rcls/gpsfreak/gpsfreak-sch.pdf

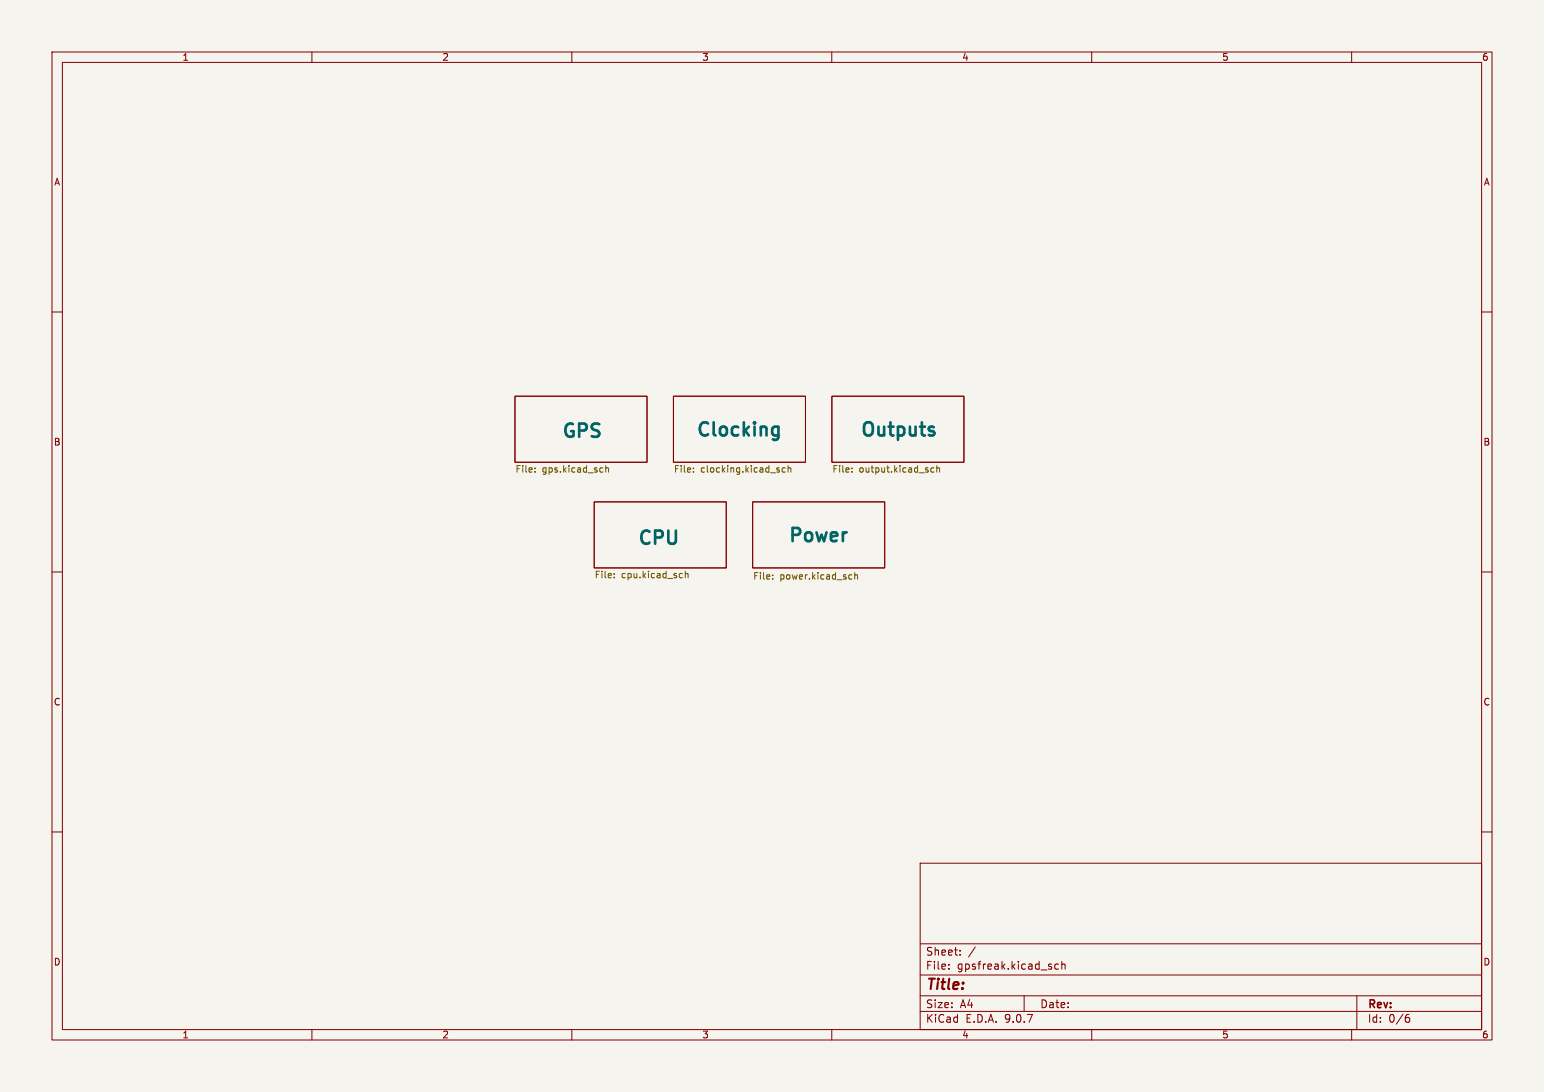
[picture p3: page 1]

Id: 0/6 Title: File: gpsfreak.kicad_sch Sheet: / Clocking

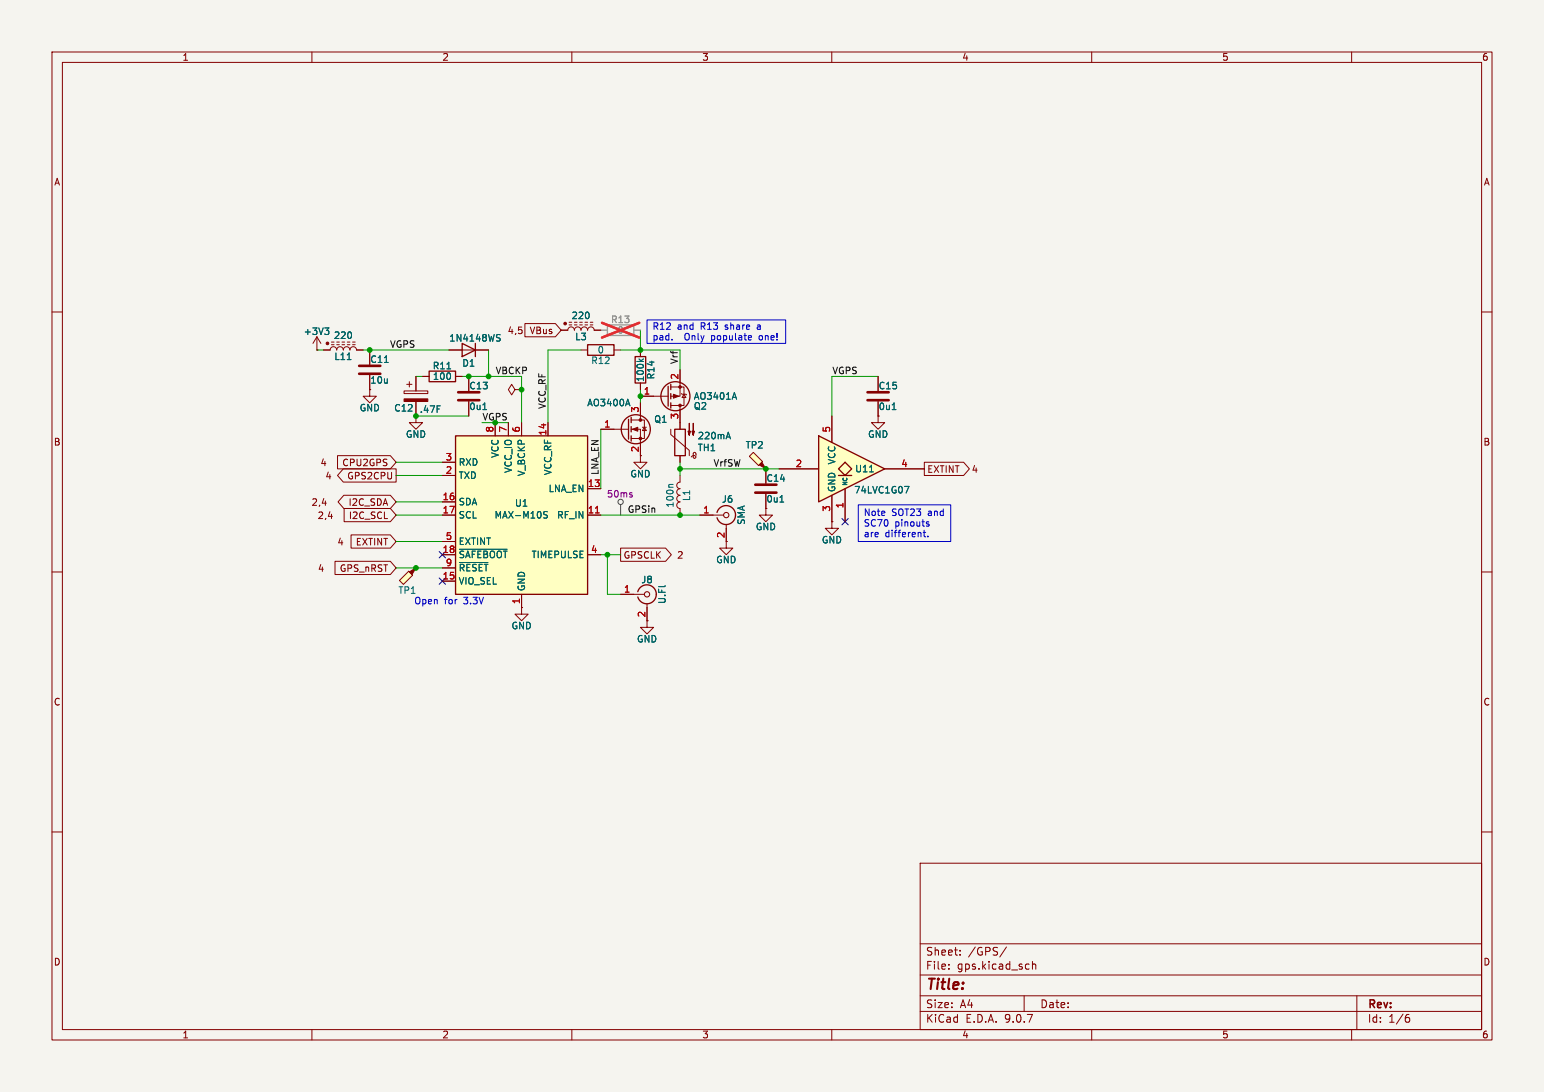
[picture p4: page 2]

Id: 1/6 Title: File: gps.kicad_sch Sheet: /GPS/

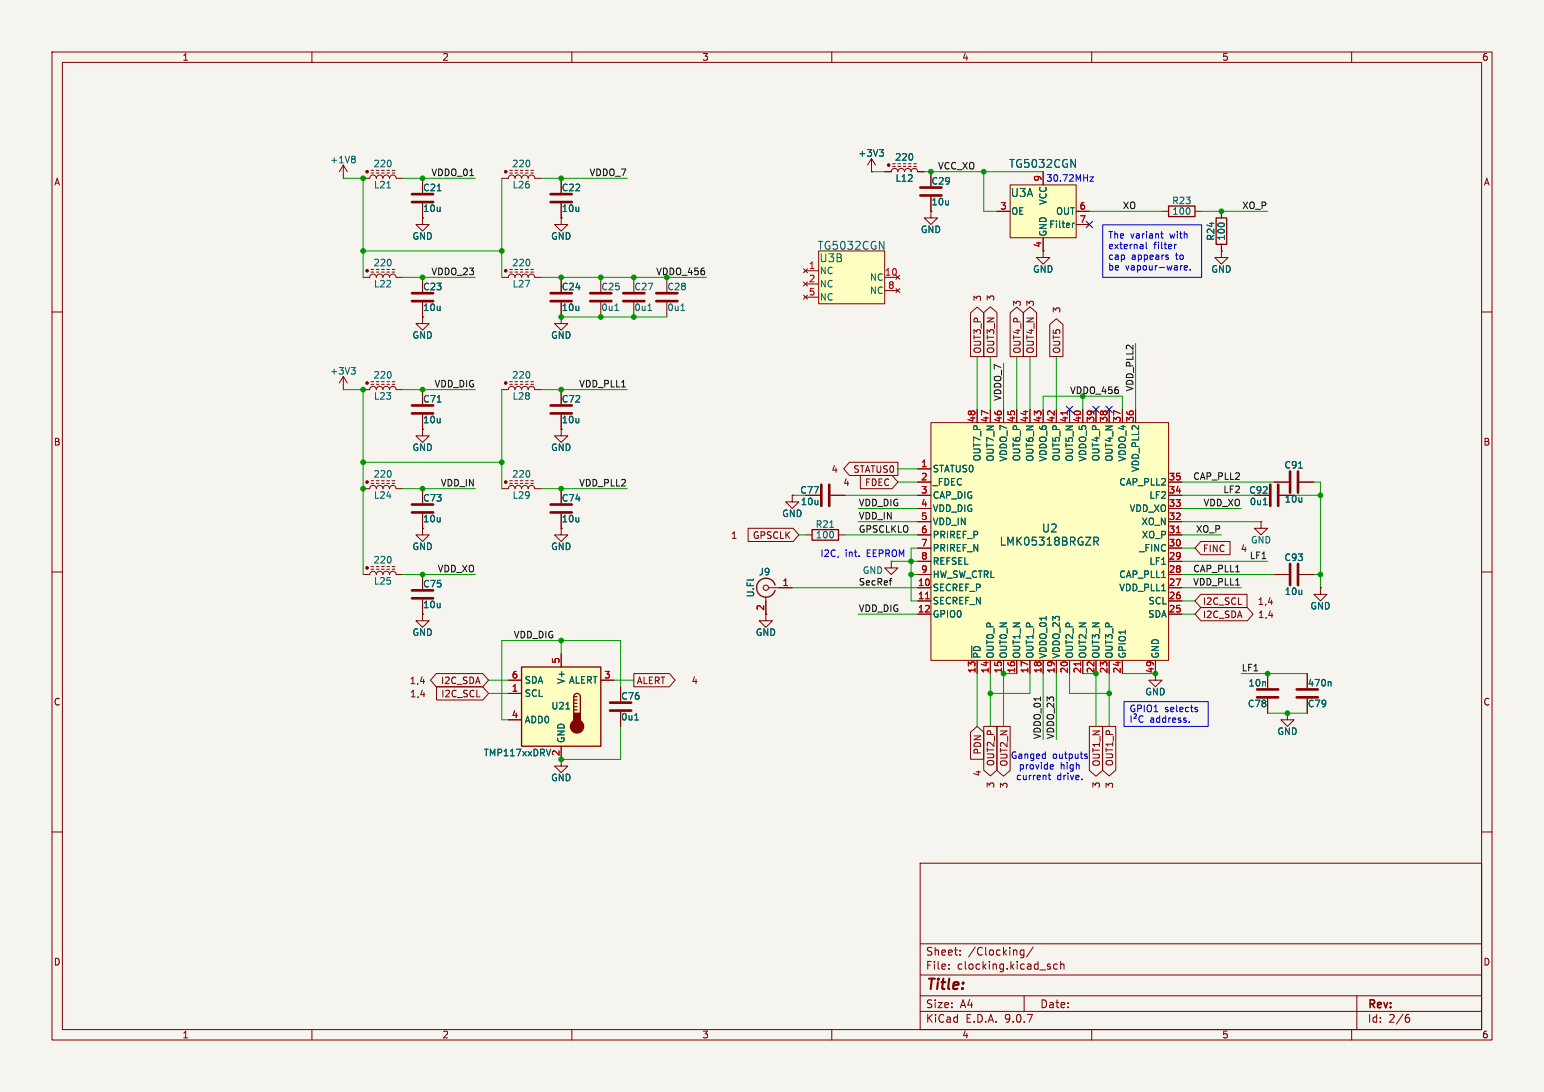
[picture p5: page 3]

XO VDDO_01
be vapour-ware. Ganged outputs provide high

Id: 2/6 Title: File: clocking.kicad_sch Sheet: /Clocking/ GND

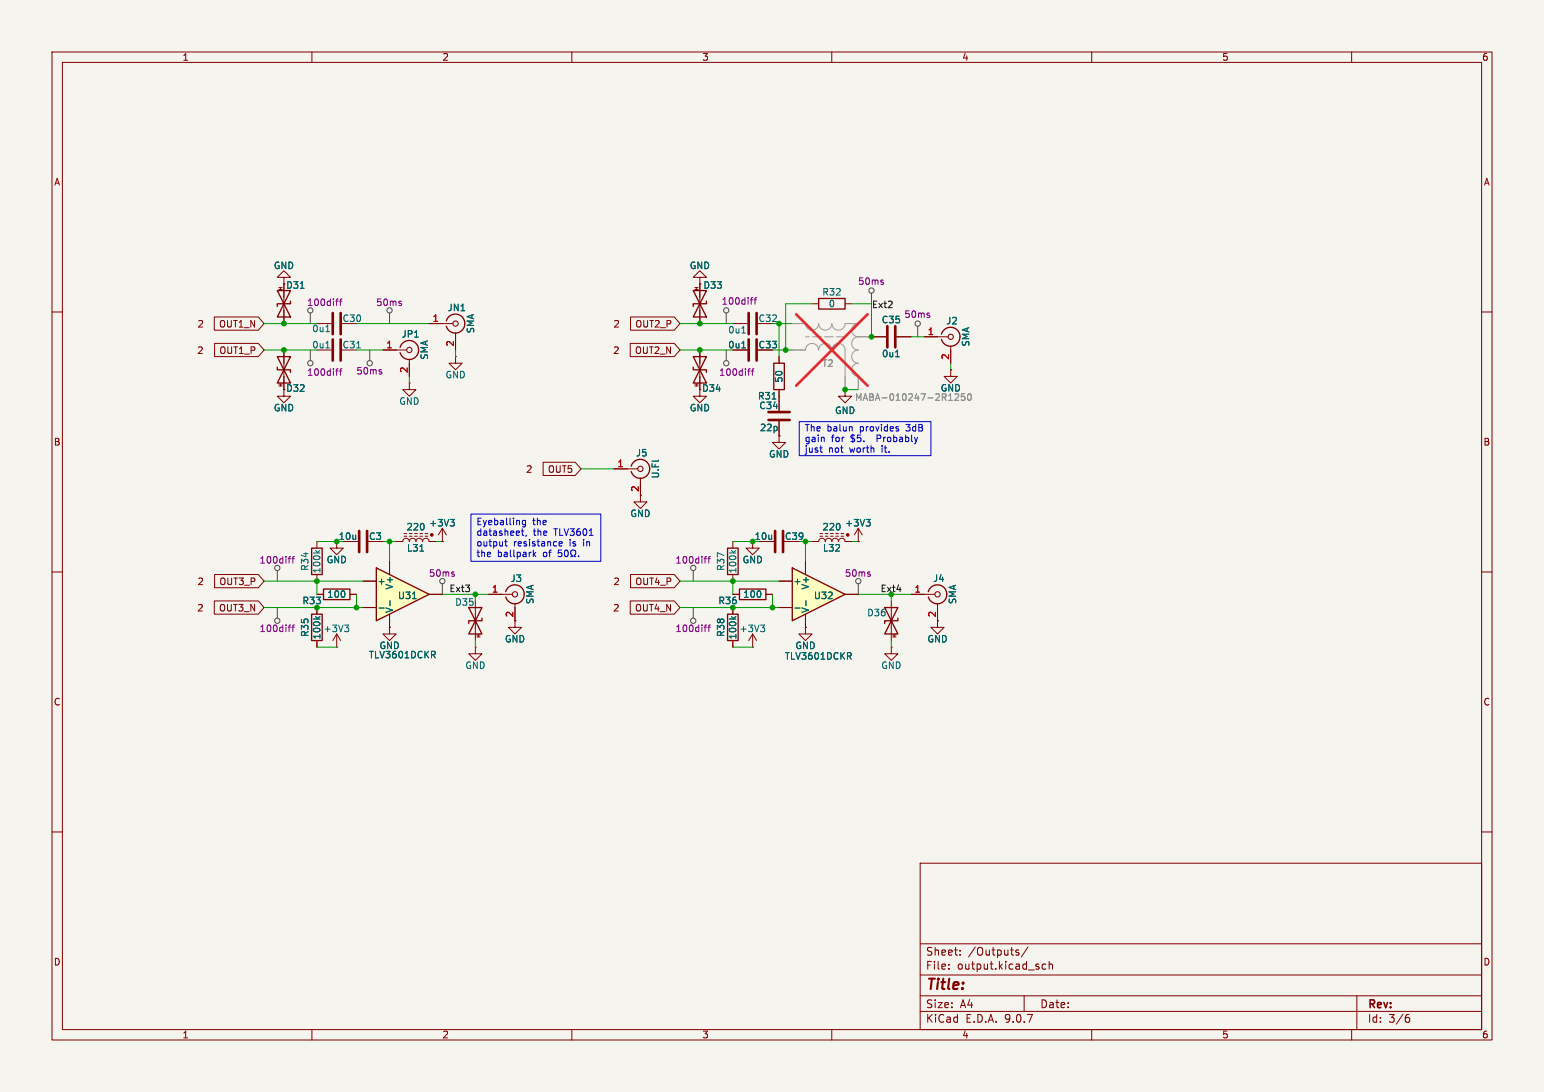
[picture p6: page 4]

Id: 3/6 Title: File: output.kicad_sch Sheet: /Outputs/

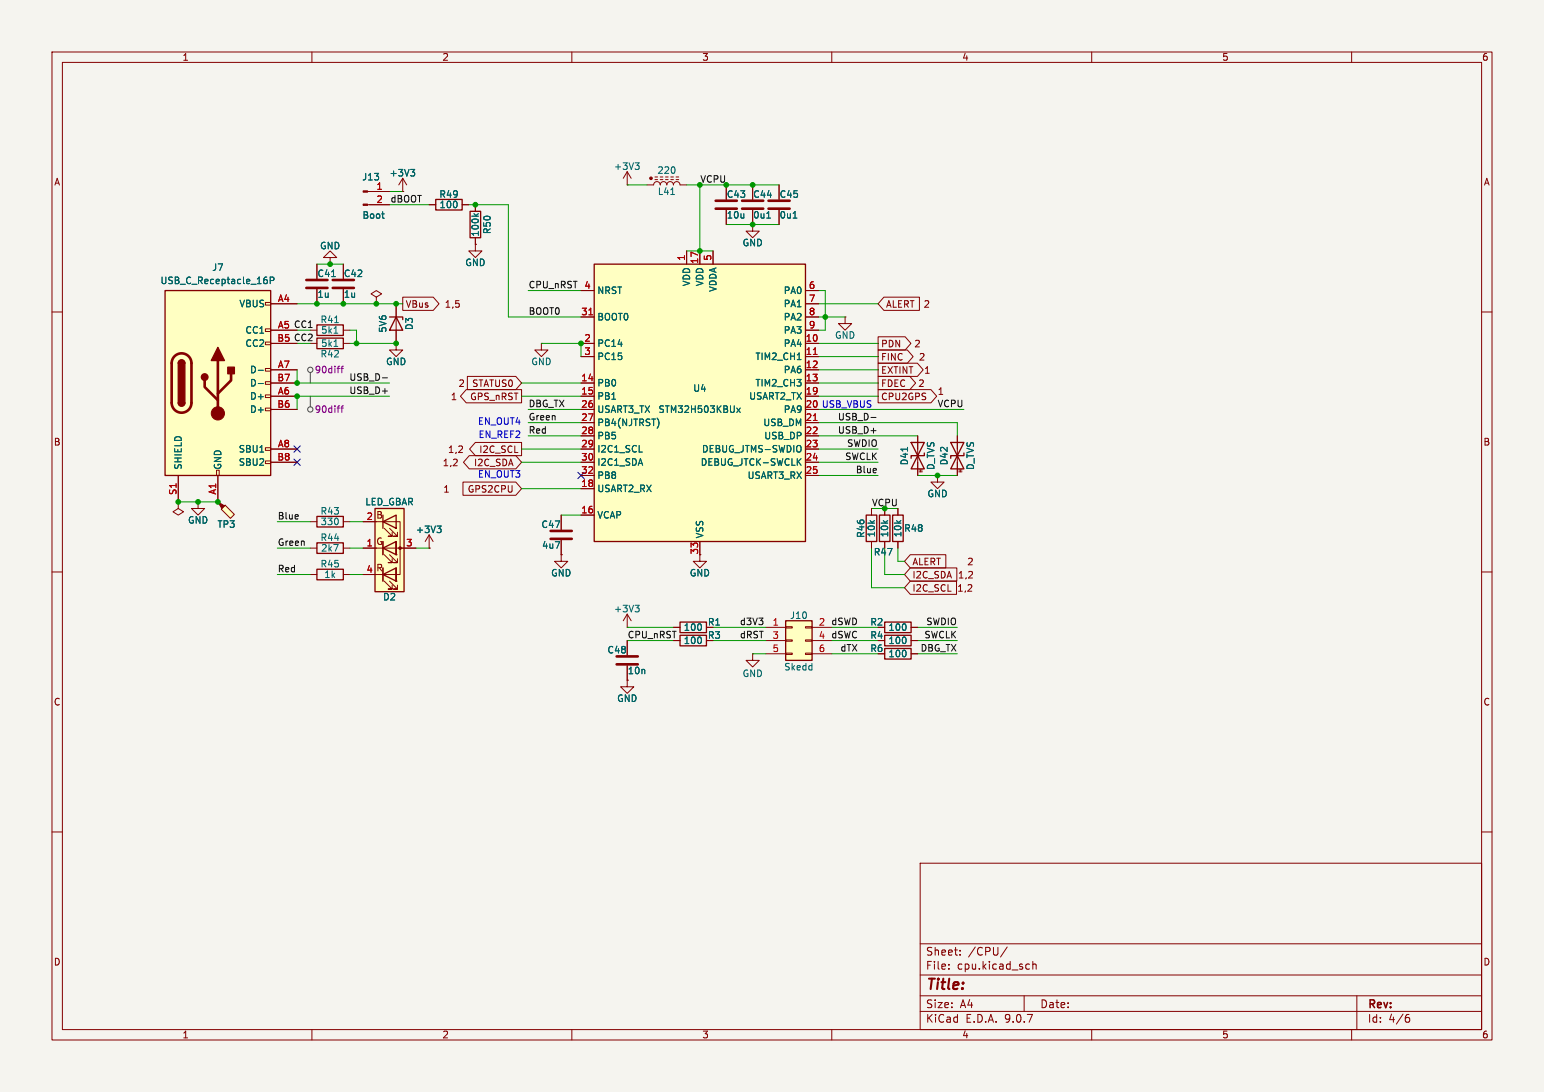
[picture p7: page 5]

Id: 4/6 Title: File: cpu.kicad_sch Sheet: /CPU/ GND

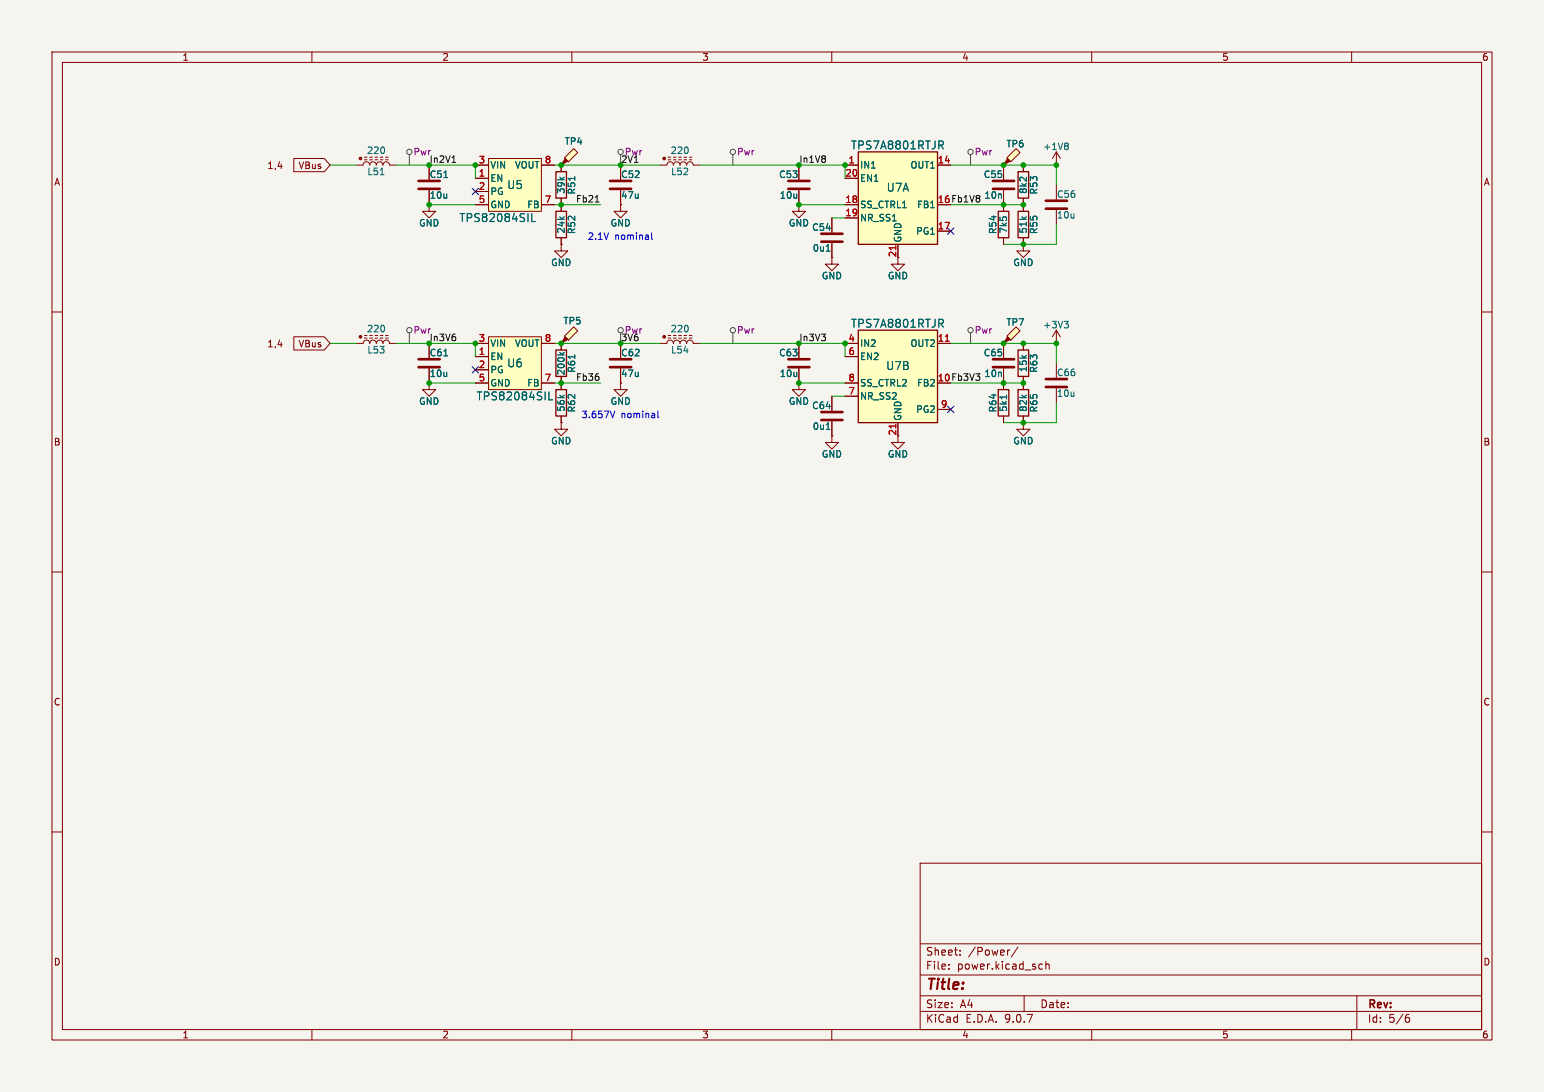
[picture p8: page 6]

Id: 5/6 Title: File: power.kicad_sch Sheet: /Power/
