rcls/gpsfreak/gpsfreak.kicad_pcb

## KiCad design gpsfreak.kicad_pcb (2026-06-07)

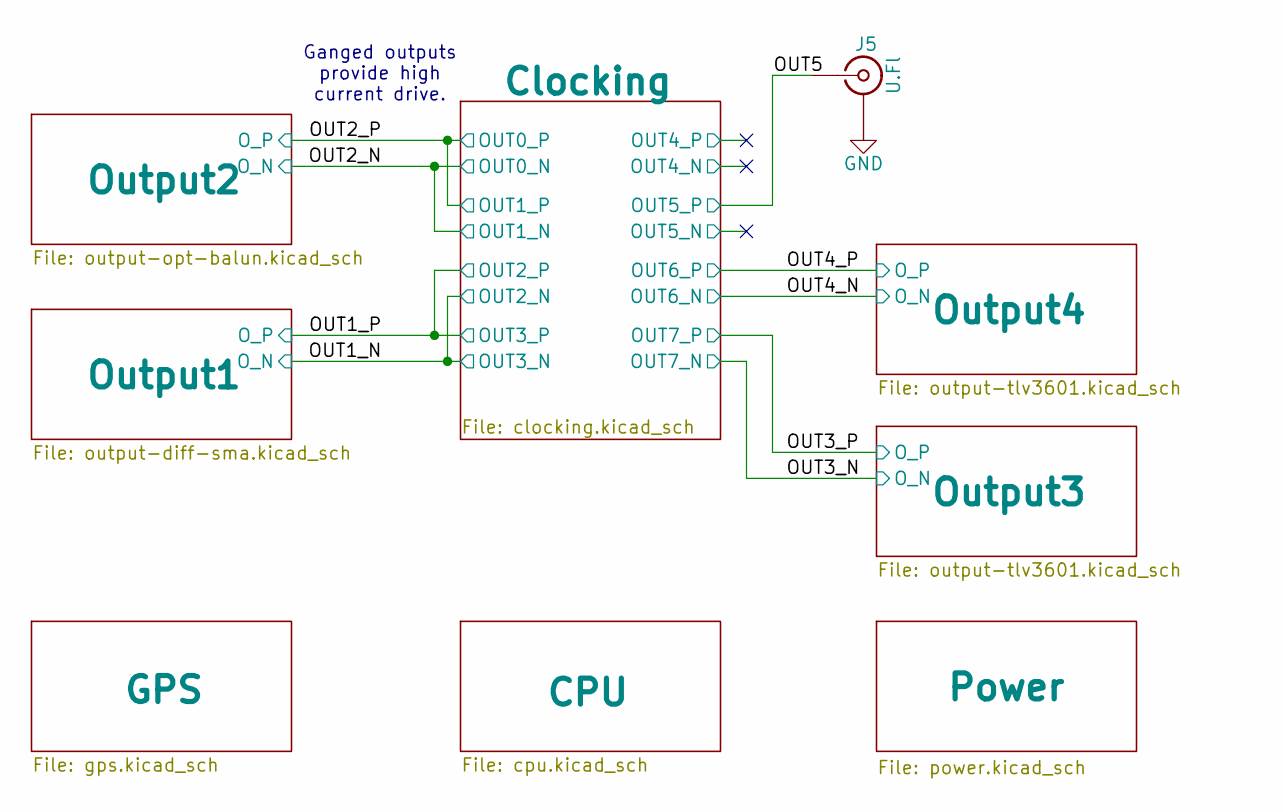
[picture p18: schematic gpsfreak.kicad_sch]

Parts:
J5: U.Fl; U.FL_Hirose_U.FL-R-SMT-1_Vertical

Connections:
/OUT5: J5.1 (In); also elsewhere on the board
GND: J5.2 (Ext); also elsewhere on the board

Notes on the sheet:
Ganged outputs provide high current drive.

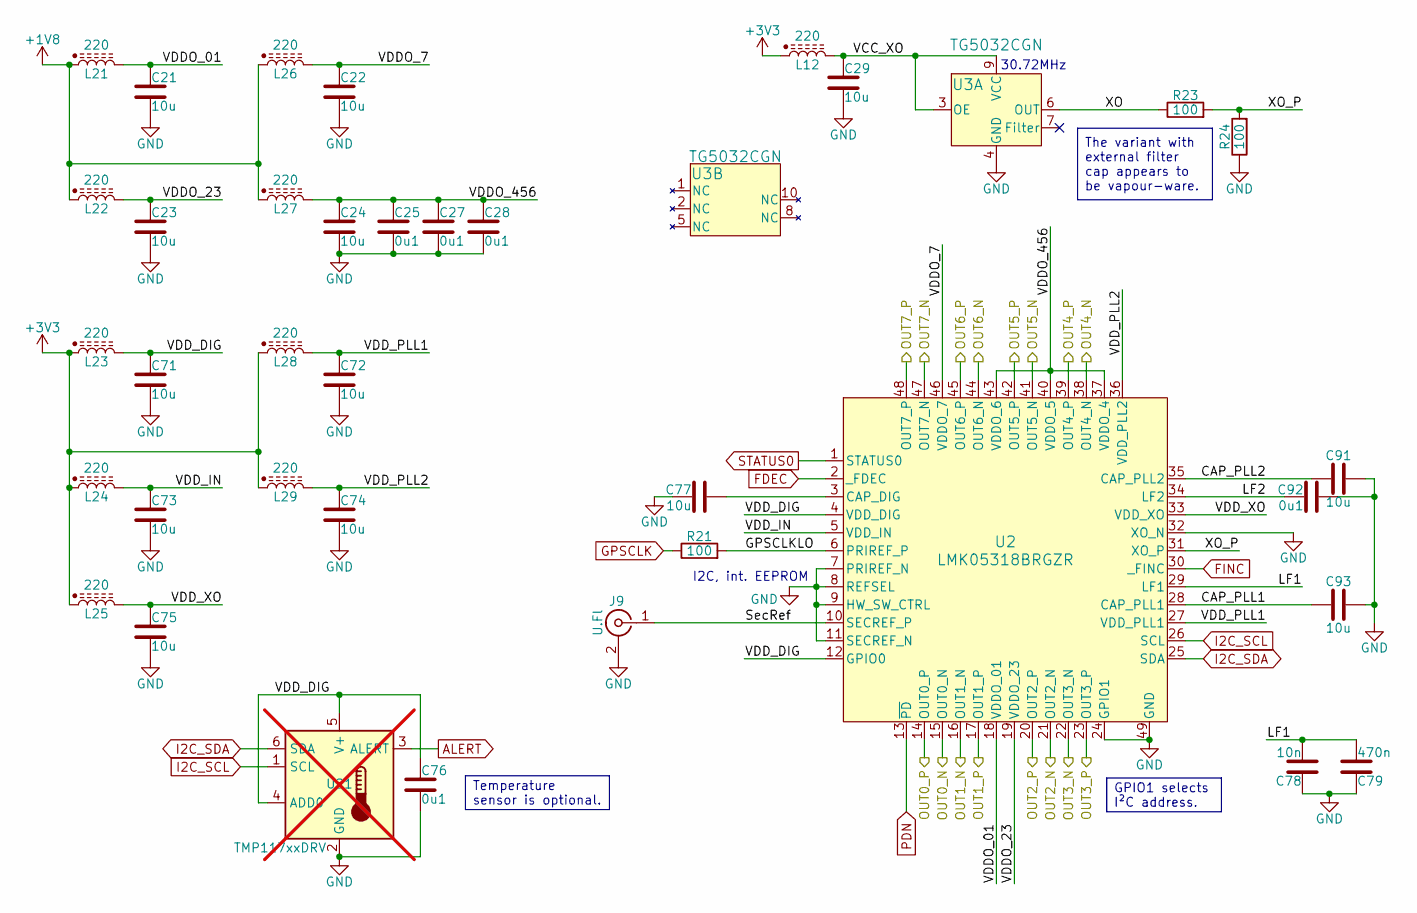
[picture p19: schematic clocking.kicad_sch]

Parts:
C21, C22, C23, C24, C29, C71, C72, C73, C74, C75, C77, C91, C93: 10u; C_0402_1005Metric; LCSC C15525
C25, C27, C28, C76: 0u1; C_0402_1005Metric; LCSC C307331
C78: 10n; C_0402_1005Metric_Pad0.74x0.62mm_HandSolder; LCSC C3855387
C79: 470n; C_1206_3216Metric; LCSC C21082486
C92: 0u1; C0704; LCSC C20044553
J9: U.Fl; U.FL_Hirose_U.FL-R-SMT-1_Vertical
L12, L21, L22, L23, L24, L25, L26, L27, L28, L29: 220; L_0603_1608Metric; LCSC C14709
R21, R23, R24: 100; R_0402_1005Metric; LCSC C25076
U2: LMK05318BRGZR; QFN-48-1EP_7x7mm_P0.5mm_EP5.1x5.1mm; LCSC C3611586
U3: TG5032CGN; QFN10_TG5032CGN 40.0000M-CAGHNA0_EPS; LCSC C2891970
U21: TMP117xxDRV; WSON-6-1EP_2x2mm_P0.65mm_EP1x1.6mm; not fitted

Connections:
+1V8: L21.1, L22.1, L26.1, L27.1; also elsewhere on the board
+3V3: L12.1, L23.1, L24.1, L25.1, L28.1, L29.1; also elsewhere on the board
/Clocking/CAP_PLL1: C93.2, U2.28 (CAP_PLL1)
/Clocking/CAP_PLL2: C91.2, U2.35 (CAP_PLL2)
/Clocking/GPSCLKLO: R21.2, U2.6 (PRIREF_P)
/Clocking/LF1: C78.1, C79.1, U2.29 (LF1)
/Clocking/LF2: C92.1, U2.34 (LF2)
/Clocking/OUT4_N: U2.38 (OUT4_N)
/Clocking/OUT4_P: U2.39 (OUT4_P)
/Clocking/OUT5_N: U2.41 (OUT5_N)
/Clocking/SecRef: J9.1 (In), U2.10 (SECREF_P)
/Clocking/VCC_XO: C29.1, L12.2, U3.3 (OE), U3.9 (VCC)
/Clocking/VDDO_01: C21.1, L21.2, U2.18 (VDDO_01)
/Clocking/VDDO_7: C22.1, L26.2, U2.46 (VDDO_7)
/Clocking/VDDO_23: C23.1, L22.2, U2.19 (VDDO_23)
/Clocking/VDDO_456: C24.1, C25.1, C27.1, C28.1, L27.2, U2.37 (VDDO_4), U2.40 (VDDO_5), U2.43 (VDDO_6)
/Clocking/VDD_DIG: C71.1, C76.1, L23.2, U2.4 (VDD_DIG), U2.12 (GPIO0), U21.4 (ADD0), U21.5 (V+)
/Clocking/VDD_IN: C73.1, L24.2, U2.5 (VDD_IN)
/Clocking/VDD_PLL1: C72.1, L28.2, U2.27 (VDD_PLL1)
/Clocking/VDD_PLL2: C74.1, L29.2, U2.36 (VDD_PLL2)
/Clocking/VDD_XO: C75.1, L25.2, U2.33 (VDD_XO)
/Clocking/XO: R23.1, U3.6 (OUT)
/Clocking/XO_P: R23.2, R24.2, U2.31 (XO_P)
/OUT1_N: U2.21 (OUT2_N), U2.22 (OUT3_N); also elsewhere on the board
/OUT1_P: U2.20 (OUT2_P), U2.23 (OUT3_P); also elsewhere on the board
/OUT2_N: U2.15 (OUT0_N), U2.16 (OUT1_N); also elsewhere on the board
/OUT2_P: U2.14 (OUT0_P), U2.17 (OUT1_P); also elsewhere on the board
/OUT3_N: U2.47 (OUT7_N); also elsewhere on the board
/OUT3_P: U2.48 (OUT7_P); also elsewhere on the board
/OUT4_N: U2.44 (OUT6_N); also elsewhere on the board
/OUT4_P: U2.45 (OUT6_P); also elsewhere on the board
/OUT5: U2.42 (OUT5_P); also elsewhere on the board
ALERT: U21.3 (ALERT); also elsewhere on the board
FDEC: U2.2 (_FDEC); also elsewhere on the board
FINC: U2.30 (_FINC); also elsewhere on the board
GND: C21.2, C22.2, C23.2, C24.2, C25.2, C27.2, C28.2, C29.2, C71.2, C72.2, C73.2, C74.2, C75.2, C76.2, C77.1, C78.2, C79.2, C91.1, C92.2, C93.1, J9.2 (Ext), R24.1, U2.7 (PRIREF_N), U2.8 (REFSEL), U2.9 (HW_SW_CTRL), U2.11 (SECREF_N), U2.24 (GPIO1), U2.32 (XO_N), U2.49 (GND), U3.4 (GND), U21.2 (GND), U21.7 (GND); also elsewhere on the board
GPSCLK: R21.1; also elsewhere on the board
I2C_SCL: U2.26 (SCL), U21.1 (SCL); also elsewhere on the board
I2C_SDA: U2.25 (SDA), U21.6 (SDA); also elsewhere on the board
unnamed: C77.2, U2.3 (CAP_DIG)
PDN: U2.13 (~PD); also elsewhere on the board
STATUS0: U2.1 (STATUS0); also elsewhere on the board

Notes on the sheet:
I2C, int. EEPROM
30.72MHz
Temperature sensor is optional.
GPIO1 selects I²C address.
The variant with external filter cap appears to be vapour-ware.

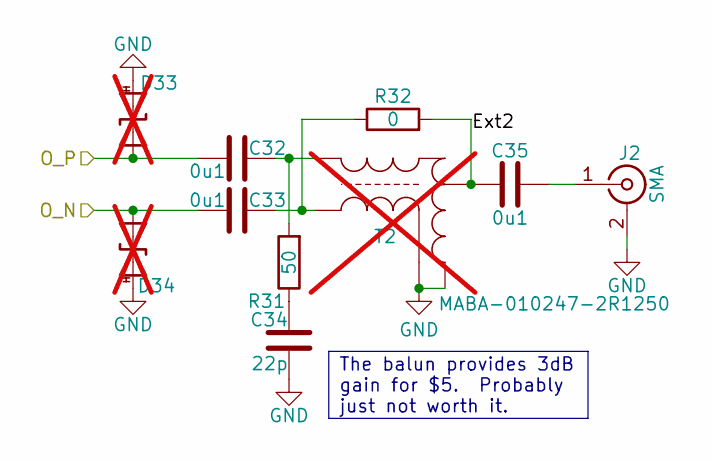
[picture p20: schematic output-opt-balun.kicad_sch]

Parts:
C32, C33, C35: 0u1; C_0402_1005Metric; LCSC C307331
C34: 22p; C_0402_1005Metric; LCSC C1555
D33, D34: D_TVS; HHS_0402; not fitted
J2: SMA; SMA_EdgeMount
R31: 50; R_0603_1608Metric; LCSC C23185
R32: 0; R_0603_1608Metric; LCSC C21189
T2: MABA-010247-2R1250; XFMR_MABA-007159-000000; LCSC C3305191; not fitted

Connections:
/OUT2_N: C33.1, D34.1 (A1); also elsewhere on the board
/OUT2_P: C32.1, D33.1 (A1); also elsewhere on the board
/Output2/Ext2: C35.1, R32.2, T2.4
GND: C34.1, D33.2 (A2), D34.2 (A2), J2.2 (Ext), T2.2, T2.5; also elsewhere on the board
unnamed: C32.2, R31.2, T2.1
unnamed: C33.2, R32.1, T2.3
unnamed: C34.2, R31.1
unnamed: C35.2, J2.1 (In)

Notes on the sheet:
The balun provides 3dB gain for $5. Probably just not worth it.

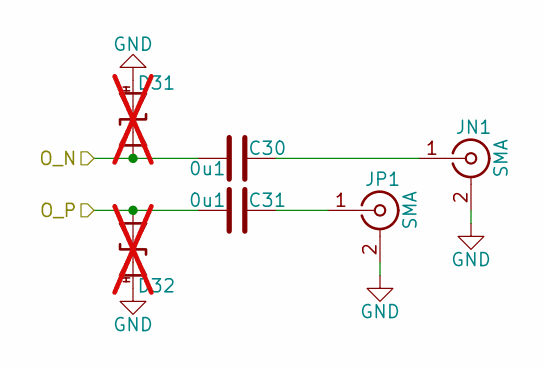
[picture p21: schematic output-diff-sma.kicad_sch]

Parts:
C30, C31: 0u1; C_0402_1005Metric; LCSC C307331
D31, D32: D_TVS; HHS_0402; not fitted
JN1: SMA; SMA_EdgeMount
JP1: SMA; SMA_EdgeMount

Connections:
/OUT1_N: C30.1, D31.1 (A1); also elsewhere on the board
/OUT1_P: C31.1, D32.1 (A1); also elsewhere on the board
GND: D31.2 (A2), D32.2 (A2), JN1.2 (Ext), JP1.2 (Ext); also elsewhere on the board
unnamed: C30.2, JN1.1 (In)
unnamed: C31.2, JP1.1 (In)

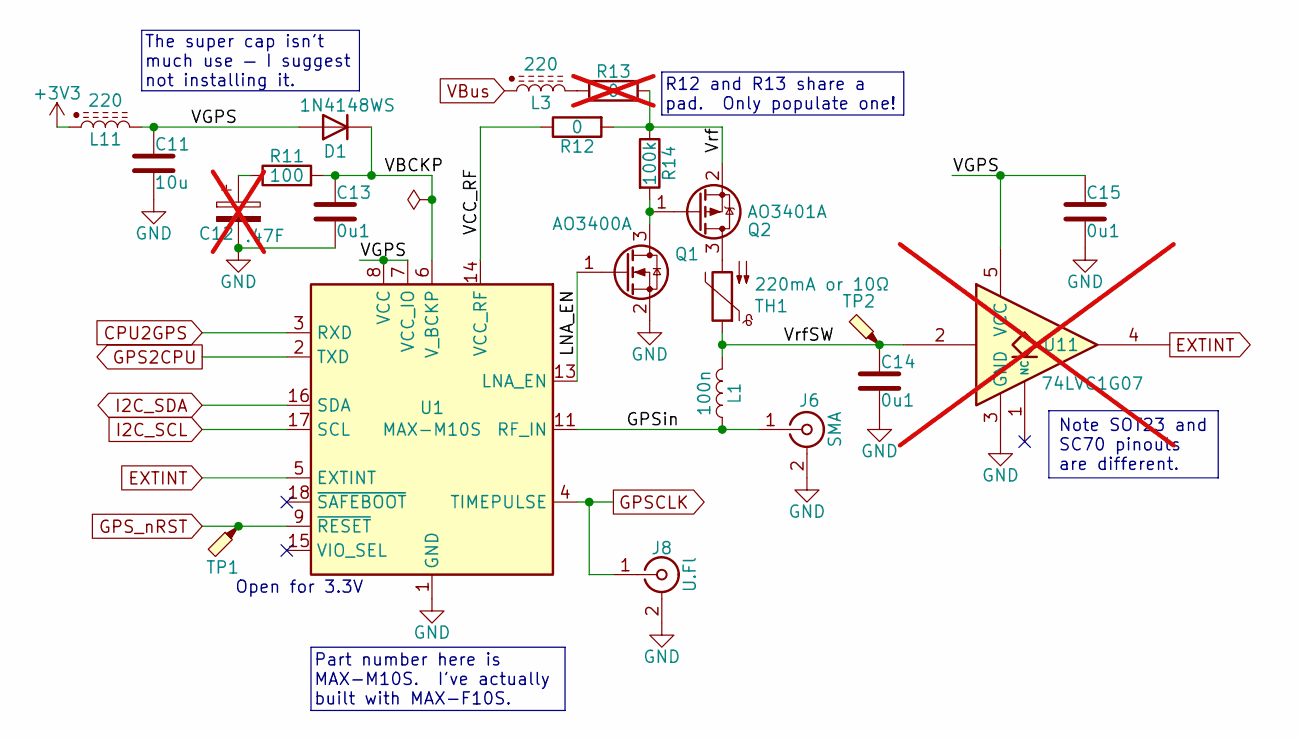
[picture p22: schematic gps.kicad_sch]

Parts:
C11: 10u; C_0402_1005Metric; LCSC C15525
C12: .47F; CP_Radial_D13.5mm_P5.00mm; not fitted
C13, C14, C15: 0u1; C_0402_1005Metric; LCSC C307331
D1: 1N4148WS; D_SOD-323; LCSC C2128
J6: SMA; SMA_EdgeMount
J8: U.Fl; U.FL_Hirose_U.FL-R-SMT-1_Vertical
L1: 100n; HHS_0402; LCSC C3224079
L3, L11: 220; L_0603_1608Metric; LCSC C14709
Q1: AO3400A; SOT-23; LCSC C20917
Q2: AO3401A; SOT-23; LCSC C15127
R11: 100; R_0402_1005Metric; LCSC C25076
R12: 0; R_0603_1608Metric; LCSC C21189
R13: 0; R_0603_1608Metric; not fitted
R14: 100k; R_0402_1005Metric; LCSC C25741
TH1: 220mA or 10Ω; R_0603_1608Metric; LCSC C22859
TP1, TP2: TestPoint_Probe; TestPoint
U1: MAX-M10S; ublox_MAX; LCSC C4153167
U11: 74LVC1G07; SOT-23-5; not fitted

Connections:
+3V3: L11.1; also elsewhere on the board
/GPS/GPSin: J6.1 (In), L1.1, U1.11 (RF_IN)
/GPS/LNA_EN: Q1.1 (G), U1.13 (LNA_EN)
/GPS/VBCKP: C13.1, D1.1 (K), R11.2, U1.6 (V_BCKP)
/GPS/VCC_RF: R12.1, U1.14 (VCC_RF)
/GPS/VGPS: C11.1, C15.1, D1.2 (A), L11.2, U1.7 (VCC_IO), U1.8 (VCC), U11.5 (VCC)
/GPS/Vrf: Q2.2 (S), R12.2, R13.2, R14.1
/GPS/VrfSW: C14.1, L1.2, TH1.1, TP2.1, U11.2
CPU2GPS: U1.3 (RXD); also elsewhere on the board
EXTINT: U1.5 (EXTINT), U11.4; also elsewhere on the board
GND: C11.2, C12.2, C13.2, C14.2, C15.2, J6.2 (Ext), J8.2 (Ext), Q1.2 (S), U1.1 (GND), U1.10 (GND), U1.12 (GND), U11.3 (GND); also elsewhere on the board
GPS2CPU: U1.2 (TXD); also elsewhere on the board
GPSCLK: J8.1 (In), U1.4 (TIMEPULSE); also elsewhere on the board
GPS_nRST: TP1.1, U1.9 (~RESET); also elsewhere on the board
I2C_SCL: U1.17 (SCL); also elsewhere on the board
I2C_SDA: U1.16 (SDA); also elsewhere on the board
unnamed: C12.1, R11.1
unnamed: L3.2, R13.1
unnamed: Q1.3 (D), Q2.1 (G), R14.2
unnamed: Q2.3 (D), TH1.2
VBus: L3.1; also elsewhere on the board

Notes on the sheet:
Open for 3.3V
Part number here is MAX-M10S. I've actually built with MAX-F10S.
The super cap isn't much use — I suggest not installing it.
R12 and R13 share a pad. Only populate one!
Note SOT23 and SC70 pinouts are different.

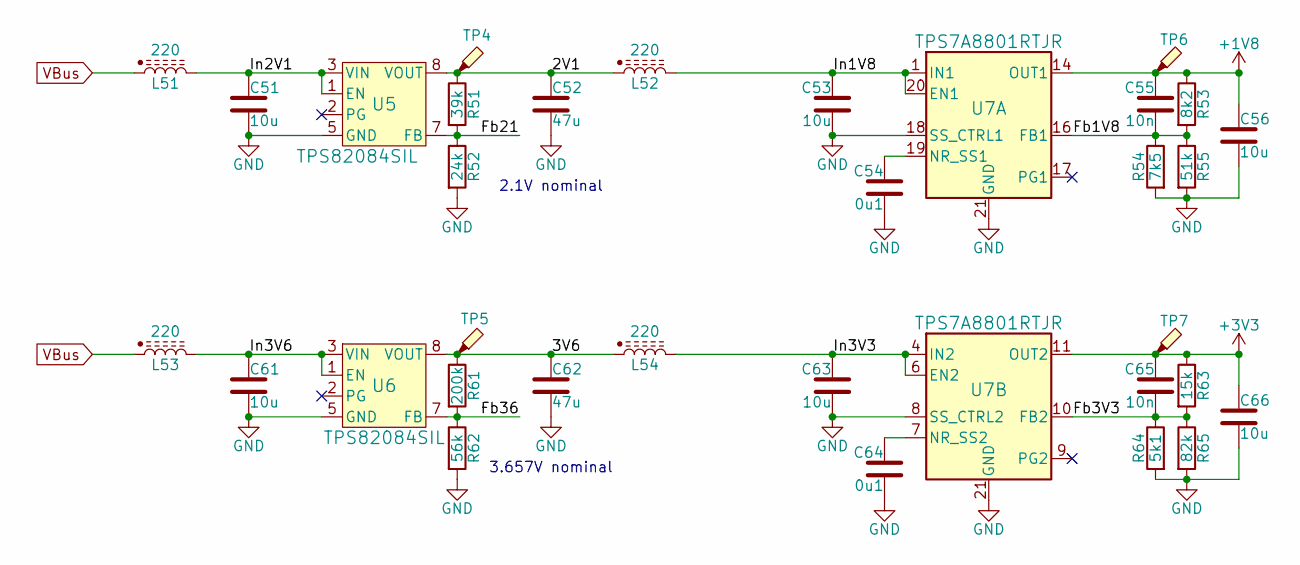
[picture p23: schematic power.kicad_sch]

Parts:
C51, C53, C56, C61, C63, C66: 10u; C_0402_1005Metric; LCSC C15525
C52, C62: 47u; C_0805_2012Metric; LCSC C16780
C54, C64: 0u1; C_0402_1005Metric; LCSC C307331
C55, C65: 10n; C_0402_1005Metric; LCSC C15195
L51, L52, L53, L54: 220; L_0603_1608Metric; LCSC C14709
R51: 39k; R_0402_1005Metric; LCSC C25783
R52: 24k; R_0402_1005Metric; LCSC C25769
R53: 8k2; R_0402_1005Metric; LCSC C25924
R54: 7k5; R_0402_1005Metric; LCSC C25918
R55: 51k; R_0603_1608Metric; LCSC C23196
R61: 200k; R_0402_1005Metric; LCSC C25764
R62: 56k; R_0402_1005Metric; LCSC C25796
R63: 15k; R_0402_1005Metric; LCSC C25756
R64: 5k1; R_0402_1005Metric; LCSC C25905
R65: 82k; R_0603_1608Metric; LCSC C23254
TP4, TP5, TP6, TP7: TestPoint_Probe; TestPoint
U5, U6: TPS82084SIL; SIL0008C_SMD_NV; LCSC C468248
U7: TPS7A8801RTJR; QFN-20-1EP_4x4mm_P0.5mm_EP2.7x2.7mm; LCSC C485919

Connections:
+1V8: C55.1, C56.1, R53.1, TP6.1, U7.14 (OUT1), U7.15 (OUT1); also elsewhere on the board
+3V3: C65.1, C66.1, R63.1, TP7.1, U7.11 (OUT2), U7.12 (OUT2); also elsewhere on the board
/Power/2V1: C52.1, L52.1, R51.1, TP4.1, U5.8 (VOUT)
/Power/3V6: C62.1, L54.1, R61.1, TP5.1, U6.8 (VOUT)
/Power/Fb1V8: C55.2, R53.2, R54.1, R55.1, U7.16 (FB1)
/Power/Fb3V3: C65.2, R63.2, R64.1, R65.1, U7.10 (FB2)
/Power/Fb21: R51.2, R52.1, U5.7 (FB)
/Power/Fb36: R61.2, R62.1, U6.7 (FB)
/Power/In1V8: C53.1, L52.2, U7.1 (IN1), U7.2 (IN1), U7.20 (EN1)
/Power/In2V1: C51.1, L51.2, U5.1 (EN), U5.3 (VIN), U5.4 (VIN)
/Power/In3V3: C63.1, L54.2, U7.4 (IN2), U7.5 (IN2), U7.6 (EN2)
/Power/In3V6: C61.1, L53.2, U6.1 (EN), U6.3 (VIN), U6.4 (VIN)
GND: C51.2, C52.2, C53.2, C54.2, C56.2, C61.2, C62.2, C63.2, C64.2, C66.2, R52.2, R54.2, R55.2, R62.2, R64.2, R65.2, U5.5 (GND), U5.6 (GND), U5.9 (PAD), U6.5 (GND), U6.6 (GND), U6.9 (PAD), U7.3 (GND), U7.8 (SS_CTRL2), U7.13 (GND), U7.18 (SS_CTRL1), U7.21 (GND); also elsewhere on the board
unnamed: C54.1, U7.19 (NR_SS1)
unnamed: C64.1, U7.7 (NR_SS2)
VBus: L51.1, L53.1; also elsewhere on the board

Notes on the sheet:
3.657V nominal
2.1V nominal

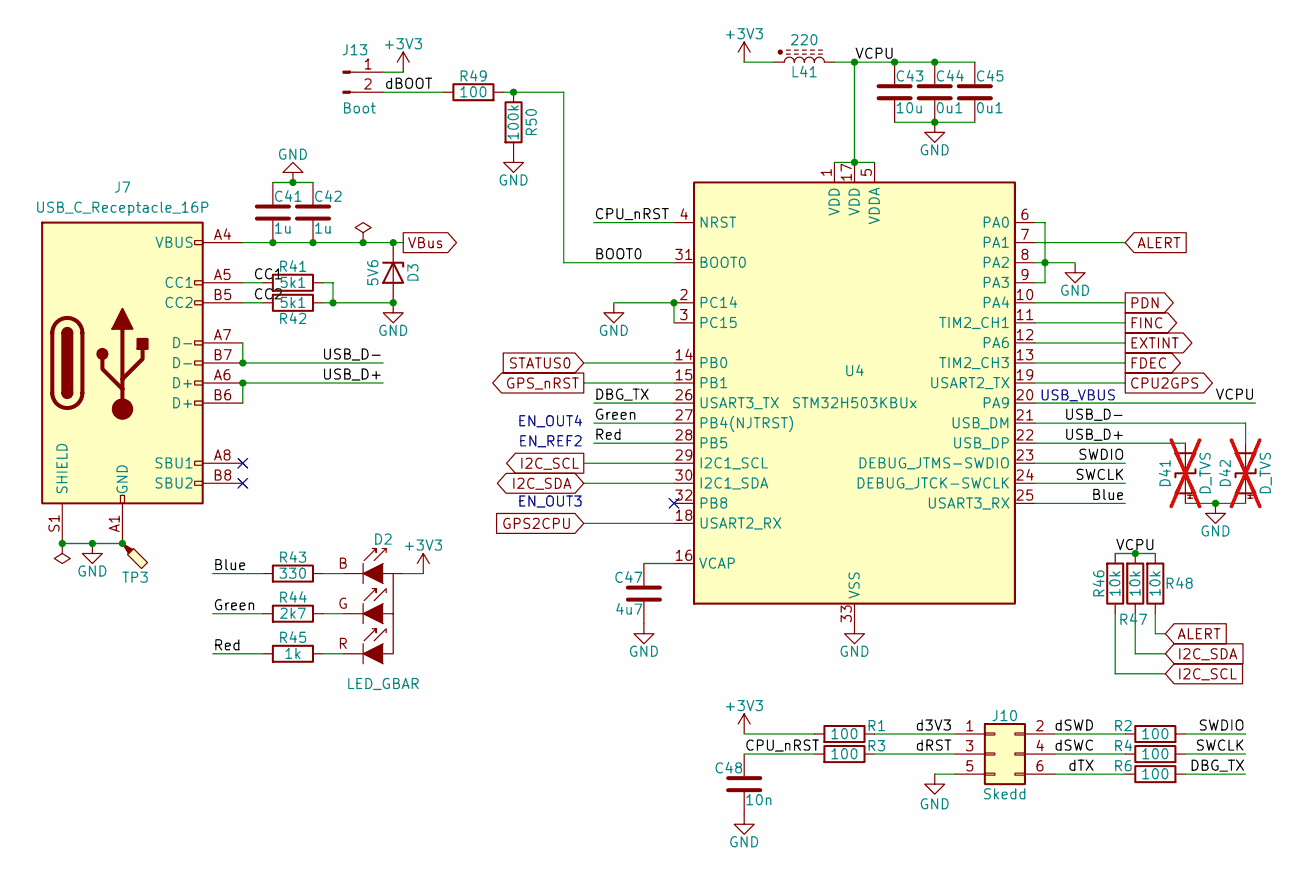
[picture p24: schematic cpu.kicad_sch]

Parts:
C41, C42: 1u; C_0402_1005Metric; LCSC C52923
C43: 10u; C_0402_1005Metric; LCSC C15525
C44, C45: 0u1; C_0402_1005Metric; LCSC C307331
C47: 4u7; C_0402_1005Metric; LCSC C23733
C48: 10n; C_0402_1005Metric; LCSC C15195
D2: LED_GBAR; LED_RGB_SIDE; LCSC C389528
D3: 5V6; D_SOD-323; LCSC C19077435
D41, D42: D_TVS; HHS_0402; not fitted
J7: USB_C_Receptacle_16P; USB_C_Receptacle_GCT_USB4105-xx-A_16P_TopMnt_Horizontal; LCSC C2765186
J10: Skedd; Skedd6
J13: Boot; PinHeader_1x02_P2.54mm_Vertical
L41: 220; L_0603_1608Metric; LCSC C14709
R1, R2, R3, R4, R6, R49: 100; R_0402_1005Metric; LCSC C25076
R41, R42: 5k1; R_0402_1005Metric; LCSC C25905
R43: 330; R_0603_1608Metric; LCSC C23138
R44: 2k7; R_0603_1608Metric; LCSC C13167
R45: 1k; R_0603_1608Metric; LCSC C21190
R46, R47, R48: 10k; R_0402_1005Metric; LCSC C25744
R50: 100k; R_0402_1005Metric; LCSC C25741
TP3: TestPoint_Probe; TestPoint
U4: STM32H503KBUx; QFN-32-1EP_5x5mm_P0.5mm_EP3.45x3.45mm; LCSC C22385521

Connections:
+3V3: D2.1 (C), J13.1, L41.1, R1.2; also elsewhere on the board
/CPU/BOOT0: R49.2, R50.1, U4.31 (BOOT0)
/CPU/Blue: R43.2, U4.25 (USART3_RX)
/CPU/CC1: J7.A5 (CC1), R41.2
/CPU/CC2: J7.B5 (CC2), R42.2
/CPU/CPU_nRST: C48.1, R3.2, U4.4 (NRST)
/CPU/DBG_TX: R6.2, U4.26 (USART3_TX)
/CPU/Green: R44.2, U4.27 (PB4(NJTRST))
/CPU/Red: R45.2, U4.28 (PB5)
/CPU/SWCLK: R4.2, U4.24 (DEBUG_JTCK-SWCLK)
/CPU/SWDIO: R2.2, U4.23 (DEBUG_JTMS-SWDIO)
/CPU/USB_D+: D41.1 (A1), J7.A6 (D+), J7.B6 (D+), U4.22 (USB_DP)
/CPU/USB_D-: D42.1 (A1), J7.A7 (D-), J7.B7 (D-), U4.21 (USB_DM)
/CPU/VCPU: C43.1, C44.1, C45.1, L41.2, R46.2, R47.2, R48.2, U4.1 (VDD), U4.5 (VDDA), U4.17 (VDD), U4.20 (PA9)
/CPU/d3V3: J10.1, R1.1
/CPU/dBOOT: J13.2, R49.1
/CPU/dRST: J10.3, R3.1
/CPU/dSWC: J10.4, R4.1
/CPU/dSWD: J10.2, R2.1
/CPU/dTX: J10.6, R6.1
ALERT: R48.1, U4.7 (PA1); also elsewhere on the board
CPU2GPS: U4.19 (USART2_TX); also elsewhere on the board
EXTINT: U4.12 (PA6); also elsewhere on the board
FDEC: U4.13 (TIM2_CH3); also elsewhere on the board
FINC: U4.11 (TIM2_CH1); also elsewhere on the board
GND: C41.1, C42.1, C43.2, C44.2, C45.2, C47.2, C48.2, D3.2 (A), D41.2 (A2), D42.2 (A2), J7.A1 (GND), J7.A12 (GND), J7.B1 (GND), J7.B12 (GND), J7.S1 (SHIELD), J10.5, R41.1, R42.1, R50.2, TP3.1, U4.2 (PC14), U4.3 (PC15), U4.6 (PA0), U4.8 (PA2), U4.9 (PA3), U4.33 (VSS); also elsewhere on the board
GPS2CPU: U4.18 (USART2_RX); also elsewhere on the board
GPS_nRST: U4.15 (PB1); also elsewhere on the board
I2C_SCL: R46.1, U4.29 (I2C1_SCL); also elsewhere on the board
I2C_SDA: R47.1, U4.30 (I2C1_SDA); also elsewhere on the board
unnamed: D2.2 (B), R43.1
unnamed: D2.3 (G), R44.1
unnamed: D2.4 (R), R45.1
unnamed: C47.1, U4.16 (VCAP)
PDN: U4.10 (PA4); also elsewhere on the board
STATUS0: U4.14 (PB0); also elsewhere on the board
VBus: C41.2, C42.2, D3.1 (K), J7.A4 (VBUS), J7.A9 (VBUS), J7.B4 (VBUS), J7.B9 (VBUS); also elsewhere on the board

Notes on the sheet:
EN_REF2
EN_OUT3
USB_VBUS
EN_OUT4

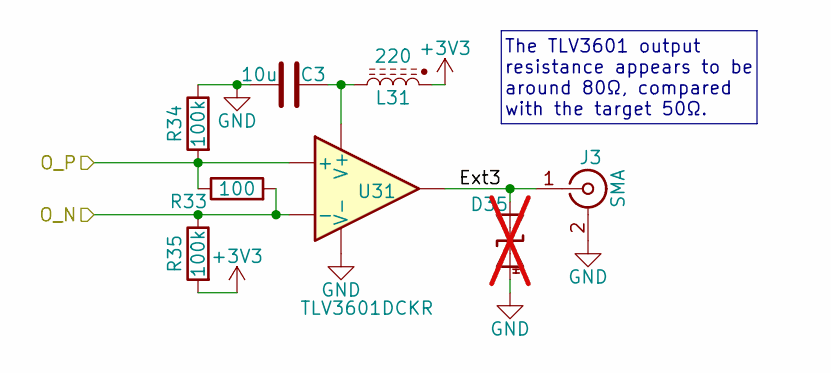
[picture p25: schematic output-tlv3601.kicad_sch]

Parts:
C3: 10u; C_0402_1005Metric; LCSC C15525
D35: D_TVS; HHS_0402; not fitted
J3: SMA; SMA_EdgeMount
L31: 220; L_0603_1608Metric; LCSC C14709
R33: 100; R_0402_1005Metric; LCSC C25076
R34, R35: 100k; R_0402_1005Metric; LCSC C25741
U31: TLV3601DCKR; SOT-353_SC-70-5; LCSC C2974371

Connections:
+3V3: L31.1, R35.2; also elsewhere on the board
/OUT3_N: R33.2, R35.1, U31.4 (-); also elsewhere on the board
/OUT3_P: R33.1, R34.2, U31.3 (+); also elsewhere on the board
/Output3/Ext3: D35.1 (A1), J3.1 (In), U31.1
GND: C3.2, D35.2 (A2), J3.2 (Ext), R34.1, U31.2 (V-); also elsewhere on the board
unnamed: C3.1, L31.2, U31.5 (V+)

Parts of its further copies:
C39: 10u; C_0402_1005Metric; LCSC C15525
D36: D_TVS; HHS_0402; not fitted
J4: SMA; SMA_EdgeMount
L32: 220; L_0603_1608Metric; LCSC C14709
R36: 100; R_0402_1005Metric; LCSC C25076
R37, R38: 100k; R_0402_1005Metric; LCSC C25741
U32: TLV3601DCKR; SOT-353_SC-70-5; LCSC C2974371

Connections of its further copies:
+3V3: L32.1, R38.2; also elsewhere on the board
/OUT4_N: R36.2, R38.1, U32.4 (-); also elsewhere on the board
/OUT4_P: R36.1, R37.2, U32.3 (+); also elsewhere on the board
/Output4/Ext3: D36.1 (A1), J4.1 (In), U32.1
GND: C39.2, D36.2 (A2), J4.2 (Ext), R37.1, U32.2 (V-); also elsewhere on the board
unnamed: C39.1, L32.2, U32.5 (V+)

Notes on the sheet:
The TLV3601 output resistance appears to be around 80Ω, compared with the target 50Ω.

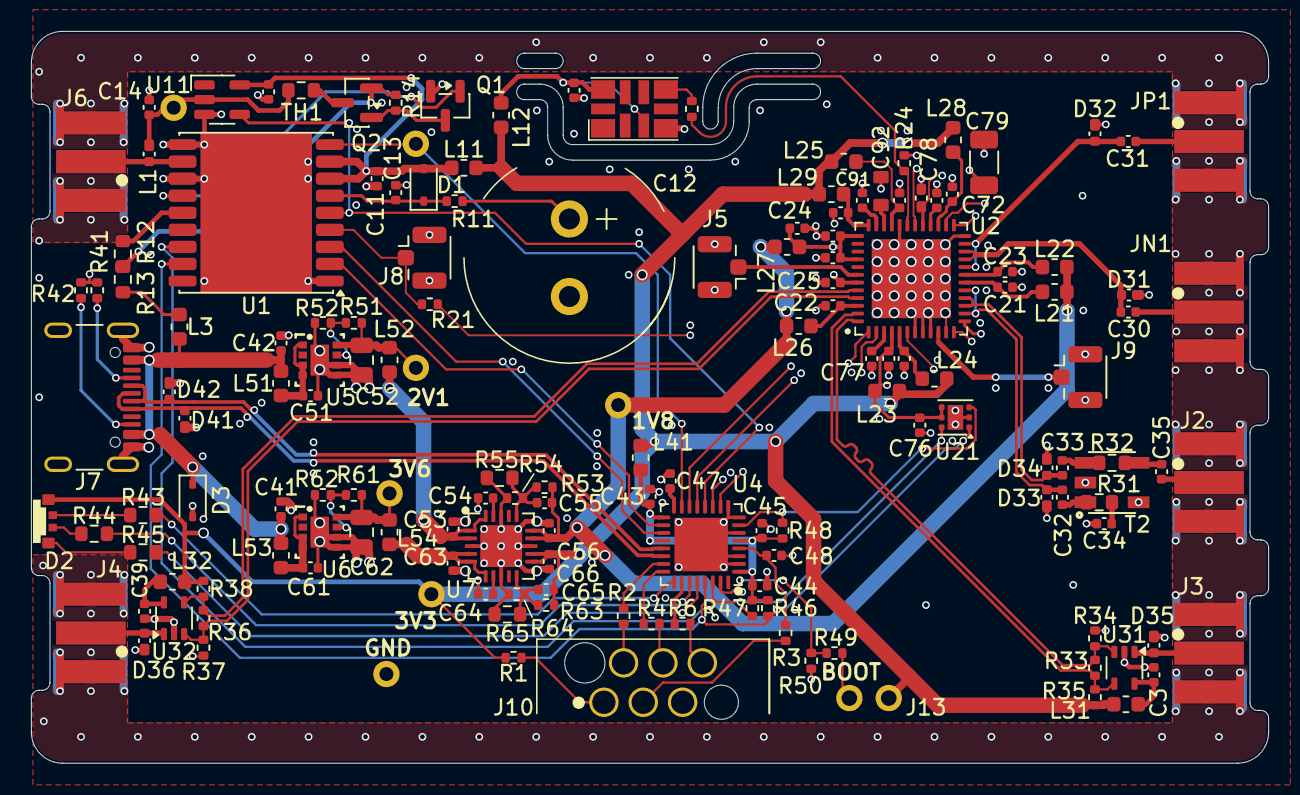
[picture p26: board gpsfreak.kicad_pcb from above]

Board: 4 copper layers, 79.8 x 47.2 mm, 157 parts (0 on the bottom side), 101 nets.
