rcls/gpsfreak/src/led.rs

use stm_common::vcell::UCell;

use core::num::Wrapping as W;

/// The timer we use for blinking.
///
/// We use a prescaler to get the counter running at 10kHz (100µs).  We use
/// signed wrapping arithmetic, so a 16-bit timer gives a maximum timeout of
/// just over 3 seconds.
use stm32h503::TIM3 as TIM;
use stm32h503::Interrupt::TIM3 as INTERRUPT;

type ITime = i16;
type WTime = core::num::Wrapping<ITime>;

use crate::cpu::interrupt::PRIO_LED as PRIORITY;
type Priority = crate::cpu::Priority<PRIORITY>;

type FiveHz = LedTimerUCell<1000, 1000>;

#[derive_const(Default)]
pub struct LedTimerUCell<const ON: ITime, const OFF: ITime>(
    UCell<LedTimer<ON, OFF>>);

pub static BLUE: FiveHz = Default::default();
pub static RED_GREEN: FiveHz = Default::default();

macro_rules!dbgln {($($tt:tt)*) => {if false {crate::dbgln!($($tt)*)}};}

pub fn init() {
    let gpioa = unsafe {&*stm32h503::GPIOA::PTR};
    let gpiob = unsafe {&*stm32h503::GPIOB::PTR};
    let rcc   = unsafe {&*stm32h503::RCC  ::PTR};
    let tim = unsafe {&*TIM::PTR};

    if *crate::cpu::IS_PROTOTYPE.as_ref() {
        // The prototype has Blue/green/red are PA1,2,3.
        gpioa.BSRR.write(|w| w.bits(0xe));
        gpioa.MODER.modify(
            |_,w| w.MODE1().B_0x1().MODE2().B_0x1().MODE3().B_0x1());
    }
    else {
        // Current design has Blue=PA15, Green=PB4, Red=PB5.
        gpioa.BSRR.write(|w| w.BS15().set_bit());
        gpioa.MODER.modify(|_,w| w.MODE15().B_0x1());
        gpiob.BSRR.write(|w| w.BS4().set_bit().BS5().set_bit());
        gpiob.MODER.modify(|_,w| w.MODE4().B_0x1().MODE5().B_0x1());
    }

    rcc.APB1LENR.modify(|_,w| w.TIM3EN().set_bit());
    // Set ARR to 0?
    tim.DIER.write(|w| w.CC1IE().set_bit());
    tim.CCMR1_Output().write(|w| w.OC1CE().set_bit().OC1M1().B_0x1());
    const PSC: u16 = (crate::cpu::CPU_FREQ / 10000) as u16 - 1;
    const {assert!((PSC as u32 + 1) * 10000 == crate::cpu::CPU_FREQ)};
    tim.PSC.write(|w| w.bits(PSC));
    tim.CR1.write(|w| w.CEN().set_bit());

    // Both the interrupt, and the callers into this code, should run at the
    // same priority.
    stm_common::interrupt::enable_priority(INTERRUPT, PRIORITY);
}

/// Set the physical LEDs.
/// red_green indicator: true = good = green, false = red.
/// blue true = LED, false = LED off.
/// Note that the LED is common anode, so that we drive the GPIO with negative
/// logic.
fn drive(red_green: bool, blue: bool) {
    let gpioa = unsafe{&*stm32h503::GPIOA::PTR};
    let gpiob = unsafe{&*stm32h503::GPIOB::PTR};

    if *crate::cpu::IS_PROTOTYPE.as_ref() {
        let green_off = !red_green;
        let red_off = red_green && !blue;
        let blue_off = !blue;
        gpioa.BSRR.write(
            |w|w.BR1().set_bit().BR2().set_bit().BR3().set_bit()
                .BS1().bit(blue_off).BS2().bit(green_off).BS3().bit(red_off));
    }
    else {
        gpiob.BSRR.write(
            |w|w.BR4().set_bit().BR5().set_bit()
                .BS4().bit(!red_green).BS5().bit(red_green));
        gpioa.BSRR.write(|w| w.BR15().set_bit().BS15().bit(!blue));
    }
}

impl<const ON: ITime, const OFF: ITime> LedTimerUCell<ON, OFF> {
    fn isr(&self, now: ITime) {
        unsafe {self.0.as_mut()}.isr(now);
    }

    pub fn set(&self, state: bool) {
        let tim = unsafe {&*TIM::PTR};

        let _guard = Priority::default();

        let now = tim.CNT.read().CNT().bits().cast_signed();
        schedule(unsafe {self.0.as_mut()}.set(state, now));

        drive(RED_GREEN.0.led, BLUE.0.led);
    }

    pub fn pulse(&self, state: bool) {
        let tim = unsafe {&*TIM::PTR};

        let _guard = Priority::default();

        let now = tim.CNT.read().CNT().bits().cast_signed();
        schedule(unsafe {self.0.as_mut()}.pulse(state, now));

        drive(RED_GREEN.0.led, BLUE.0.led);
    }
}

#[derive(Clone, Copy, Debug, PartialEq)]
#[derive_const(Default)]
pub struct LedTimer<const ON: ITime, const OFF: ITime> {
    /// Current desired state of the LED.  Various methods update this field,
    /// the wrapping methods in `Led` update the physical LED to match.
    led: bool,
    /// Next state to move to.
    next: bool,
    /// State we want to end up on.
    target: bool,
    /// Time at which the current setting expires.
    expiry: Option<WTime>,
}

fn schedule(deadline: Option<WTime>) {
    let tim = unsafe {&*TIM::PTR};
    let Some(deadline) = deadline else {return};
    // Only update the timer if we want to bring the expiry forwards.  We are
    // not called from the ISR, so equality doesn't need an update.
    if deadline - W(tim.CCR1.read().bits() as ITime) < W(0) {
        trigger(deadline);
    }
}

fn trigger(deadline: WTime) {
    let tim = unsafe {&*TIM::PTR};
    tim.CCR1.write(|w| w.bits(deadline.0 as u16 as u32));
    let now = tim.CNT.read().CNT().bits().cast_signed();
    if W(now) - deadline >= W(0) {
        // We've already expired.  Instead of potentially recursing, do a
        // software trigger.
        dbgln!("Immediate");
        let nvic = unsafe {&*cortex_m::peripheral::NVIC::PTR};
        unsafe {nvic.stir.write(INTERRUPT as u32)};
    }
}

impl<const ON: ITime, const OFF: ITime> LedTimer<ON, OFF> {
    fn isr(&mut self, now: ITime) {
        let Some(expiry) = self.expiry else {return};
        if W(now) - expiry < W(0) {
            return;
        }
        if self.next != self.led {
            self.update(self.next, self.target, now);
        }
        else {
            debug_assert!(self.next == self.target);
            // We should have led==next==target, but just in case something
            // funning is going on, defensively process it.
            self.led = self.target;
            self.next = self.target;
            self.expiry = None;
        }
    }

    fn duration(&self, state: bool) -> ITime {
        if state {ON} else {OFF}
    }

    fn set(&mut self, state: bool, now: ITime) -> Option<WTime> {
        self.target = state;
        if let Some(_) = self.expiry {
            if self.led == self.next || self.duration(self.next) == 0 {
                self.next = state;
            }
            return None;
        }
        if self.led == state {
            return None;               // Nothing to do.
        }

        // No timer is running; just apply everything now.
        self.update(state, state, now)
    }

    fn pulse(&mut self, state: bool, now: ITime) -> Option<WTime> {
        // Equivalent to: request(state) ; request(!state)
        self.target = !state;
        let next = state ^ (self.duration(state) == 0 || self.led == state);
        if self.expiry != None {
            self.next = next;
            return None;
        }
        self.update(next, !state, now)
    }

    /// Set self.led and return the timer expiry time.
    fn update(&mut self, state: bool, next: bool, now: ITime) -> Option<WTime> {
        self.led = state;
        self.next = next;
        let duration = self.duration(state);
        if duration > 0 {
            self.expiry = Some(W(now) + W(duration));
        }
        else {
            self.expiry = None;
        }
        self.expiry
    }
}

fn isr() {
    dbgln!("LED isr");
    let tim = unsafe {&*TIM::PTR};
    tim.SR.write(|w| w.bits(0));

    let now = tim.CNT.read().CNT().bits().cast_signed();

    let min = |a: WTime, b: Option<WTime>| -> WTime {
        match (a, b) {
            (a, Some(b)) => if a - b < W(0) {a} else {b},
            (a, None) => a,
        }
    };

    BLUE.isr(now);
    RED_GREEN.isr(now);
    drive(RED_GREEN.0.led, BLUE.0.led);

    // We make sure that the time is always scheduled in the future, even if
    // there is nothing to do.  Otherwise we need to deal with the ambiguity
    // between timers in the past being processed or late.
    let deadline = W(now) + W(30000);
    let deadline = min(deadline, BLUE.0.expiry);
    let deadline = min(deadline, RED_GREEN.0.expiry);
    dbgln!("LED {now} {deadline}");

    trigger(deadline);
}

impl crate::cpu::Config {
    pub const fn led(&mut self) -> &mut Self {
        self.isr(INTERRUPT, isr)
    }
}

#[test]
fn check_isr() {
    assert!(crate::VECTORS.isr[INTERRUPT as usize] == isr);
}

#[test]
fn test_fast() {
    let mut lt = LedTimer::<10, 10>::default();

    let mut exp = lt;

    assert_eq!(lt.set(false, 0), None);
    assert_eq!(lt, exp);
    lt.isr(1);
    assert_eq!(lt, exp);

    assert_ne!(lt.set(true, 10), None);
    exp.led = true;
    exp.next = true;
    exp.target = true;
    exp.expiry = Some(W(20));
    assert_eq!(lt, exp);

    assert_eq!(lt.set(true, 11), None);
    assert_eq!(lt, exp);

    assert_eq!(lt.set(false, 12), None);
    exp.next = false;
    exp.target = false;
    assert_eq!(lt, exp);

    assert_eq!(lt.set(true, 13), None);
    exp.target = true;
    assert_eq!(lt, exp);

    assert_eq!(lt.set(false, 14), None);
    exp.target = false;
    assert_eq!(lt, exp);

    assert_eq!(lt.set(true, 15), None);
    exp.target = true;
    assert_eq!(lt, exp);

    lt.isr(20);
    exp.led = exp.next;
    exp.next = exp.target;
    exp.expiry = Some(W(30));
    assert_eq!(lt, exp);

    assert_eq!(lt.set(false, 21), None);
    exp.target = false;
    assert_eq!(lt, exp);

    assert_eq!(lt.set(true, 22), None);
    exp.target = true;
    assert_eq!(lt, exp);

    lt.isr(29);
    assert_eq!(lt, exp);

    lt.isr(30);
    exp.led = exp.next;
    exp.next = exp.target;
    exp.expiry = Some(W(40));
    assert_eq!(lt, exp);

    lt.isr(39);
    assert_eq!(lt, exp);

    lt.isr(40);
    exp.led = exp.next;
    exp.next = exp.target;
    exp.expiry = None;
    assert_eq!(lt, exp);
    lt.isr(41);
    assert_eq!(lt, exp);
}

#[test]
fn test_zero() {
    let mut lt = LedTimer::<10, 0>::default();
    let mut exp = lt;
    lt.set(false, 0);
    assert_eq!(lt, exp);

    lt.set(true, 10);
    exp.led = true;
    exp.next = true;
    exp.target = true;
    exp.expiry = Some(W(20));
    assert_eq!(lt, exp);

    lt.set(true, 11);
    assert_eq!(lt, exp);

    lt.set(false, 12);
    exp.next = false;
    exp.target = false;
    assert_eq!(lt, exp);

    lt.set(true, 13);
    exp.next = true;
    exp.target = true;
    assert_eq!(lt, exp);

    lt.set(false, 14);
    exp.next = false;
    exp.target = false;
    assert_eq!(lt, exp);

    lt.isr(19);
    assert_eq!(lt, exp);

    lt.isr(20);
    exp.led = false;
    exp.expiry = None;
    assert_eq!(lt, exp);
    lt.isr(21);
    assert_eq!(lt, exp);
}

#[cfg(test)]
impl<const ON: ITime, const OFF: ITime> LedTimer<ON, OFF> {
    fn test_pulse1() {
        for led in [false, true] {
            for next in [false, true] {
                for target in [false, true] {
                    for expiry in [None, Some(W(10))] {
                        if expiry != None && ON == 0 && OFF == 0 {
                            continue;
                        }
                        let l = Self{led, next, target, expiry};
                        for request in [false, true] {
                            let (mut r, mut p) = (l, l);
                            r.set(request, 5);
                            r.set(!request, 5);
                            p.pulse(request, 5);
                            assert_eq!(r, p, "{l:?} {request}");
                        }
                    }
                }
            }
        }
    }
}

#[test]
fn test_pulse() {
    LedTimer::< 0,  0>::test_pulse1();
    LedTimer::< 0, 10>::test_pulse1();
    LedTimer::<10,  0>::test_pulse1();
    LedTimer::<10, 10>::test_pulse1();
}
