rcls/gpsfreak/py/freak/ublox_lists.py

from freak import ublox_cfg, ublox_msg
from .ublox_cfg import UBloxCfg
from .ublox_msg import UBloxMsg

ublox_cfg.add_cfg_list([
    UBloxCfg('ANA-USE_ANA', 0x10230001, 'L'),
    UBloxCfg('ANA-ORBMAXERR', 0x30230002, 'U2'),
    UBloxCfg('BATCH-ENABLE', 0x10260013, 'L'),
    UBloxCfg('BATCH-PIOENABLE', 0x10260014, 'L'),
    UBloxCfg('BATCH-MAXENTRIES', 0x30260015, 'U2'),
    UBloxCfg('BATCH-WARNTHRS', 0x30260016, 'U2'),
    UBloxCfg('BATCH-PIOACTIVELOW', 0x10260018, 'L'),
    UBloxCfg('BATCH-PIOID', 0x20260019, 'U1'),
    UBloxCfg('BATCH-EXTRAPVT', 0x1026001a, 'L'),
    UBloxCfg('BATCH-EXTRAODO', 0x1026001b, 'L'),
    UBloxCfg('BDS-D1D2_NAVDATA', 0x20340009, 'E1'),
    UBloxCfg('BDS-USE_GEO_PRN', 0x10340014, 'L'),
    UBloxCfg('GAL-USE_OSNMA', 0x10350005, 'L'),
    UBloxCfg('GAL-OSNMA_MINTAGLENGTH', 0x20350007, 'U1'),
    UBloxCfg('GAL-OSNMA_TIMESYNC', 0x10350009, 'L'),
    UBloxCfg('GAL-OSNMA_INAVPRIM', 0x10350010, 'L'),
    UBloxCfg('GEOFENCE-CONFLVL', 0x20240011, 'E1'),
    UBloxCfg('GEOFENCE-USE_PIO', 0x10240012, 'L'),
    UBloxCfg('GEOFENCE-PINPOL', 0x20240013, 'E1'),
    UBloxCfg('GEOFENCE-PIN', 0x20240014, 'U1'),
    UBloxCfg('GEOFENCE-USE_FENCE1', 0x10240020, 'L'),
    UBloxCfg('GEOFENCE-FENCE1_LAT', 0x40240021, 'I4'),
    UBloxCfg('GEOFENCE-FENCE1_LON', 0x40240022, 'I4'),
    UBloxCfg('GEOFENCE-FENCE1_RAD', 0x40240023, 'U4'),
    UBloxCfg('GEOFENCE-USE_FENCE2', 0x10240030, 'L'),
    UBloxCfg('GEOFENCE-FENCE2_LAT', 0x40240031, 'I4'),
    UBloxCfg('GEOFENCE-FENCE2_LON', 0x40240032, 'I4'),
    UBloxCfg('GEOFENCE-FENCE2_RAD', 0x40240033, 'U4'),
    UBloxCfg('GEOFENCE-USE_FENCE3', 0x10240040, 'L'),
    UBloxCfg('GEOFENCE-FENCE3_LAT', 0x40240041, 'I4'),
    UBloxCfg('GEOFENCE-FENCE3_LON', 0x40240042, 'I4'),
    UBloxCfg('GEOFENCE-FENCE3_RAD', 0x40240043, 'U4'),
    UBloxCfg('GEOFENCE-USE_FENCE4', 0x10240050, 'L'),
    UBloxCfg('GEOFENCE-FENCE4_LAT', 0x40240051, 'I4'),
    UBloxCfg('GEOFENCE-FENCE4_LON', 0x40240052, 'I4'),
    UBloxCfg('GEOFENCE-FENCE4_RAD', 0x40240053, 'U4'),
    UBloxCfg('HW-ANT_CFG_VOLTCTRL', 0x10a3002e, 'L'),
    UBloxCfg('HW-ANT_CFG_SHORTDET', 0x10a3002f, 'L'),
    UBloxCfg('HW-ANT_CFG_SHORTDET_POL', 0x10a30030, 'L'),
    UBloxCfg('HW-ANT_CFG_OPENDET', 0x10a30031, 'L'),
    UBloxCfg('HW-ANT_CFG_OPENDET_POL', 0x10a30032, 'L'),
    UBloxCfg('HW-ANT_CFG_PWRDOWN', 0x10a30033, 'L'),
    UBloxCfg('HW-ANT_CFG_PWRDOWN_POL', 0x10a30034, 'L'),
    UBloxCfg('HW-ANT_CFG_RECOVER', 0x10a30035, 'L'),
    UBloxCfg('HW-ANT_SUP_SWITCH_PIN', 0x20a30036, 'U1'),
    UBloxCfg('HW-ANT_SUP_SHORT_PIN', 0x20a30037, 'U1'),
    UBloxCfg('HW-ANT_SUP_OPEN_PIN', 0x20a30038, 'U1'),
    UBloxCfg('HW-ANT_ON_SHORT_US', 0x30a3003c, 'U2'),
    # This is not listed in documentation!
    UBloxCfg('HW-ANT_MODULE_TYPE', 0x50a30049, 'X8'),
    UBloxCfg('HW-ANT_SUP_ENGINE', 0x20a30054, 'E1'),
    UBloxCfg('HW-ANT_SUP_SHORT_THR', 0x20a30055, 'U1'),
    UBloxCfg('HW-ANT_SUP_OPEN_THR', 0x20a30056, 'U1'),
    UBloxCfg('HW-RF_LNA_MODE', 0x20a30057, 'E1'),
    UBloxCfg('I2C-ADDRESS', 0x20510001, 'U1'),
    UBloxCfg('I2C-EXTENDEDTIMEOUT', 0x10510002, 'L'),
    UBloxCfg('I2C-ENABLED', 0x10510003, 'L'),
    UBloxCfg('I2CINPROT-UBX', 0x10710001, 'L'),
    UBloxCfg('I2CINPROT-NMEA', 0x10710002, 'L'),
    UBloxCfg('I2CINPROT-RTCM3X', 0x10710004, 'L'),
    UBloxCfg('I2COUTPROT-UBX', 0x10720001, 'L'),
    UBloxCfg('I2COUTPROT-NMEA', 0x10720002, 'L'),
    UBloxCfg('I2COUTPROT-RTCM3X', 0x10720004, 'L'),
    UBloxCfg('INFMSG-UBX_I2C', 0x20920001, 'X1'),
    UBloxCfg('INFMSG-UBX_UART1', 0x20920002, 'X1'),
    UBloxCfg('INFMSG-UBX_UART2', 0x20920003, 'X1'),
    UBloxCfg('INFMSG-UBX_USB', 0x20920004, 'X1'),
    UBloxCfg('INFMSG-UBX_SPI', 0x20920005, 'X1'),
    UBloxCfg('INFMSG-NMEA_I2C', 0x20920006, 'X1'),
    UBloxCfg('INFMSG-NMEA_UART1', 0x20920007, 'X1'),
    UBloxCfg('INFMSG-NMEA_UART2', 0x20920008, 'X1'),
    UBloxCfg('INFMSG-NMEA_USB', 0x20920009, 'X1'),
    UBloxCfg('INFMSG-NMEA_SPI', 0x2092000a, 'X1'),
    UBloxCfg('ITFM-BBTHRESHOLD', 0x20410001, 'U1'),
    UBloxCfg('ITFM-CWTHRESHOLD', 0x20410002, 'U1'),
    UBloxCfg('ITFM-ENABLE', 0x1041000d, 'L'),
    UBloxCfg('ITFM-ANTSETTING', 0x20410010, 'E1'),
    UBloxCfg('ITFM-ENABLE_AUX', 0x10410013, 'L'),
    UBloxCfg('LOGFILTER-RECORD_ENA', 0x10de0002, 'L'),
    UBloxCfg('LOGFILTER-ONCE_PER_WAKE_', 0x10de0003, 'L'),
    UBloxCfg('LOGFILTER-APPLY_ALL_FILTERS', 0x10de0004, 'L'),
    UBloxCfg('LOGFILTER-MIN_INTERVAL', 0x30de0005, 'U2'),
    UBloxCfg('LOGFILTER-TIME_THRS', 0x30de0006, 'U2'),
    UBloxCfg('LOGFILTER-SPEED_THRS', 0x30de0007, 'U2'),
    UBloxCfg('LOGFILTER-POSITION_THRS', 0x40de0008, 'U4'),
    UBloxCfg('MOT-GNSSSPEED_THRS', 0x20250038, 'U1'),
    UBloxCfg('MOT-GNSSDIST_THRS', 0x3025003b, 'U2'),
    UBloxCfg('MSGOUT-NMEA_ID_DTM_I2C', 0x209100a6, 'U1'),
    UBloxCfg('MSGOUT-NMEA_ID_DTM_SPI', 0x209100aa, 'U1'),
    UBloxCfg('MSGOUT-NMEA_ID_DTM_UART1', 0x209100a7, 'U1'),
    UBloxCfg('MSGOUT-NMEA_ID_DTM_UART2', 0x209100a8, 'U1'),
    UBloxCfg('MSGOUT-NMEA_ID_DTM_USB', 0x209100a9, 'U1'),
    UBloxCfg('MSGOUT-NMEA_ID_GBS_I2C', 0x209100dd, 'U1'),
    UBloxCfg('MSGOUT-NMEA_ID_GBS_SPI', 0x209100e1, 'U1'),
    UBloxCfg('MSGOUT-NMEA_ID_GBS_UART1', 0x209100de, 'U1'),
    UBloxCfg('MSGOUT-NMEA_ID_GBS_UART2', 0x209100df, 'U1'),
    UBloxCfg('MSGOUT-NMEA_ID_GBS_USB', 0x209100e0, 'U1'),
    UBloxCfg('MSGOUT-NMEA_ID_GGA_I2C', 0x209100ba, 'U1'),
    UBloxCfg('MSGOUT-NMEA_ID_GGA_SPI', 0x209100be, 'U1'),
    UBloxCfg('MSGOUT-NMEA_ID_GGA_UART1', 0x209100bb, 'U1'),
    UBloxCfg('MSGOUT-NMEA_ID_GGA_UART2', 0x209100bc, 'U1'),
    UBloxCfg('MSGOUT-NMEA_ID_GGA_USB', 0x209100bd, 'U1'),
    UBloxCfg('MSGOUT-NMEA_ID_GLL_I2C', 0x209100c9, 'U1'),
    UBloxCfg('MSGOUT-NMEA_ID_GLL_SPI', 0x209100cd, 'U1'),
    UBloxCfg('MSGOUT-NMEA_ID_GLL_UART1', 0x209100ca, 'U1'),
    UBloxCfg('MSGOUT-NMEA_ID_GLL_UART2', 0x209100cb, 'U1'),
    UBloxCfg('MSGOUT-NMEA_ID_GLL_USB', 0x209100cc, 'U1'),
    UBloxCfg('MSGOUT-NMEA_ID_GNS_I2C', 0x209100b5, 'U1'),
    UBloxCfg('MSGOUT-NMEA_ID_GNS_SPI', 0x209100b9, 'U1'),
    UBloxCfg('MSGOUT-NMEA_ID_GNS_UART1', 0x209100b6, 'U1'),
    UBloxCfg('MSGOUT-NMEA_ID_GNS_UART2', 0x209100b7, 'U1'),
    UBloxCfg('MSGOUT-NMEA_ID_GNS_USB', 0x209100b8, 'U1'),
    UBloxCfg('MSGOUT-NMEA_ID_GRS_I2C', 0x209100ce, 'U1'),
    UBloxCfg('MSGOUT-NMEA_ID_GRS_SPI', 0x209100d2, 'U1'),
    UBloxCfg('MSGOUT-NMEA_ID_GRS_UART1', 0x209100cf, 'U1'),
    UBloxCfg('MSGOUT-NMEA_ID_GRS_UART2', 0x209100d0, 'U1'),
    UBloxCfg('MSGOUT-NMEA_ID_GRS_USB', 0x209100d1, 'U1'),
    UBloxCfg('MSGOUT-NMEA_ID_GSA_I2C', 0x209100bf, 'U1'),
    UBloxCfg('MSGOUT-NMEA_ID_GSA_SPI', 0x209100c3, 'U1'),
    UBloxCfg('MSGOUT-NMEA_ID_GSA_UART1', 0x209100c0, 'U1'),
    UBloxCfg('MSGOUT-NMEA_ID_GSA_UART2', 0x209100c1, 'U1'),
    UBloxCfg('MSGOUT-NMEA_ID_GSA_USB', 0x209100c2, 'U1'),
    UBloxCfg('MSGOUT-NMEA_ID_GST_I2C', 0x209100d3, 'U1'),
    UBloxCfg('MSGOUT-NMEA_ID_GST_SPI', 0x209100d7, 'U1'),
    UBloxCfg('MSGOUT-NMEA_ID_GST_UART1', 0x209100d4, 'U1'),
    UBloxCfg('MSGOUT-NMEA_ID_GST_UART2', 0x209100d5, 'U1'),
    UBloxCfg('MSGOUT-NMEA_ID_GST_USB', 0x209100d6, 'U1'),
    UBloxCfg('MSGOUT-NMEA_ID_GSV_I2C', 0x209100c4, 'U1'),
    UBloxCfg('MSGOUT-NMEA_ID_GSV_SPI', 0x209100c8, 'U1'),
    UBloxCfg('MSGOUT-NMEA_ID_GSV_UART1', 0x209100c5, 'U1'),
    UBloxCfg('MSGOUT-NMEA_ID_GSV_UART2', 0x209100c6, 'U1'),
    UBloxCfg('MSGOUT-NMEA_ID_GSV_USB', 0x209100c7, 'U1'),
    UBloxCfg('MSGOUT-NMEA_ID_RLM_I2C', 0x20910400, 'U1'),
    UBloxCfg('MSGOUT-NMEA_ID_RLM_SPI', 0x20910404, 'U1'),
    UBloxCfg('MSGOUT-NMEA_ID_RLM_UART1', 0x20910401, 'U1'),
    UBloxCfg('MSGOUT-NMEA_ID_RLM_UART2', 0x20910402, 'U1'),
    UBloxCfg('MSGOUT-NMEA_ID_RLM_USB', 0x20910403, 'U1'),
    UBloxCfg('MSGOUT-NMEA_ID_RMC_I2C', 0x209100ab, 'U1'),
    UBloxCfg('MSGOUT-NMEA_ID_RMC_SPI', 0x209100af, 'U1'),
    UBloxCfg('MSGOUT-NMEA_ID_RMC_UART1', 0x209100ac, 'U1'),
    UBloxCfg('MSGOUT-NMEA_ID_RMC_UART2', 0x209100ad, 'U1'),
    UBloxCfg('MSGOUT-NMEA_ID_RMC_USB', 0x209100ae, 'U1'),
    UBloxCfg('MSGOUT-NMEA_ID_VLW_I2C', 0x209100e7, 'U1'),
    UBloxCfg('MSGOUT-NMEA_ID_VLW_SPI', 0x209100eb, 'U1'),
    UBloxCfg('MSGOUT-NMEA_ID_VLW_UART1', 0x209100e8, 'U1'),
    UBloxCfg('MSGOUT-NMEA_ID_UTC_I2C', 0x209106cf, 'U1'),
    UBloxCfg('MSGOUT-NMEA_ID_UTC_SPI', 0x209106d3, 'U1'),
    UBloxCfg('MSGOUT-NMEA_ID_UTC_UART1', 0x209106d0, 'U1'),
    UBloxCfg('MSGOUT-NMEA_ID_UTC_UART2', 0x209106d1, 'U1'),
    UBloxCfg('MSGOUT-NMEA_ID_UTC_USB', 0x209106d2, 'U1'),
    UBloxCfg('MSGOUT-NMEA_ID_VTG_I2C', 0x209100b0, 'U1'),
    UBloxCfg('MSGOUT-NMEA_ID_VTG_SPI', 0x209100b4, 'U1'),
    UBloxCfg('MSGOUT-NMEA_ID_VTG_UART1', 0x209100b1, 'U1'),
    UBloxCfg('MSGOUT-NMEA_ID_VTG_UART2', 0x209100b2, 'U1'),
    UBloxCfg('MSGOUT-NMEA_ID_VTG_USB', 0x209100b3, 'U1'),
    UBloxCfg('MSGOUT-NMEA_ID_ZDA_I2C', 0x209100d8, 'U1'),
    UBloxCfg('MSGOUT-NMEA_ID_ZDA_SPI', 0x209100dc, 'U1'),
    UBloxCfg('MSGOUT-NMEA_ID_ZDA_UART1', 0x209100d9, 'U1'),
    UBloxCfg('MSGOUT-NMEA_ID_ZDA_UART2', 0x209100da, 'U1'),
    UBloxCfg('MSGOUT-NMEA_ID_ZDA_USB', 0x209100db, 'U1'),
    UBloxCfg('MSGOUT-NMEA_NAV2_ID_GGA_I2C', 0x20910661, 'U1'),
    UBloxCfg('MSGOUT-NMEA_NAV2_ID_GGA_SPI', 0x20910665, 'U1'),
    UBloxCfg('MSGOUT-NMEA_NAV2_ID_GGA_UART1', 0x20910662, 'U1'),
    UBloxCfg('MSGOUT-NMEA_NAV2_ID_GGA_UART2', 0x20910663, 'U1'),
    UBloxCfg('MSGOUT-NMEA_NAV2_ID_GGA_USB', 0x20910664, 'U1'),
    UBloxCfg('MSGOUT-NMEA_NAV2_ID_GLL_I2C', 0x20910670, 'U1'),
    UBloxCfg('MSGOUT-NMEA_NAV2_ID_GLL_SPI', 0x20910674, 'U1'),
    UBloxCfg('MSGOUT-NMEA_NAV2_ID_GLL_UART1', 0x20910671, 'U1'),
    UBloxCfg('MSGOUT-NMEA_NAV2_ID_GLL_UART2', 0x20910672, 'U1'),
    UBloxCfg('MSGOUT-NMEA_NAV2_ID_GLL_USB', 0x20910673, 'U1'),
    UBloxCfg('MSGOUT-NMEA_NAV2_ID_GNS_I2C', 0x2091065c, 'U1'),
    UBloxCfg('MSGOUT-NMEA_NAV2_ID_GNS_SPI', 0x20910660, 'U1'),
    UBloxCfg('MSGOUT-NMEA_NAV2_ID_GNS_UART1', 0x2091065d, 'U1'),
    UBloxCfg('MSGOUT-NMEA_NAV2_ID_GNS_UART2', 0x2091065e, 'U1'),
    UBloxCfg('MSGOUT-NMEA_NAV2_ID_GNS_USB', 0x2091065f, 'U1'),
    UBloxCfg('MSGOUT-NMEA_NAV2_ID_GSA_I2C', 0x20910666, 'U1'),
    UBloxCfg('MSGOUT-NMEA_NAV2_ID_GSA_SPI', 0x2091066a, 'U1'),
    UBloxCfg('MSGOUT-NMEA_NAV2_ID_GSA_UART1', 0x20910667, 'U1'),
    UBloxCfg('MSGOUT-NMEA_NAV2_ID_GSA_UART2', 0x20910668, 'U1'),
    UBloxCfg('MSGOUT-NMEA_NAV2_ID_GSA_USB', 0x20910669, 'U1'),
    UBloxCfg('MSGOUT-NMEA_NAV2_ID_RMC_I2C', 0x20910652, 'U1'),
    UBloxCfg('MSGOUT-NMEA_NAV2_ID_RMC_SPI', 0x20910656, 'U1'),
    UBloxCfg('MSGOUT-NMEA_NAV2_ID_RMC_UART1', 0x20910653, 'U1'),
    UBloxCfg('MSGOUT-NMEA_NAV2_ID_RMC_UART2', 0x20910654, 'U1'),
    UBloxCfg('MSGOUT-NMEA_NAV2_ID_RMC_USB', 0x20910655, 'U1'),
    UBloxCfg('MSGOUT-NMEA_NAV2_ID_VTG_I2C', 0x20910657, 'U1'),
    UBloxCfg('MSGOUT-NMEA_NAV2_ID_VTG_SPI', 0x2091065b, 'U1'),
    UBloxCfg('MSGOUT-NMEA_NAV2_ID_VTG_UART1', 0x20910658, 'U1'),
    UBloxCfg('MSGOUT-NMEA_NAV2_ID_VTG_UART2', 0x20910659, 'U1'),
    UBloxCfg('MSGOUT-NMEA_NAV2_ID_VTG_USB', 0x2091065a, 'U1'),
    UBloxCfg('MSGOUT-NMEA_NAV2_ID_ZDA_I2C', 0x2091067f, 'U1'),
    UBloxCfg('MSGOUT-NMEA_NAV2_ID_ZDA_SPI', 0x20910683, 'U1'),
    UBloxCfg('MSGOUT-NMEA_NAV2_ID_ZDA_UART1', 0x20910680, 'U1'),
    UBloxCfg('MSGOUT-NMEA_NAV2_ID_ZDA_UART2', 0x20910681, 'U1'),
    UBloxCfg('MSGOUT-NMEA_NAV2_ID_ZDA_USB', 0x20910682, 'U1'),
    UBloxCfg('MSGOUT-PUBX_ID_POLYP_I2C', 0x209100ec, 'U1'),
    UBloxCfg('MSGOUT-PUBX_ID_POLYP_SPI', 0x209100f0, 'U1'),
    UBloxCfg('MSGOUT-PUBX_ID_POLYP_UART1', 0x209100ed, 'U1'),
    UBloxCfg('MSGOUT-PUBX_ID_POLYP_UART2', 0x209100ee, 'U1'),
    UBloxCfg('MSGOUT-PUBX_ID_POLYP_USB', 0x209100ef, 'U1'),
    UBloxCfg('MSGOUT-PUBX_ID_POLYS_I2C', 0x209100f1, 'U1'),
    UBloxCfg('MSGOUT-PUBX_ID_POLYS_SPI', 0x209100f5, 'U1'),
    UBloxCfg('MSGOUT-PUBX_ID_POLYS_UART1', 0x209100f2, 'U1'),
    UBloxCfg('MSGOUT-PUBX_ID_POLYS_UART2', 0x209100f3, 'U1'),
    UBloxCfg('MSGOUT-PUBX_ID_POLYS_USB', 0x209100f4, 'U1'),
    UBloxCfg('MSGOUT-PUBX_ID_POLYT_I2C', 0x209100f6, 'U1'),
    UBloxCfg('MSGOUT-PUBX_ID_POLYT_SPI', 0x209100fa, 'U1'),
    UBloxCfg('MSGOUT-PUBX_ID_POLYT_UART1', 0x209100f7, 'U1'),
    UBloxCfg('MSGOUT-PUBX_ID_POLYT_UART2', 0x209100f8, 'U1'),
    UBloxCfg('MSGOUT-PUBX_ID_POLYT_USB', 0x209100f9, 'U1'),
    UBloxCfg('MSGOUT-RTCM_3X_TYPE1005_I2C', 0x209102bd, 'U1'),
    UBloxCfg('MSGOUT-RTCM_3X_TYPE1005_SPI', 0x209102c1, 'U1'),
    UBloxCfg('MSGOUT-RTCM_3X_TYPE1005_UART1', 0x209102be, 'U1'),
    UBloxCfg('MSGOUT-RTCM_3X_TYPE1005_UART2', 0x209102bf, 'U1'),
    UBloxCfg('MSGOUT-RTCM_3X_TYPE1005_USB', 0x209102c0, 'U1'),
    UBloxCfg('MSGOUT-RTCM_3X_TYPE1074_I2C', 0x2091035e, 'U1'),
    UBloxCfg('MSGOUT-RTCM_3X_TYPE1074_SPI', 0x20910362, 'U1'),
    UBloxCfg('MSGOUT-RTCM_3X_TYPE1074_UART1', 0x2091035f, 'U1'),
    UBloxCfg('MSGOUT-RTCM_3X_TYPE1074_UART2', 0x20910360, 'U1'),
    UBloxCfg('MSGOUT-RTCM_3X_TYPE1074_USB', 0x20910361, 'U1'),
    UBloxCfg('MSGOUT-RTCM_3X_TYPE1077_I2C', 0x209102cc, 'U1'),
    UBloxCfg('MSGOUT-RTCM_3X_TYPE1077_SPI', 0x209102d0, 'U1'),
    UBloxCfg('MSGOUT-RTCM_3X_TYPE1077_UART1', 0x209102cd, 'U1'),
    UBloxCfg('MSGOUT-RTCM_3X_TYPE1077_UART2', 0x209102ce, 'U1'),
    UBloxCfg('MSGOUT-RTCM_3X_TYPE1077_USB', 0x209102cf, 'U1'),
    UBloxCfg('MSGOUT-RTCM_3X_TYPE1094_I2C', 0x20910368, 'U1'),
    UBloxCfg('MSGOUT-RTCM_3X_TYPE1094_SPI', 0x2091036c, 'U1'),
    UBloxCfg('MSGOUT-RTCM_3X_TYPE1094_UART1', 0x20910369, 'U1'),
    UBloxCfg('MSGOUT-RTCM_3X_TYPE1094_UART2', 0x2091036a, 'U1'),
    UBloxCfg('MSGOUT-RTCM_3X_TYPE1094_USB', 0x2091036b, 'U1'),
    UBloxCfg('MSGOUT-RTCM_3X_TYPE1097_I2C', 0x20910318, 'U1'),
    UBloxCfg('MSGOUT-RTCM_3X_TYPE1097_SPI', 0x2091031c, 'U1'),
    UBloxCfg('MSGOUT-RTCM_3X_TYPE1097_UART1', 0x20910319, 'U1'),
    UBloxCfg('MSGOUT-RTCM_3X_TYPE1097_UART2', 0x2091031a, 'U1'),
    UBloxCfg('MSGOUT-RTCM_3X_TYPE1097_USB', 0x2091031b, 'U1'),
    UBloxCfg('MSGOUT-RTCM_3X_TYPE1124_I2C', 0x2091036d, 'U1'),
    UBloxCfg('MSGOUT-RTCM_3X_TYPE1124_SPI', 0x20910371, 'U1'),
    UBloxCfg('MSGOUT-RTCM_3X_TYPE1124_UART1', 0x2091036e, 'U1'),
    UBloxCfg('MSGOUT-RTCM_3X_TYPE1124_UART2', 0x2091036f, 'U1'),
    UBloxCfg('MSGOUT-RTCM_3X_TYPE1124_USB', 0x20910370, 'U1'),
    UBloxCfg('MSGOUT-RTCM_3X_TYPE1127_I2C', 0x209102d6, 'U1'),
    UBloxCfg('MSGOUT-RTCM_3X_TYPE1127_SPI', 0x209102da, 'U1'),
    UBloxCfg('MSGOUT-RTCM_3X_TYPE1127_UART1', 0x209102d7, 'U1'),
    UBloxCfg('MSGOUT-RTCM_3X_TYPE1127_UART2', 0x209102d8, 'U1'),
    UBloxCfg('MSGOUT-RTCM_3X_TYPE1127_USB', 0x209102d9, 'U1'),
    UBloxCfg('MSGOUT-RTCM_3X_TYPE4072_0_I2C', 0x209102fe, 'U1'),
    UBloxCfg('MSGOUT-RTCM_3X_TYPE4072_0_SPI', 0x20910302, 'U1'),
    UBloxCfg('MSGOUT-RTCM_3X_TYPE4072_0_UART1', 0x209102ff, 'U1'),
    UBloxCfg('MSGOUT-RTCM_3X_TYPE4072_0_UART2', 0x20910300, 'U1'),
    UBloxCfg('MSGOUT-RTCM_3X_TYPE4072_0_USB', 0x20910301, 'U1'),
    UBloxCfg('MSGOUT-RTCM_3X_TYPE4072_1_I2C', 0x20910381, 'U1'),
    UBloxCfg('MSGOUT-RTCM_3X_TYPE4072_1_SPI', 0x20910385, 'U1'),
    UBloxCfg('MSGOUT-RTCM_3X_TYPE4072_1_UART1', 0x20910382, 'U1'),
    UBloxCfg('MSGOUT-RTCM_3X_TYPE4072_1_UART2', 0x20910383, 'U1'),
    UBloxCfg('MSGOUT-RTCM_3X_TYPE4072_1_USB', 0x20910384, 'U1'),
    UBloxCfg('MSGOUT-UBX_LOG_INFO_I2C', 0x20910259, 'U1'),
    UBloxCfg('MSGOUT-UBX_LOG_INFO_SPI', 0x2091025d, 'U1'),
    UBloxCfg('MSGOUT-UBX_LOG_INFO_UART1', 0x2091025a, 'U1'),
    UBloxCfg('MSGOUT-UBX_MON_COMMS_I2C', 0x2091034f, 'U1'),
    UBloxCfg('MSGOUT-UBX_MON_COMMS_SPI', 0x20910353, 'U1'),
    UBloxCfg('MSGOUT-UBX_MON_COMMS_UART1', 0x20910350, 'U1'),
    UBloxCfg('MSGOUT-UBX_MON_COMMS_UART2', 0x20910351, 'U1'),
    UBloxCfg('MSGOUT-UBX_MON_COMMS_USB', 0x20910352, 'U1'),
    UBloxCfg('MSGOUT-UBX_MON_HW2_I2C', 0x209101b9, 'U1'),
    UBloxCfg('MSGOUT-UBX_MON_HW2_SPI', 0x209101bd, 'U1'),
    UBloxCfg('MSGOUT-UBX_MON_HW2_UART1', 0x209101ba, 'U1'),
    UBloxCfg('MSGOUT-UBX_MON_HW2_UART2', 0x209101bb, 'U1'),
    UBloxCfg('MSGOUT-UBX_MON_HW2_USB', 0x209101bc, 'U1'),
    UBloxCfg('MSGOUT-UBX_MON_HW3_I2C', 0x20910354, 'U1'),
    UBloxCfg('MSGOUT-UBX_MON_HW3_SPI', 0x20910358, 'U1'),
    UBloxCfg('MSGOUT-UBX_MON_HW3_UART1', 0x20910355, 'U1'),
    UBloxCfg('MSGOUT-UBX_MON_HW3_UART2', 0x20910356, 'U1'),
    UBloxCfg('MSGOUT-UBX_MON_HW3_USB', 0x20910357, 'U1'),
    UBloxCfg('MSGOUT-UBX_MON_HW_I2C', 0x209101b4, 'U1'),
    UBloxCfg('MSGOUT-UBX_MON_HW_SPI', 0x209101b8, 'U1'),
    UBloxCfg('MSGOUT-UBX_MON_HW_UART1', 0x209101b5, 'U1'),
    UBloxCfg('MSGOUT-UBX_MON_HW_UART2', 0x209101b6, 'U1'),
    UBloxCfg('MSGOUT-UBX_MON_HW_USB', 0x209101b7, 'U1'),
    UBloxCfg('MSGOUT-UBX_MON_IO_I2C', 0x209101a5, 'U1'),
    UBloxCfg('MSGOUT-UBX_MON_IO_SPI', 0x209101a9, 'U1'),
    UBloxCfg('MSGOUT-UBX_MON_IO_UART1', 0x209101a6, 'U1'),
    UBloxCfg('MSGOUT-UBX_MON_IO_UART2', 0x209101a7, 'U1'),
    UBloxCfg('MSGOUT-UBX_MON_IO_USB', 0x209101a8, 'U1'),
    UBloxCfg('MSGOUT-UBX_MON_MSGPP_I2C', 0x20910196, 'U1'),
    UBloxCfg('MSGOUT-UBX_MON_MSGPP_SPI', 0x2091019a, 'U1'),
    UBloxCfg('MSGOUT-UBX_MON_MSGPP_UART1', 0x20910197, 'U1'),
    UBloxCfg('MSGOUT-UBX_MON_MSGPP_UART2', 0x20910198, 'U1'),
    UBloxCfg('MSGOUT-UBX_MON_MSGPP_USB', 0x20910199, 'U1'),
    UBloxCfg('MSGOUT-UBX_MON_RF_I2C', 0x20910359, 'U1'),
    UBloxCfg('MSGOUT-UBX_MON_RF_SPI', 0x2091035d, 'U1'),
    UBloxCfg('MSGOUT-UBX_MON_RF_UART1', 0x2091035a, 'U1'),
    UBloxCfg('MSGOUT-UBX_MON_RF_UART2', 0x2091035b, 'U1'),
    UBloxCfg('MSGOUT-UBX_MON_RF_USB', 0x2091035c, 'U1'),
    UBloxCfg('MSGOUT-UBX_MON_RXBUF_I2C', 0x209101a0, 'U1'),
    UBloxCfg('MSGOUT-UBX_MON_RXBUF_SPI', 0x209101a4, 'U1'),
    UBloxCfg('MSGOUT-UBX_MON_RXBUF_UART1', 0x209101a1, 'U1'),
    UBloxCfg('MSGOUT-UBX_MON_RXBUF_UART2', 0x209101a2, 'U1'),
    UBloxCfg('MSGOUT-UBX_MON_RXBUF_USB', 0x209101a3, 'U1'),
    UBloxCfg('MSGOUT-UBX_MON_RXR_I2C', 0x20910187, 'U1'),
    UBloxCfg('MSGOUT-UBX_MON_RXR_SPI', 0x2091018b, 'U1'),
    UBloxCfg('MSGOUT-UBX_MON_RXR_UART1', 0x20910188, 'U1'),
    UBloxCfg('MSGOUT-UBX_MON_RXR_UART2', 0x20910189, 'U1'),
    UBloxCfg('MSGOUT-UBX_MON_RXR_USB', 0x2091018a, 'U1'),
    UBloxCfg('MSGOUT-UBX_MON_SPAN_I2C', 0x2091038b, 'U1'),
    UBloxCfg('MSGOUT-UBX_MON_SPAN_SPI', 0x2091038f, 'U1'),
    UBloxCfg('MSGOUT-UBX_MON_SPAN_UART1', 0x2091038c, 'U1'),
    UBloxCfg('MSGOUT-UBX_MON_SPAN_UART2', 0x2091038d, 'U1'),
    UBloxCfg('MSGOUT-UBX_MON_SPAN_USB', 0x2091038e, 'U1'),
    UBloxCfg('MSGOUT-UBX_MON_SYS_I2C', 0x2091069d, 'U1'),
    UBloxCfg('MSGOUT-UBX_MON_SYS_SPI', 0x209106a1, 'U1'),
    UBloxCfg('MSGOUT-UBX_MON_SYS_UART1', 0x2091069e, 'U1'),
    UBloxCfg('MSGOUT-UBX_MON_SYS_UART2', 0x2091069f, 'U1'),
    UBloxCfg('MSGOUT-UBX_MON_SYS_USB', 0x209106a0, 'U1'),
    UBloxCfg('MSGOUT-UBX_MON_TXBUF_I2C', 0x2091019b, 'U1'),
    UBloxCfg('MSGOUT-UBX_MON_TXBUF_SPI', 0x2091019f, 'U1'),
    UBloxCfg('MSGOUT-UBX_MON_TXBUF_UART1', 0x2091019c, 'U1'),
    UBloxCfg('MSGOUT-UBX_MON_TXBUF_UART2', 0x2091019d, 'U1'),
    UBloxCfg('MSGOUT-UBX_MON_TXBUF_USB', 0x2091019e, 'U1'),
    UBloxCfg('MSGOUT-UBX_NAV2_CLOCK_I2C', 0x20910430, 'U1'),
    UBloxCfg('MSGOUT-UBX_NAV2_CLOCK_SPI', 0x20910434, 'U1'),
    UBloxCfg('MSGOUT-UBX_NAV2_CLOCK_UART1', 0x20910431, 'U1'),
    UBloxCfg('MSGOUT-UBX_NAV2_CLOCK_UART2', 0x20910432, 'U1'),
    UBloxCfg('MSGOUT-UBX_NAV2_CLOCK_USB', 0x20910433, 'U1'),
    UBloxCfg('MSGOUT-UBX_NAV2_COV_I2C', 0x20910435, 'U1'),
    UBloxCfg('MSGOUT-UBX_NAV2_COV_SPI', 0x20910439, 'U1'),
    UBloxCfg('MSGOUT-UBX_NAV2_COV_UART1', 0x20910436, 'U1'),
    UBloxCfg('MSGOUT-UBX_NAV2_COV_UART2', 0x20910437, 'U1'),
    UBloxCfg('MSGOUT-UBX_NAV2_COV_USB', 0x20910438, 'U1'),
    UBloxCfg('MSGOUT-UBX_NAV2_DOP_I2C', 0x20910465, 'U1'),
    UBloxCfg('MSGOUT-UBX_NAV2_DOP_SPI', 0x20910469, 'U1'),
    UBloxCfg('MSGOUT-UBX_NAV2_DOP_UART1', 0x20910466, 'U1'),
    UBloxCfg('MSGOUT-UBX_NAV2_DOP_UART2', 0x20910467, 'U1'),
    UBloxCfg('MSGOUT-UBX_NAV2_DOP_USB', 0x20910468, 'U1'),
    UBloxCfg('MSGOUT-UBX_NAV2_EOE_I2C', 0x20910565, 'U1'),
    UBloxCfg('MSGOUT-UBX_NAV2_EOE_SPI', 0x20910569, 'U1'),
    UBloxCfg('MSGOUT-UBX_NAV2_EOE_UART1', 0x20910566, 'U1'),
    UBloxCfg('MSGOUT-UBX_NAV2_EOE_UART2', 0x20910567, 'U1'),
    UBloxCfg('MSGOUT-UBX_NAV2_EOE_USB', 0x20910568, 'U1'),
    UBloxCfg('MSGOUT-UBX_NAV2_POSECEF_I2C', 0x20910480, 'U1'),
    UBloxCfg('MSGOUT-UBX_NAV2_POSECEF_SPI', 0x20910484, 'U1'),
    UBloxCfg('MSGOUT-UBX_NAV2_POSECEF_UART1', 0x20910481, 'U1'),
    UBloxCfg('MSGOUT-UBX_NAV2_POSECEF_UART2', 0x20910482, 'U1'),
    UBloxCfg('MSGOUT-UBX_NAV2_POSECEF_USB', 0x20910483, 'U1'),
    UBloxCfg('MSGOUT-UBX_NAV2_POSLLH_I2C', 0x20910485, 'U1'),
    UBloxCfg('MSGOUT-UBX_NAV2_POSLLH_SPI', 0x20910489, 'U1'),
    UBloxCfg('MSGOUT-UBX_NAV2_POSLLH_UART1', 0x20910486, 'U1'),
    UBloxCfg('MSGOUT-UBX_NAV2_POSLLH_UART2', 0x20910487, 'U1'),
    UBloxCfg('MSGOUT-UBX_NAV2_POSLLH_USB', 0x20910488, 'U1'),
    UBloxCfg('MSGOUT-UBX_NAV2_PVT_I2C', 0x20910490, 'U1'),
    UBloxCfg('MSGOUT-UBX_NAV2_PVT_SPI', 0x20910494, 'U1'),
    UBloxCfg('MSGOUT-UBX_NAV2_PVT_UART1', 0x20910491, 'U1'),
    UBloxCfg('MSGOUT-UBX_NAV2_PVT_UART2', 0x20910492, 'U1'),
    UBloxCfg('MSGOUT-UBX_NAV2_PVT_USB', 0x20910493, 'U1'),
    UBloxCfg('MSGOUT-UBX_NAV2_SAT_I2C', 0x20910495, 'U1'),
    UBloxCfg('MSGOUT-UBX_NAV2_SAT_SPI', 0x20910499, 'U1'),
    UBloxCfg('MSGOUT-UBX_NAV2_SAT_UART1', 0x20910496, 'U1'),
    UBloxCfg('MSGOUT-UBX_NAV2_SAT_UART2', 0x20910497, 'U1'),
    UBloxCfg('MSGOUT-UBX_NAV2_SAT_USB', 0x20910498, 'U1'),
    UBloxCfg('MSGOUT-UBX_NAV2_SBAS_I2C', 0x20910500, 'U1'),
    UBloxCfg('MSGOUT-UBX_NAV2_SBAS_SPI', 0x20910504, 'U1'),
    UBloxCfg('MSGOUT-UBX_NAV2_SBAS_UART1', 0x20910501, 'U1'),
    UBloxCfg('MSGOUT-UBX_NAV2_SBAS_UART2', 0x20910502, 'U1'),
    UBloxCfg('MSGOUT-UBX_NAV2_SBAS_USB', 0x20910503, 'U1'),
    UBloxCfg('MSGOUT-UBX_NAV2_SIG_I2C', 0x20910505, 'U1'),
    UBloxCfg('MSGOUT-UBX_NAV2_SIG_SPI', 0x20910509, 'U1'),
    UBloxCfg('MSGOUT-UBX_NAV2_SIG_UART1', 0x20910506, 'U1'),
    UBloxCfg('MSGOUT-UBX_NAV2_SIG_UART2', 0x20910507, 'U1'),
    UBloxCfg('MSGOUT-UBX_NAV2_SIG_USB', 0x20910508, 'U1'),
    UBloxCfg('MSGOUT-UBX_NAV2_STATUS_I2C', 0x20910515, 'U1'),
    UBloxCfg('MSGOUT-UBX_NAV2_STATUS_SPI', 0x20910519, 'U1'),
    UBloxCfg('MSGOUT-UBX_NAV2_STATUS_UART1', 0x20910516, 'U1'),
    UBloxCfg('MSGOUT-UBX_NAV2_STATUS_UART2', 0x20910517, 'U1'),
    UBloxCfg('MSGOUT-UBX_NAV2_STATUS_USB', 0x20910518, 'U1'),
    UBloxCfg('MSGOUT-UBX_NAV2_TIMEBDS_I2C', 0x20910525, 'U1'),
    UBloxCfg('MSGOUT-UBX_NAV2_TIMEBDS_SPI', 0x20910529, 'U1'),
    UBloxCfg('MSGOUT-UBX_NAV2_TIMEBDS_UART1', 0x20910526, 'U1'),
    UBloxCfg('MSGOUT-UBX_NAV2_TIMEBDS_UART2', 0x20910527, 'U1'),
    UBloxCfg('MSGOUT-UBX_NAV2_TIMEBDS_USB', 0x20910528, 'U1'),
    UBloxCfg('MSGOUT-UBX_NAV2_TIMEGAL_I2C', 0x20910530, 'U1'),
    UBloxCfg('MSGOUT-UBX_NAV2_TIMEGAL_SPI', 0x20910534, 'U1'),
    UBloxCfg('MSGOUT-UBX_NAV2_TIMEGAL_UART1', 0x20910531, 'U1'),
    UBloxCfg('MSGOUT-UBX_NAV2_TIMEGAL_UART2', 0x20910532, 'U1'),
    UBloxCfg('MSGOUT-UBX_NAV2_TIMEGAL_USB', 0x20910533, 'U1'),
    UBloxCfg('MSGOUT-UBX_NAV2_TIMEGPS_I2C', 0x20910540, 'U1'),
    UBloxCfg('MSGOUT-UBX_NAV2_TIMEGPS_SPI', 0x20910544, 'U1'),
    UBloxCfg('MSGOUT-UBX_NAV2_TIMEGPS_UART1', 0x20910541, 'U1'),
    UBloxCfg('MSGOUT-UBX_NAV2_TIMEGPS_UART2', 0x20910542, 'U1'),
    UBloxCfg('MSGOUT-UBX_NAV2_TIMEGPS_USB', 0x20910543, 'U1'),
    UBloxCfg('MSGOUT-UBX_NAV2_TIMELS_I2C', 0x20910545, 'U1'),
    UBloxCfg('MSGOUT-UBX_NAV2_TIMELS_SPI', 0x20910549, 'U1'),
    UBloxCfg('MSGOUT-UBX_NAV2_TIMELS_UART1', 0x20910546, 'U1'),
    UBloxCfg('MSGOUT-UBX_NAV2_TIMELS_UART2', 0x20910547, 'U1'),
    UBloxCfg('MSGOUT-UBX_NAV2_TIMELS_USB', 0x20910548, 'U1'),
    UBloxCfg('MSGOUT-UBX_NAV2_TIMENAVIC_I2C', 0x209106a7, 'U1'),
    UBloxCfg('MSGOUT-UBX_NAV2_TIMENAVIC_SPI', 0x209106ab, 'U1'),
    UBloxCfg('MSGOUT-UBX_NAV2_TIMENAVIC_UART1', 0x209106a8, 'U1'),
    UBloxCfg('MSGOUT-UBX_NAV2_TIMENAVIC_UART2', 0x209106a9, 'U1'),
    UBloxCfg('MSGOUT-UBX_NAV2_TIMENAVIC_USB', 0x209106aa, 'U1'),
    UBloxCfg('MSGOUT-UBX_NAV2_TIMEQZSS_I2C', 0x20910575, 'U1'),
    UBloxCfg('MSGOUT-UBX_NAV2_TIMEQZSS_SPI', 0x20910579, 'U1'),
    UBloxCfg('MSGOUT-UBX_NAV2_TIMEQZSS_UART1', 0x20910576, 'U1'),
    UBloxCfg('MSGOUT-UBX_NAV2_TIMEQZSS_UART2', 0x20910577, 'U1'),
    UBloxCfg('MSGOUT-UBX_NAV2_TIMEQZSS_USB', 0x20910578, 'U1'),
    UBloxCfg('MSGOUT-UBX_NAV2_TIMEUTC_I2C', 0x20910550, 'U1'),
    UBloxCfg('MSGOUT-UBX_NAV2_TIMEUTC_SPI', 0x20910554, 'U1'),
    UBloxCfg('MSGOUT-UBX_NAV2_TIMEUTC_UART1', 0x20910551, 'U1'),
    UBloxCfg('MSGOUT-UBX_NAV2_TIMEUTC_UART2', 0x20910552, 'U1'),
    UBloxCfg('MSGOUT-UBX_NAV2_TIMEUTC_USB', 0x20910553, 'U1'),
    UBloxCfg('MSGOUT-UBX_NAV2_VELECEF_I2C', 0x20910555, 'U1'),
    UBloxCfg('MSGOUT-UBX_NAV2_VELECEF_SPI', 0x20910559, 'U1'),
    UBloxCfg('MSGOUT-UBX_NAV2_VELECEF_UART1', 0x20910556, 'U1'),
    UBloxCfg('MSGOUT-UBX_NAV2_VELECEF_UART2', 0x20910557, 'U1'),
    UBloxCfg('MSGOUT-UBX_NAV2_VELECEF_USB', 0x20910558, 'U1'),
    UBloxCfg('MSGOUT-UBX_NAV2_VELNED_I2C', 0x20910560, 'U1'),
    UBloxCfg('MSGOUT-UBX_NAV2_VELNED_SPI', 0x20910564, 'U1'),
    UBloxCfg('MSGOUT-UBX_NAV2_VELNED_UART1', 0x20910561, 'U1'),
    UBloxCfg('MSGOUT-UBX_NAV2_VELNED_UART2', 0x20910562, 'U1'),
    UBloxCfg('MSGOUT-UBX_NAV2_VELNED_USB', 0x20910563, 'U1'),
    UBloxCfg('MSGOUT-UBX_NAV_AOPSTATUS_I2C', 0x20910079, 'U1'),
    UBloxCfg('MSGOUT-UBX_NAV_AOPSTATUS_SPI', 0x2091007d, 'U1'),
    UBloxCfg('MSGOUT-UBX_NAV_AOPSTATUS_UART1', 0x2091007a, 'U1'),
    UBloxCfg('MSGOUT-UBX_NAV_CLOCK_I2C', 0x20910065, 'U1'),
    UBloxCfg('MSGOUT-UBX_NAV_CLOCK_SPI', 0x20910069, 'U1'),
    UBloxCfg('MSGOUT-UBX_NAV_CLOCK_UART1', 0x20910066, 'U1'),
    UBloxCfg('MSGOUT-UBX_NAV_CLOCK_UART2', 0x20910067, 'U1'),
    UBloxCfg('MSGOUT-UBX_NAV_CLOCK_USB', 0x20910068, 'U1'),
    UBloxCfg('MSGOUT-UBX_NAV_COV_I2C', 0x20910083, 'U1'),
    UBloxCfg('MSGOUT-UBX_NAV_COV_SPI', 0x20910087, 'U1'),
    UBloxCfg('MSGOUT-UBX_NAV_COV_UART1', 0x20910084, 'U1'),
    UBloxCfg('MSGOUT-UBX_NAV_COV_UART2', 0x20910085, 'U1'),
    UBloxCfg('MSGOUT-UBX_NAV_COV_USB', 0x20910086, 'U1'),
    UBloxCfg('MSGOUT-UBX_NAV_DOP_I2C', 0x20910038, 'U1'),
    UBloxCfg('MSGOUT-UBX_NAV_DOP_SPI', 0x2091003c, 'U1'),
    UBloxCfg('MSGOUT-UBX_NAV_DOP_UART1', 0x20910039, 'U1'),
    UBloxCfg('MSGOUT-UBX_NAV_DOP_UART2', 0x2091003a, 'U1'),
    UBloxCfg('MSGOUT-UBX_NAV_DOP_USB', 0x2091003b, 'U1'),
    UBloxCfg('MSGOUT-UBX_NAV_EOE_I2C', 0x2091015f, 'U1'),
    UBloxCfg('MSGOUT-UBX_NAV_EOE_SPI', 0x20910163, 'U1'),
    UBloxCfg('MSGOUT-UBX_NAV_EOE_UART1', 0x20910160, 'U1'),
    UBloxCfg('MSGOUT-UBX_NAV_EOE_UART2', 0x20910161, 'U1'),
    UBloxCfg('MSGOUT-UBX_NAV_EOE_USB', 0x20910162, 'U1'),
    UBloxCfg('MSGOUT-UBX_NAV_GEOFENCE_I2C', 0x209100a1, 'U1'),
    UBloxCfg('MSGOUT-UBX_NAV_GEOFENCE_SPI', 0x209100a5, 'U1'),
    UBloxCfg('MSGOUT-UBX_NAV_GEOFENCE_UART1', 0x209100a2, 'U1'),
    UBloxCfg('MSGOUT-UBX_NAV_NMI_I2C', 0x20910590, 'U1'),
    UBloxCfg('MSGOUT-UBX_NAV_NMI_SPI', 0x20910594, 'U1'),
    UBloxCfg('MSGOUT-UBX_NAV_NMI_UART1', 0x20910591, 'U1'),
    UBloxCfg('MSGOUT-UBX_NAV_NMI_UART2', 0x20910592, 'U1'),
    UBloxCfg('MSGOUT-UBX_NAV_NMI_USB', 0x20910593, 'U1'),
    UBloxCfg('MSGOUT-UBX_NAV_ODO_I2C', 0x2091007e, 'U1'),
    UBloxCfg('MSGOUT-UBX_NAV_ODO_SPI', 0x20910082, 'U1'),
    UBloxCfg('MSGOUT-UBX_NAV_ODO_UART1', 0x2091007f, 'U1'),
    UBloxCfg('MSGOUT-UBX_NAV_ORB_I2C', 0x20910010, 'U1'),
    UBloxCfg('MSGOUT-UBX_NAV_ORB_SPI', 0x20910014, 'U1'),
    UBloxCfg('MSGOUT-UBX_NAV_ORB_UART1', 0x20910011, 'U1'),
    UBloxCfg('MSGOUT-UBX_NAV_ORB_UART2', 0x20910012, 'U1'),
    UBloxCfg('MSGOUT-UBX_NAV_ORB_USB', 0x20910013, 'U1'),
    UBloxCfg('MSGOUT-UBX_NAV_PL_I2C', 0x20910415, 'U1'),
    UBloxCfg('MSGOUT-UBX_NAV_PL_SPI', 0x20910419, 'U1'),
    UBloxCfg('MSGOUT-UBX_NAV_PL_UART1', 0x20910416, 'U1'),
    UBloxCfg('MSGOUT-UBX_NAV_POSECEF_I2C', 0x20910024, 'U1'),
    UBloxCfg('MSGOUT-UBX_NAV_POSECEF_SPI', 0x20910028, 'U1'),
    UBloxCfg('MSGOUT-UBX_NAV_POSECEF_UART1', 0x20910025, 'U1'),
    UBloxCfg('MSGOUT-UBX_NAV_POSECEF_UART2', 0x20910026, 'U1'),
    UBloxCfg('MSGOUT-UBX_NAV_POSECEF_USB', 0x20910027, 'U1'),
    UBloxCfg('MSGOUT-UBX_NAV_POSLLH_I2C', 0x20910029, 'U1'),
    UBloxCfg('MSGOUT-UBX_NAV_POSLLH_SPI', 0x2091002d, 'U1'),
    UBloxCfg('MSGOUT-UBX_NAV_POSLLH_UART1', 0x2091002a, 'U1'),
    UBloxCfg('MSGOUT-UBX_NAV_POSLLH_UART2', 0x2091002b, 'U1'),
    UBloxCfg('MSGOUT-UBX_NAV_POSLLH_USB', 0x2091002c, 'U1'),
    UBloxCfg('MSGOUT-UBX_NAV_PVT_I2C', 0x20910006, 'U1'),
    UBloxCfg('MSGOUT-UBX_NAV_PVT_SPI', 0x2091000a, 'U1'),
    UBloxCfg('MSGOUT-UBX_NAV_PVT_UART1', 0x20910007, 'U1'),
    UBloxCfg('MSGOUT-UBX_NAV_PVT_UART2', 0x20910008, 'U1'),
    UBloxCfg('MSGOUT-UBX_NAV_PVT_USB', 0x20910009, 'U1'),
    UBloxCfg('MSGOUT-UBX_NAV_SAT_I2C', 0x20910015, 'U1'),
    UBloxCfg('MSGOUT-UBX_NAV_SAT_SPI', 0x20910019, 'U1'),
    UBloxCfg('MSGOUT-UBX_NAV_SAT_UART1', 0x20910016, 'U1'),
    UBloxCfg('MSGOUT-UBX_NAV_SAT_UART2', 0x20910017, 'U1'),
    UBloxCfg('MSGOUT-UBX_NAV_SAT_USB', 0x20910018, 'U1'),
    UBloxCfg('MSGOUT-UBX_NAV_SBAS_I2C', 0x2091006a, 'U1'),
    UBloxCfg('MSGOUT-UBX_NAV_SBAS_SPI', 0x2091006e, 'U1'),
    UBloxCfg('MSGOUT-UBX_NAV_SBAS_UART1', 0x2091006b, 'U1'),
    UBloxCfg('MSGOUT-UBX_NAV_SBAS_UART2', 0x2091006c, 'U1'),
    UBloxCfg('MSGOUT-UBX_NAV_SBAS_USB', 0x2091006d, 'U1'),
    UBloxCfg('MSGOUT-UBX_NAV_SIG_I2C', 0x20910345, 'U1'),
    UBloxCfg('MSGOUT-UBX_NAV_SIG_SPI', 0x20910349, 'U1'),
    UBloxCfg('MSGOUT-UBX_NAV_SIG_UART1', 0x20910346, 'U1'),
    UBloxCfg('MSGOUT-UBX_NAV_SIG_UART2', 0x20910347, 'U1'),
    UBloxCfg('MSGOUT-UBX_NAV_SIG_USB', 0x20910348, 'U1'),
    UBloxCfg('MSGOUT-UBX_NAV_SLAS_I2C', 0x20910336, 'U1'),
    UBloxCfg('MSGOUT-UBX_NAV_SLAS_SPI', 0x2091033a, 'U1'),
    UBloxCfg('MSGOUT-UBX_NAV_SLAS_UART1', 0x20910337, 'U1'),
    UBloxCfg('MSGOUT-UBX_NAV_STATUS_I2C', 0x2091001a, 'U1'),
    UBloxCfg('MSGOUT-UBX_NAV_STATUS_SPI', 0x2091001e, 'U1'),
    UBloxCfg('MSGOUT-UBX_NAV_STATUS_UART1', 0x2091001b, 'U1'),
    UBloxCfg('MSGOUT-UBX_NAV_STATUS_UART2', 0x2091001c, 'U1'),
    UBloxCfg('MSGOUT-UBX_NAV_STATUS_USB', 0x2091001d, 'U1'),
    UBloxCfg('MSGOUT-UBX_NAV_TIMEBDS_I2C', 0x20910051, 'U1'),
    UBloxCfg('MSGOUT-UBX_NAV_TIMEBDS_SPI', 0x20910055, 'U1'),
    UBloxCfg('MSGOUT-UBX_NAV_TIMEBDS_UART1', 0x20910052, 'U1'),
    UBloxCfg('MSGOUT-UBX_NAV_TIMEBDS_UART2', 0x20910053, 'U1'),
    UBloxCfg('MSGOUT-UBX_NAV_TIMEBDS_USB', 0x20910054, 'U1'),
    UBloxCfg('MSGOUT-UBX_NAV_TIMEGAL_I2C', 0x20910056, 'U1'),
    UBloxCfg('MSGOUT-UBX_NAV_TIMEGAL_SPI', 0x2091005a, 'U1'),
    UBloxCfg('MSGOUT-UBX_NAV_TIMEGAL_UART1', 0x20910057, 'U1'),
    UBloxCfg('MSGOUT-UBX_NAV_TIMEGAL_UART2', 0x20910058, 'U1'),
    UBloxCfg('MSGOUT-UBX_NAV_TIMEGAL_USB', 0x20910059, 'U1'),
    UBloxCfg('MSGOUT-UBX_NAV_TIMEGLO_I2C', 0x2091004c, 'U1'),
    UBloxCfg('MSGOUT-UBX_NAV_TIMEGLO_SPI', 0x20910050, 'U1'),
    UBloxCfg('MSGOUT-UBX_NAV_TIMEGLO_UART1', 0x2091004d, 'U1'),
    UBloxCfg('MSGOUT-UBX_NAV_TIMEGPS_I2C', 0x20910047, 'U1'),
    UBloxCfg('MSGOUT-UBX_NAV_TIMEGPS_SPI', 0x2091004b, 'U1'),
    UBloxCfg('MSGOUT-UBX_NAV_TIMEGPS_UART1', 0x20910048, 'U1'),
    UBloxCfg('MSGOUT-UBX_NAV_TIMEGPS_UART2', 0x20910049, 'U1'),
    UBloxCfg('MSGOUT-UBX_NAV_TIMEGPS_USB', 0x2091004a, 'U1'),
    UBloxCfg('MSGOUT-UBX_NAV_TIMELS_I2C', 0x20910060, 'U1'),
    UBloxCfg('MSGOUT-UBX_NAV_TIMELS_SPI', 0x20910064, 'U1'),
    UBloxCfg('MSGOUT-UBX_NAV_TIMELS_UART1', 0x20910061, 'U1'),
    UBloxCfg('MSGOUT-UBX_NAV_TIMELS_UART2', 0x20910062, 'U1'),
    UBloxCfg('MSGOUT-UBX_NAV_TIMELS_USB', 0x20910063, 'U1'),
    UBloxCfg('MSGOUT-UBX_NAV_TIMENAVIC_I2C', 0x209106a2, 'U1'),
    UBloxCfg('MSGOUT-UBX_NAV_TIMENAVIC_SPI', 0x209106a6, 'U1'),
    UBloxCfg('MSGOUT-UBX_NAV_TIMENAVIC_UART1', 0x209106a3, 'U1'),
    UBloxCfg('MSGOUT-UBX_NAV_TIMENAVIC_UART2', 0x209106a4, 'U1'),
    UBloxCfg('MSGOUT-UBX_NAV_TIMENAVIC_USB', 0x209106a5, 'U1'),
    UBloxCfg('MSGOUT-UBX_NAV_TIMEQZSS_I2C', 0x20910386, 'U1'),
    UBloxCfg('MSGOUT-UBX_NAV_TIMEQZSS_SPI', 0x2091038a, 'U1'),
    UBloxCfg('MSGOUT-UBX_NAV_TIMEQZSS_UART1', 0x20910387, 'U1'),
    UBloxCfg('MSGOUT-UBX_NAV_TIMEQZSS_UART2', 0x20910388, 'U1'),
    UBloxCfg('MSGOUT-UBX_NAV_TIMEQZSS_USB', 0x20910389, 'U1'),
    UBloxCfg('MSGOUT-UBX_NAV_TIMETRUSTED_I2C', 0x209103a8, 'U1'),
    UBloxCfg('MSGOUT-UBX_NAV_TIMETRUSTED_SPI', 0x209103ac, 'U1'),
    UBloxCfg('MSGOUT-UBX_NAV_TIMETRUSTED_UART1', 0x209103a9, 'U1'),
    UBloxCfg('MSGOUT-UBX_NAV_TIMETRUSTED_UART2', 0x209103aa, 'U1'),
    UBloxCfg('MSGOUT-UBX_NAV_TIMETRUSTED_USB', 0x209103ab, 'U1'),
    UBloxCfg('MSGOUT-UBX_NAV_TIMEUTC_I2C', 0x2091005b, 'U1'),
    UBloxCfg('MSGOUT-UBX_NAV_TIMEUTC_SPI', 0x2091005f, 'U1'),
    UBloxCfg('MSGOUT-UBX_NAV_TIMEUTC_UART1', 0x2091005c, 'U1'),
    UBloxCfg('MSGOUT-UBX_NAV_TIMEUTC_UART2', 0x2091005d, 'U1'),
    UBloxCfg('MSGOUT-UBX_NAV_TIMEUTC_USB', 0x2091005e, 'U1'),
    UBloxCfg('MSGOUT-UBX_NAV_VELECEF_I2C', 0x2091003d, 'U1'),
    UBloxCfg('MSGOUT-UBX_NAV_VELECEF_SPI', 0x20910041, 'U1'),
    UBloxCfg('MSGOUT-UBX_NAV_VELECEF_UART1', 0x2091003e, 'U1'),
    UBloxCfg('MSGOUT-UBX_NAV_VELECEF_UART2', 0x2091003f, 'U1'),
    UBloxCfg('MSGOUT-UBX_NAV_VELECEF_USB', 0x20910040, 'U1'),
    UBloxCfg('MSGOUT-UBX_NAV_VELNED_I2C', 0x20910042, 'U1'),
    UBloxCfg('MSGOUT-UBX_NAV_VELNED_SPI', 0x20910046, 'U1'),
    UBloxCfg('MSGOUT-UBX_NAV_VELNED_UART1', 0x20910043, 'U1'),
    UBloxCfg('MSGOUT-UBX_NAV_VELNED_UART2', 0x20910044, 'U1'),
    UBloxCfg('MSGOUT-UBX_NAV_VELNED_USB', 0x20910045, 'U1'),
    UBloxCfg('MSGOUT-UBX_RXM_COR_I2C', 0x209106b6, 'U1'),
    UBloxCfg('MSGOUT-UBX_RXM_COR_SPI', 0x209106ba, 'U1'),
    UBloxCfg('MSGOUT-UBX_RXM_COR_UART1', 0x209106b7, 'U1'),
    UBloxCfg('MSGOUT-UBX_RXM_COR_UART2', 0x209106b8, 'U1'),
    UBloxCfg('MSGOUT-UBX_RXM_COR_USB', 0x209106b9, 'U1'),
    UBloxCfg('MSGOUT-UBX_RXM_MEAS20_I2C', 0x20910643, 'U1'),
    UBloxCfg('MSGOUT-UBX_RXM_MEAS20_SPI', 0x20910647, 'U1'),
    UBloxCfg('MSGOUT-UBX_RXM_MEAS20_UART1', 0x20910644, 'U1'),
    UBloxCfg('MSGOUT-UBX_RXM_MEAS50_I2C', 0x20910648, 'U1'),
    UBloxCfg('MSGOUT-UBX_RXM_MEAS50_SPI', 0x2091064c, 'U1'),
    UBloxCfg('MSGOUT-UBX_RXM_MEAS50_UART1', 0x20910649, 'U1'),
    UBloxCfg('MSGOUT-UBX_RXM_MEASC12_I2C', 0x2091063e, 'U1'),
    UBloxCfg('MSGOUT-UBX_RXM_MEASC12_SPI', 0x20910642, 'U1'),
    UBloxCfg('MSGOUT-UBX_RXM_MEASC12_UART1', 0x2091063f, 'U1'),
    UBloxCfg('MSGOUT-UBX_RXM_MEASD12_I2C', 0x20910639, 'U1'),
    UBloxCfg('MSGOUT-UBX_RXM_MEASD12_SPI', 0x2091063d, 'U1'),
    UBloxCfg('MSGOUT-UBX_RXM_MEASD12_UART1', 0x2091063a, 'U1'),
    UBloxCfg('MSGOUT-UBX_RXM_MEASX_I2C', 0x20910204, 'U1'),
    UBloxCfg('MSGOUT-UBX_RXM_MEASX_SPI', 0x20910208, 'U1'),
    UBloxCfg('MSGOUT-UBX_RXM_MEASX_UART1', 0x20910205, 'U1'),
    UBloxCfg('MSGOUT-UBX_RXM_MEASX_UART2', 0x20910206, 'U1'),
    UBloxCfg('MSGOUT-UBX_RXM_MEASX_USB', 0x20910207, 'U1'),
    UBloxCfg('MSGOUT-UBX_RXM_RAWX_I2C', 0x209102a4, 'U1'),
    UBloxCfg('MSGOUT-UBX_RXM_RAWX_SPI', 0x209102a8, 'U1'),
    UBloxCfg('MSGOUT-UBX_RXM_RAWX_UART1', 0x209102a5, 'U1'),
    UBloxCfg('MSGOUT-UBX_RXM_RAWX_UART2', 0x209102a6, 'U1'),
    UBloxCfg('MSGOUT-UBX_RXM_RAWX_USB', 0x209102a7, 'U1'),
    UBloxCfg('MSGOUT-UBX_RXM_RLM_I2C', 0x2091025e, 'U1'),
    UBloxCfg('MSGOUT-UBX_RXM_RLM_SPI', 0x20910262, 'U1'),
    UBloxCfg('MSGOUT-UBX_RXM_RLM_UART1', 0x2091025f, 'U1'),
    UBloxCfg('MSGOUT-UBX_RXM_RLM_UART2', 0x20910260, 'U1'),
    UBloxCfg('MSGOUT-UBX_RXM_RLM_USB', 0x20910261, 'U1'),
    UBloxCfg('MSGOUT-UBX_RXM_RTCM_I2C', 0x20910268, 'U1'),
    UBloxCfg('MSGOUT-UBX_RXM_RTCM_SPI', 0x2091026c, 'U1'),
    UBloxCfg('MSGOUT-UBX_RXM_RTCM_UART1', 0x20910269, 'U1'),
    UBloxCfg('MSGOUT-UBX_RXM_RTCM_UART2', 0x2091026a, 'U1'),
    UBloxCfg('MSGOUT-UBX_RXM_RTCM_USB', 0x2091026b, 'U1'),
    UBloxCfg('MSGOUT-UBX_RXM_SFRBX_I2C', 0x20910231, 'U1'),
    UBloxCfg('MSGOUT-UBX_RXM_SFRBX_SPI', 0x20910235, 'U1'),
    UBloxCfg('MSGOUT-UBX_RXM_SFRBX_UART1', 0x20910232, 'U1'),
    UBloxCfg('MSGOUT-UBX_RXM_SFRBX_UART2', 0x20910233, 'U1'),
    UBloxCfg('MSGOUT-UBX_RXM_SFRBX_USB', 0x20910234, 'U1'),
    UBloxCfg('MSGOUT-UBX_RXM_TM_I2C', 0x20910610, 'U1'),
    UBloxCfg('MSGOUT-UBX_RXM_TM_SPI', 0x20910614, 'U1'),
    UBloxCfg('MSGOUT-UBX_RXM_TM_UART1', 0x20910611, 'U1'),
    UBloxCfg('MSGOUT-UBX_RXM_TM_UART2', 0x20910612, 'U1'),
    UBloxCfg('MSGOUT-UBX_RXM_TM_USB', 0x20910613, 'U1'),
    UBloxCfg('MSGOUT-UBX_SEC_OSNMA_I2C', 0x209106ca, 'U1'),
    UBloxCfg('MSGOUT-UBX_SEC_OSNMA_SPI', 0x209106ce, 'U1'),
    UBloxCfg('MSGOUT-UBX_SEC_OSNMA_UART1', 0x209106cb, 'U1'),
    UBloxCfg('MSGOUT-UBX_SEC_OSNMA_UART2', 0x209106cc, 'U1'),
    UBloxCfg('MSGOUT-UBX_SEC_OSNMA_USB', 0x209106cd, 'U1'),
    UBloxCfg('MSGOUT-UBX_SEC_SIGLOG_I2C', 0x20910689, 'U1'),
    UBloxCfg('MSGOUT-UBX_SEC_SIGLOG_SPI', 0x2091068d, 'U1'),
    UBloxCfg('MSGOUT-UBX_SEC_SIGLOG_UART1', 0x2091068a, 'U1'),
    UBloxCfg('MSGOUT-UBX_SEC_SIGLOG_UART2', 0x2091068b, 'U1'),
    UBloxCfg('MSGOUT-UBX_SEC_SIGLOG_USB', 0x2091068c, 'U1'),
    UBloxCfg('MSGOUT-UBX_SEC_SIG_I2C', 0x20910634, 'U1'),
    UBloxCfg('MSGOUT-UBX_SEC_SIG_SPI', 0x20910638, 'U1'),
    UBloxCfg('MSGOUT-UBX_SEC_SIG_UART1', 0x20910635, 'U1'),
    UBloxCfg('MSGOUT-UBX_SEC_SIG_UART2', 0x20910636, 'U1'),
    UBloxCfg('MSGOUT-UBX_SEC_SIG_USB', 0x20910637, 'U1'),
    UBloxCfg('MSGOUT-UBX_TIM_SVIN_I2C', 0x20910097, 'U1'),
    UBloxCfg('MSGOUT-UBX_TIM_SVIN_SPI', 0x2091009b, 'U1'),
    UBloxCfg('MSGOUT-UBX_TIM_SVIN_UART1', 0x20910098, 'U1'),
    UBloxCfg('MSGOUT-UBX_TIM_SVIN_UART2', 0x20910099, 'U1'),
    UBloxCfg('MSGOUT-UBX_TIM_SVIN_USB', 0x2091009a, 'U1'),
    UBloxCfg('MSGOUT-UBX_TIM_TM2_I2C', 0x20910178, 'U1'),
    UBloxCfg('MSGOUT-UBX_TIM_TM2_SPI', 0x2091017c, 'U1'),
    UBloxCfg('MSGOUT-UBX_TIM_TM2_UART1', 0x20910179, 'U1'),
    UBloxCfg('MSGOUT-UBX_TIM_TM2_UART2', 0x2091017a, 'U1'),
    UBloxCfg('MSGOUT-UBX_TIM_TM2_USB', 0x2091017b, 'U1'),
    UBloxCfg('MSGOUT-UBX_TIM_TP_I2C', 0x2091017d, 'U1'),
    UBloxCfg('MSGOUT-UBX_TIM_TP_SPI', 0x20910181, 'U1'),
    UBloxCfg('MSGOUT-UBX_TIM_TP_UART1', 0x2091017e, 'U1'),
    UBloxCfg('MSGOUT-UBX_TIM_TP_UART2', 0x2091017f, 'U1'),
    UBloxCfg('MSGOUT-UBX_TIM_TP_USB', 0x20910180, 'U1'),
    UBloxCfg('MSGOUT-UBX_TIM_VRFY_I2C', 0x20910092, 'U1'),
    UBloxCfg('MSGOUT-UBX_TIM_VRFY_SPI', 0x20910096, 'U1'),
    UBloxCfg('MSGOUT-UBX_TIM_VRFY_UART1', 0x20910093, 'U1'),
    UBloxCfg('MSGOUT-UBX_TIM_VRFY_UART2', 0x20910094, 'U1'),
    UBloxCfg('MSGOUT-UBX_TIM_VRFY_USB', 0x20910095, 'U1'),
    UBloxCfg('NAV2-OUT_ENABLED', 0x10170001, 'L'),
    UBloxCfg('NAV2-SBAS_USE_INTEGRITY', 0x10170002, 'L'),
    UBloxCfg('NAV2-NAVSPG_ONLY_AUTHDATA', 0x10170003, 'L'),
    UBloxCfg('NAVMASK-SV_MASK_GPS', 0x50180013, 'X8'),
    UBloxCfg('NAVMASK-SV_MASK_GAL', 0x50180014, 'X8'),
    UBloxCfg('NAVMASK-SV_MASK_BDS', 0x50180016, 'X8'),
    UBloxCfg('NAVMASK-SV_MASK_QZSS', 0x50180017, 'X8'),
    UBloxCfg('NAVMASK-SV_MASK_NAVIC', 0x50180018, 'X8'),
    UBloxCfg('NAVMASK-EL_MASK_000_020', 0x50180001, 'X8'),
    UBloxCfg('NAVMASK-EL_MASK_020_040', 0x50180002, 'X8'),
    UBloxCfg('NAVMASK-EL_MASK_040_060', 0x50180003, 'X8'),
    UBloxCfg('NAVMASK-EL_MASK_060_080', 0x50180004, 'X8'),
    UBloxCfg('NAVMASK-EL_MASK_080_100', 0x50180005, 'X8'),
    UBloxCfg('NAVMASK-EL_MASK_100_120', 0x50180006, 'X8'),
    UBloxCfg('NAVMASK-EL_MASK_120_140', 0x50180007, 'X8'),
    UBloxCfg('NAVMASK-EL_MASK_140_160', 0x50180008, 'X8'),
    UBloxCfg('NAVMASK-EL_MASK_160_180', 0x50180009, 'X8'),
    UBloxCfg('NAVMASK-EL_MASK_180_200', 0x5018000a, 'X8'),
    UBloxCfg('NAVMASK-EL_MASK_200_220', 0x5018000b, 'X8'),
    UBloxCfg('NAVMASK-EL_MASK_220_240', 0x5018000c, 'X8'),
    UBloxCfg('NAVMASK-EL_MASK_240_260', 0x5018000d, 'X8'),
    UBloxCfg('NAVMASK-EL_MASK_260_280', 0x5018000e, 'X8'),
    UBloxCfg('NAVMASK-EL_MASK_280_300', 0x5018000f, 'X8'),
    UBloxCfg('NAVMASK-EL_MASK_300_320', 0x50180010, 'X8'),
    UBloxCfg('NAVMASK-EL_MASK_320_340', 0x50180011, 'X8'),
    UBloxCfg('NAVMASK-EL_MASK_340_360', 0x50180012, 'X8'),
    UBloxCfg('NAVSPG-FIXMODE', 0x20110011, 'E1'),
    UBloxCfg('NAVSPG-INIFIX3D', 0x10110013, 'L'),
    UBloxCfg('NAVSPG-WKNROLLOVER', 0x30110017, 'U2'),
    UBloxCfg('NAVSPG-USE_PPP', 0x10110019, 'L'),
    UBloxCfg('NAVSPG-UTCSTANDARD', 0x2011001c, 'E1'),
    UBloxCfg('NAVSPG-DYNMODEL', 0x20110021, 'E1'),
    UBloxCfg('NAVSPG-ACKAIDING', 0x10110025, 'L'),
    UBloxCfg('NAVSPG-USE_USRDAT', 0x10110061, 'L'),
    UBloxCfg('NAVSPG-USRDAT_MAJA', 0x50110062, 'R8'),
    UBloxCfg('NAVSPG-USRDAT_FLAT', 0x50110063, 'R8'),
    UBloxCfg('NAVSPG-USRDAT_DX', 0x40110064, 'R4'),
    UBloxCfg('NAVSPG-USRDAT_DY', 0x40110065, 'R4'),
    UBloxCfg('NAVSPG-USRDAT_DZ', 0x40110066, 'R4'),
    UBloxCfg('NAVSPG-USRDAT_ROTX', 0x40110067, 'R4'),
    UBloxCfg('NAVSPG-USRDAT_ROTY', 0x40110068, 'R4'),
    UBloxCfg('NAVSPG-USRDAT_ROTZ', 0x40110069, 'R4'),
    UBloxCfg('NAVSPG-USRDAT_SCALE', 0x4011006a, 'R4'),
    UBloxCfg('NAVSPG-INFIL_MINSVS', 0x201100a1, 'U1'),
    UBloxCfg('NAVSPG-INFIL_MAXSVS', 0x201100a2, 'U1'),
    UBloxCfg('NAVSPG-INFIL_MINCNO', 0x201100a3, 'U1'),
    UBloxCfg('NAVSPG-INFIL_MINELEV', 0x201100a4, 'I1'),
    UBloxCfg('NAVSPG-INFIL_NCNOTHRS', 0x201100aa, 'U1'),
    UBloxCfg('NAVSPG-INFIL_CNOTHRS', 0x201100ab, 'U1'),
    UBloxCfg('NAVSPG-OUTFIL_PDOP', 0x301100b1, 'U2'),
    UBloxCfg('NAVSPG-OUTFIL_TDOP', 0x301100b2, 'U2'),
    UBloxCfg('NAVSPG-OUTFIL_PACC', 0x301100b3, 'U2'),
    UBloxCfg('NAVSPG-OUTFIL_TACC', 0x301100b4, 'U2'),
    UBloxCfg('NAVSPG-OUTFIL_FACC', 0x301100b5, 'U2'),
    UBloxCfg('NAVSPG-CONSTR_ALT', 0x401100c1, 'I4'),
    UBloxCfg('NAVSPG-CONSTR_ALTVAR', 0x401100c2, 'U4'),
    UBloxCfg('NAVSPG-CONSTR_DGNSSTO', 0x201100c4, 'U1'),
    UBloxCfg('NAVSPG-CONSTR_DGNSSTO_SCALE', 0x201100c5, 'U1'),
    UBloxCfg('NAVSPG-SIGATTCOMP', 0x201100d6, 'E1'),
    UBloxCfg('NAVSPG-PL_ENA', 0x101100d7, 'L'),
    UBloxCfg('NAVSPG-ONLY_AUTHDATA', 0x101100dd, 'L'),
    UBloxCfg('NAVSPG-MAX_TIMETRUSTED_', 0x301100de, 'U2'),
    UBloxCfg('NMEA-PROTVER', 0x20930001, 'E1'),
    UBloxCfg('NMEA-MAXSVS', 0x20930002, 'E1'),
    UBloxCfg('NMEA-COMPAT', 0x10930003, 'L'),
    UBloxCfg('NMEA-CONSIDER', 0x10930004, 'L'),
    UBloxCfg('NMEA-LIMIT82', 0x10930005, 'L'),
    UBloxCfg('NMEA-HIGHPREC', 0x10930006, 'L'),
    UBloxCfg('NMEA-SVNUMBERING', 0x20930007, 'E1'),
    UBloxCfg('NMEA-FILT_GPS', 0x10930011, 'L'),
    UBloxCfg('NMEA-FILT_SBAS', 0x10930012, 'L'),
    UBloxCfg('NMEA-FILT_GAL', 0x10930013, 'L'),
    UBloxCfg('NMEA-FILT_QZSS', 0x10930015, 'L'),
    UBloxCfg('NMEA-FILT_GLO', 0x10930016, 'L'),
    UBloxCfg('NMEA-FILT_BDS', 0x10930017, 'L'),
    UBloxCfg('NMEA-FILT_NAVIC', 0x10930018, 'L'),
    UBloxCfg('NMEA-OUT_INVFIX', 0x10930021, 'L'),
    UBloxCfg('NMEA-OUT_MSKFIX', 0x10930022, 'L'),
    UBloxCfg('NMEA-OUT_INVTIME', 0x10930023, 'L'),
    UBloxCfg('NMEA-OUT_INVDATE', 0x10930024, 'L'),
    UBloxCfg('NMEA-OUT_ONLYGPS', 0x10930025, 'L'),
    UBloxCfg('NMEA-OUT_FROZENCOG', 0x10930026, 'L'),
    UBloxCfg('NMEA-MAINTALKERID', 0x20930031, 'E1'),
    UBloxCfg('NMEA-GSVTALKERID', 0x20930032, 'E1'),
    UBloxCfg('NMEA-BDSTALKERID', 0x30930033, 'U2'),
    UBloxCfg('ODO-USE_ODO', 0x10220001, 'L'),
    UBloxCfg('ODO-USE_COG', 0x10220002, 'L'),
    UBloxCfg('ODO-OUTLPVEL', 0x10220003, 'L'),
    UBloxCfg('ODO-OUTLPCOG', 0x10220004, 'L'),
    UBloxCfg('ODO-PROFILE', 0x20220005, 'E1'),
    UBloxCfg('ODO-COGMAXSPEED', 0x20220021, 'U1'),
    UBloxCfg('ODO-COGMAXPOSACC', 0x20220022, 'U1'),
    UBloxCfg('ODO-VELLPGAIN', 0x20220031, 'U1'),
    UBloxCfg('ODO-COGLPGAIN', 0x20220032, 'U1'),
    UBloxCfg('PM-OPERATEMODE', 0x20d00001, 'E1'),
    UBloxCfg('PM-POSUPDATEPERIOD', 0x40d00002, 'U4'),
    UBloxCfg('PM-ACQPERIOD', 0x40d00003, 'U4'),
    UBloxCfg('PM-GRIDOFFSET', 0x40d00004, 'U4'),
    UBloxCfg('PM-ONTIME', 0x30d00005, 'U2'),
    UBloxCfg('PM-MINACQTIME', 0x20d00006, 'U1'),
    UBloxCfg('PM-MAXACQTIME', 0x20d00007, 'U1'),
    UBloxCfg('PM-DONOTENTEROFF', 0x10d00008, 'L'),
    UBloxCfg('PM-WAITTIMEFIX', 0x10d00009, 'L'),
    UBloxCfg('PM-UPDATEEPH', 0x10d0000a, 'L'),
    UBloxCfg('PM-EXTINTWAKE', 0x10d0000c, 'L'),
    UBloxCfg('PM-EXTINTBACKUP', 0x10d0000d, 'L'),
    UBloxCfg('PM-EXTINTINACTIVE', 0x10d0000e, 'L'),
    UBloxCfg('PM-EXTINTINACTIVITY', 0x40d0000f, 'U4'),
    UBloxCfg('PM-LIMITPEAKCURR', 0x10d00010, 'L'),
    UBloxCfg('QZSS-USE_SLAS_DGNSS', 0x10370005, 'L'),
    UBloxCfg('QZSS-USE_SLAS_TESTMODE', 0x10370006, 'L'),
    UBloxCfg('QZSS-USE_SLAS_RAIM_UNCORR', 0x10370007, 'L'),
    UBloxCfg('QZSS-SLAS_MAX_BASELINE', 0x30370008, 'U2'),
    UBloxCfg('RATE-MEAS', 0x30210001, 'U2'),
    UBloxCfg('RATE-NAV', 0x30210002, 'U2'),
    UBloxCfg('RATE-TIMEREF', 0x20210003, 'E1'),
    UBloxCfg('RINV-DUMP', 0x10c70001, 'L'),
    UBloxCfg('RINV-BINARY', 0x10c70002, 'L'),
    UBloxCfg('RINV-DATA_SIZE', 0x20c70003, 'U1'),
    UBloxCfg('RINV-CHUNK0', 0x50c70004, 'X8'),
    UBloxCfg('RINV-CHUNK1', 0x50c70005, 'X8'),
    UBloxCfg('RINV-CHUNK2', 0x50c70006, 'X8'),
    UBloxCfg('RINV-CHUNK3', 0x50c70007, 'X8'),
    UBloxCfg('RTCM-DF003_OUT', 0x30090001, 'U2'),
    UBloxCfg('RTCM-DF003_IN', 0x30090008, 'U2'),
    UBloxCfg('RTCM-DF003_IN_FILTER', 0x20090009, 'E1'),
    UBloxCfg('SBAS-USE_TESTMODE', 0x10360002, 'L'),
    UBloxCfg('SBAS-USE_RANGING', 0x10360003, 'L'),
    UBloxCfg('SBAS-USE_DIFFCORR', 0x10360004, 'L'),
    UBloxCfg('SBAS-USE_INTEGRITY', 0x10360005, 'L'),
    UBloxCfg('SBAS-ACCEPT_NOT_IN_PRNMASK', 0x30360008, 'X2'),
    UBloxCfg('SBAS-USE_IONOONLY', 0x10360007, 'L'),
    UBloxCfg('SBAS-PRNSCANMASK', 0x50360006, 'X8'),
    UBloxCfg('SEC-CFG_LOCK', 0x10f60009, 'L'),
    UBloxCfg('SEC-CFG_LOCK_UNLOCKGRP1', 0x30f6000a, 'U2'),
    UBloxCfg('SEC-CFG_LOCK_UNLOCKGRP2', 0x30f6000b, 'U2'),
    UBloxCfg('SEC-SPOOFDET_SIM_SIG_DIS', 0x10f6005d, 'L'),
    UBloxCfg('SEC-JAMDET_SENSITIVITY_HI', 0x10f60051, 'L'),
    UBloxCfg('SIGNAL-GPS_ENA', 0x1031001f, 'L'),
    UBloxCfg('SIGNAL-GPS_L1CA_ENA', 0x10310001, 'L'),
    UBloxCfg('SIGNAL-GPS_L2C_ENA', 0x10310003, 'L'),
    UBloxCfg('SIGNAL-GPS_L5_ENA', 0x10310004, 'L'),
    UBloxCfg('SIGNAL-SBAS_ENA', 0x10310020, 'L'),
    UBloxCfg('SIGNAL-SBAS_L1CA_ENA', 0x10310005, 'L'),
    UBloxCfg('SIGNAL-GAL_ENA', 0x10310021, 'L'),
    UBloxCfg('SIGNAL-GAL_E1_ENA', 0x10310007, 'L'),
    UBloxCfg('SIGNAL-GAL_E5A_ENA', 0x10310009, 'L'),
    UBloxCfg('SIGNAL-GAL_E5B_ENA', 0x1031000a, 'L'),
    UBloxCfg('SIGNAL-BDS_ENA', 0x10310022, 'L'),
    UBloxCfg('SIGNAL-BDS_B1_ENA', 0x1031000d, 'L'),
    UBloxCfg('SIGNAL-BDS_B1C_ENA', 0x1031000f, 'L'),
    UBloxCfg('SIGNAL-BDS_B2_ENA', 0x1031000e, 'L'),
    UBloxCfg('SIGNAL-BDS_B2A_ENA', 0x10310028, 'L'),
    UBloxCfg('SIGNAL-QZSS_ENA', 0x10310024, 'L'),
    UBloxCfg('SIGNAL-QZSS_L1CA_ENA', 0x10310012, 'L'),
    UBloxCfg('SIGNAL-QZSS_L1S_ENA', 0x10310014, 'L'),
    UBloxCfg('SIGNAL-QZSS_L2C_ENA', 0x10310015, 'L'),
    UBloxCfg('SIGNAL-QZSS_L5_ENA', 0x10310017, 'L'),
    UBloxCfg('SIGNAL-NAVIC_ENA', 0x10310026, 'L'),
    UBloxCfg('SIGNAL-NAVIC_L5_ENA', 0x1031001d, 'L'),
    UBloxCfg('SPI-MAXFF', 0x20640001, 'U1'),
    UBloxCfg('SPI-CPOLARITY', 0x10640002, 'L'),
    UBloxCfg('SPI-CPHASE', 0x10640003, 'L'),
    UBloxCfg('SPI-EXTENDEDTIMEOUT', 0x10640005, 'L'),
    UBloxCfg('SPI-ENABLED', 0x10640006, 'L'),
    UBloxCfg('SPIINPROT-UBX', 0x10790001, 'L'),
    UBloxCfg('SPIINPROT-NMEA', 0x10790002, 'L'),
    UBloxCfg('SPIINPROT-RTCM3X', 0x10790004, 'L'),
    UBloxCfg('SPIOUTPROT-UBX', 0x107a0001, 'L'),
    UBloxCfg('SPIOUTPROT-NMEA', 0x107a0002, 'L'),
    UBloxCfg('SPIOUTPROT-RTCM3X', 0x107a0004, 'L'),
    UBloxCfg('TMODE-MODE', 0x20030001, 'E1'),
    UBloxCfg('TMODE-POS_TYPE', 0x20030002, 'E1'),
    UBloxCfg('TMODE-ECEF_X', 0x40030003, 'I4'),
    UBloxCfg('TMODE-ECEF_Y', 0x40030004, 'I4'),
    UBloxCfg('TMODE-ECEF_Z', 0x40030005, 'I4'),
    UBloxCfg('TMODE-ECEF_X_HP', 0x20030006, 'I1'),
    UBloxCfg('TMODE-ECEF_Y_HP', 0x20030007, 'I1'),
    UBloxCfg('TMODE-ECEF_Z_HP', 0x20030008, 'I1'),
    UBloxCfg('TMODE-LAT', 0x40030009, 'I4'),
    UBloxCfg('TMODE-LON', 0x4003000a, 'I4'),
    UBloxCfg('TMODE-HEIGHT', 0x4003000b, 'I4'),
    UBloxCfg('TMODE-LAT_HP', 0x2003000c, 'I1'),
    UBloxCfg('TMODE-LON_HP', 0x2003000d, 'I1'),
    UBloxCfg('TMODE-HEIGHT_HP', 0x2003000e, 'I1'),
    UBloxCfg('TMODE-FIXED_POS_ACC', 0x4003000f, 'U4'),
    UBloxCfg('TMODE-SVIN_MIN_DUR', 0x40030010, 'U4'),
    UBloxCfg('TMODE-SVIN_ACC_LIMIT', 0x40030011, 'U4'),
    UBloxCfg('TP-PULSE_DEF', 0x20050023, 'E1'),
    UBloxCfg('TP-PULSE_LENGTH_DEF', 0x20050030, 'E1'),
    UBloxCfg('TP-ANT_CABLEDELAY', 0x30050001, 'I2'),
    UBloxCfg('TP-PERIOD_TP1', 0x40050002, 'U4'),
    UBloxCfg('TP-PERIOD_LOCK_TP1', 0x40050003, 'U4'),
    UBloxCfg('TP-FREQ_TP1', 0x40050024, 'U4'),
    UBloxCfg('TP-FREQ_LOCK_TP1', 0x40050025, 'U4'),
    UBloxCfg('TP-LEN_TP1', 0x40050004, 'U4'),
    UBloxCfg('TP-LEN_LOCK_TP1', 0x40050005, 'U4'),
    UBloxCfg('TP-DUTY_TP1', 0x5005002a, 'R8'),
    UBloxCfg('TP-DUTY_LOCK_TP1', 0x5005002b, 'R8'),
    UBloxCfg('TP-USER_DELAY_TP1', 0x40050006, 'I4'),
    UBloxCfg('TP-TP1_ENA', 0x10050007, 'L'),
    UBloxCfg('TP-SYNC_GNSS_TP1', 0x10050008, 'L'),
    UBloxCfg('TP-USE_LOCKED_TP1', 0x10050009, 'L'),
    UBloxCfg('TP-ALIGN_TO_TOW_TP1', 0x1005000a, 'L'),
    UBloxCfg('TP-POL_TP1', 0x1005000b, 'L'),
    UBloxCfg('TP-TIMEGRID_TP1', 0x2005000c, 'E1'),
    UBloxCfg('TP-PERIOD_TP2', 0x4005000d, 'U4'),
    UBloxCfg('TP-PERIOD_LOCK_TP2', 0x4005000e, 'U4'),
    UBloxCfg('TP-FREQ_TP2', 0x40050026, 'U4'),
    UBloxCfg('TP-FREQ_LOCK_TP2', 0x40050027, 'U4'),
    UBloxCfg('TP-LEN_TP2', 0x4005000f, 'U4'),
    UBloxCfg('TP-LEN_LOCK_TP2', 0x40050010, 'U4'),
    UBloxCfg('TP-DUTY_TP2', 0x5005002c, 'R8'),
    UBloxCfg('TP-DUTY_LOCK_TP2', 0x5005002d, 'R8'),
    UBloxCfg('TP-USER_DELAY_TP2', 0x40050011, 'I4'),
    UBloxCfg('TP-TP2_ENA', 0x10050012, 'L'),
    UBloxCfg('TP-SYNC_GNSS_TP2', 0x10050013, 'L'),
    UBloxCfg('TP-USE_LOCKED_TP2', 0x10050014, 'L'),
    UBloxCfg('TP-ALIGN_TO_TOW_TP2', 0x10050015, 'L'),
    UBloxCfg('TP-POL_TP2', 0x10050016, 'L'),
    UBloxCfg('TP-TIMEGRID_TP2', 0x20050017, 'E1'),
    UBloxCfg('TP-DRSTR_TP1', 0x20050035, 'E1'),
    UBloxCfg('TP-DRSTR_TP2', 0x20050036, 'E1'),
    UBloxCfg('TP-MSG_ALWAYS', 0x10050037, 'L'),
    UBloxCfg('TXREADY-ENABLED', 0x10a20001, 'L'),
    UBloxCfg('TXREADY-POLARITY', 0x10a20002, 'L'),
    UBloxCfg('TXREADY-PIN', 0x20a20003, 'U1'),
    UBloxCfg('TXREADY-THRESHOLD', 0x30a20004, 'U2'),
    UBloxCfg('TXREADY-INTERFACE', 0x20a20005, 'E1'),
    UBloxCfg('UART1-BAUDRATE', 0x40520001, 'U4'),
    UBloxCfg('UART1-STOPBITS', 0x20520002, 'E1'),
    UBloxCfg('UART1-DATABITS', 0x20520003, 'E1'),
    UBloxCfg('UART1-PARITY', 0x20520004, 'E1'),
    UBloxCfg('UART1-ENABLED', 0x10520005, 'L'),
    UBloxCfg('UART1INPROT-UBX', 0x10730001, 'L'),
    UBloxCfg('UART1INPROT-NMEA', 0x10730002, 'L'),
    UBloxCfg('UART1INPROT-RTCM3X', 0x10730004, 'L'),
    UBloxCfg('UART1OUTPROT-UBX', 0x10740001, 'L'),
    UBloxCfg('UART1OUTPROT-NMEA', 0x10740002, 'L'),
    UBloxCfg('UART1OUTPROT-RTCM3X', 0x10740004, 'L'),
    UBloxCfg('UART2-BAUDRATE', 0x40530001, 'U4'),
    UBloxCfg('UART2-STOPBITS', 0x20530002, 'E1'),
    UBloxCfg('UART2-DATABITS', 0x20530003, 'E1'),
    UBloxCfg('UART2-PARITY', 0x20530004, 'E1'),
    UBloxCfg('UART2-ENABLED', 0x10530005, 'L'),
    UBloxCfg('UART2INPROT-UBX', 0x10750001, 'L'),
    UBloxCfg('UART2INPROT-NMEA', 0x10750002, 'L'),
    UBloxCfg('UART2INPROT-RTCM3X', 0x10750004, 'L'),
    UBloxCfg('UART2OUTPROT-UBX', 0x10760001, 'L'),
    UBloxCfg('UART2OUTPROT-NMEA', 0x10760002, 'L'),
    UBloxCfg('UART2OUTPROT-RTCM3X', 0x10760004, 'L'),
    UBloxCfg('USB-ENABLED', 0x10650001, 'L'),
    UBloxCfg('USB-SELFPOW', 0x10650002, 'L'),
    UBloxCfg('USB-VENDOR_ID', 0x3065000a, 'U2'),
    UBloxCfg('USB-PRODUCT_ID', 0x3065000b, 'U2'),
    UBloxCfg('USB-POWER', 0x3065000c, 'U2'),
    UBloxCfg('USB-VENDOR_STR0', 0x5065000d, 'X8'),
    UBloxCfg('USB-VENDOR_STR1', 0x5065000e, 'X8'),
    UBloxCfg('USB-VENDOR_STR2', 0x5065000f, 'X8'),
    UBloxCfg('USB-VENDOR_STR3', 0x50650010, 'X8'),
    UBloxCfg('USB-PRODUCT_STR0', 0x50650011, 'X8'),
    UBloxCfg('USB-PRODUCT_STR1', 0x50650012, 'X8'),
    UBloxCfg('USB-PRODUCT_STR2', 0x50650013, 'X8'),
    UBloxCfg('USB-PRODUCT_STR3', 0x50650014, 'X8'),
    UBloxCfg('USB-SERIAL_NO_STR0', 0x50650015, 'X8'),
    UBloxCfg('USB-SERIAL_NO_STR1', 0x50650016, 'X8'),
    UBloxCfg('USB-SERIAL_NO_STR2', 0x50650017, 'X8'),
    UBloxCfg('USB-SERIAL_NO_STR3', 0x50650018, 'X8'),
    UBloxCfg('USBINPROT-UBX', 0x10770001, 'L'),
    UBloxCfg('USBINPROT-NMEA', 0x10770002, 'L'),
    UBloxCfg('USBINPROT-RTCM3X', 0x10770004, 'L'),
    UBloxCfg('USBOUTPROT-UBX', 0x10780001, 'L'),
    UBloxCfg('USBOUTPROT-NMEA', 0x10780002, 'L'),
    UBloxCfg('USBOUTPROT-RTCM3X', 0x10780004, 'L'),
    UBloxCfg('ANA-USE_ANA', 0x10230001, 'L'),
    UBloxCfg('ANA-ORBMAXERR', 0x30230002, 'U2'),
    UBloxCfg('BATCH-ENABLE', 0x10260013, 'L'),
    UBloxCfg('BATCH-PIOENABLE', 0x10260014, 'L'),
    UBloxCfg('BATCH-MAXENTRIES', 0x30260015, 'U2'),
    UBloxCfg('BATCH-WARNTHRS', 0x30260016, 'U2'),
    UBloxCfg('BATCH-PIOACTIVELOW', 0x10260018, 'L'),
    UBloxCfg('BATCH-PIOID', 0x20260019, 'U1'),
    UBloxCfg('BATCH-EXTRAPVT', 0x1026001a, 'L'),
    UBloxCfg('BATCH-EXTRAODO', 0x1026001b, 'L'),
    UBloxCfg('BDS-D1D2_NAVDATA', 0x20340009, 'E1'),
    UBloxCfg('BDS-USE_GEO_PRN', 0x10340014, 'L'),
    UBloxCfg('GAL-USE_OSNMA', 0x10350005, 'L'),
    UBloxCfg('GAL-OSNMA_MINTAGLENGTH', 0x20350007, 'U1'),
    UBloxCfg('GAL-OSNMA_TIMESYNC', 0x10350009, 'L'),
    UBloxCfg('GAL-OSNMA_INAVPRIM', 0x10350010, 'L'),
    UBloxCfg('GEOFENCE-CONFLVL', 0x20240011, 'E1'),
    UBloxCfg('GEOFENCE-USE_PIO', 0x10240012, 'L'),
    UBloxCfg('GEOFENCE-PINPOL', 0x20240013, 'E1'),
    UBloxCfg('GEOFENCE-PIN', 0x20240014, 'U1'),
    UBloxCfg('GEOFENCE-USE_FENCE1', 0x10240020, 'L'),
    UBloxCfg('GEOFENCE-FENCE1_LAT', 0x40240021, 'I4'),
    UBloxCfg('GEOFENCE-FENCE1_LON', 0x40240022, 'I4'),
    UBloxCfg('GEOFENCE-FENCE1_RAD', 0x40240023, 'U4'),
    UBloxCfg('GEOFENCE-USE_FENCE2', 0x10240030, 'L'),
    UBloxCfg('GEOFENCE-FENCE2_LAT', 0x40240031, 'I4'),
    UBloxCfg('GEOFENCE-FENCE2_LON', 0x40240032, 'I4'),
    UBloxCfg('GEOFENCE-FENCE2_RAD', 0x40240033, 'U4'),
    UBloxCfg('GEOFENCE-USE_FENCE3', 0x10240040, 'L'),
    UBloxCfg('GEOFENCE-FENCE3_LAT', 0x40240041, 'I4'),
    UBloxCfg('GEOFENCE-FENCE3_LON', 0x40240042, 'I4'),
    UBloxCfg('GEOFENCE-FENCE3_RAD', 0x40240043, 'U4'),
    UBloxCfg('GEOFENCE-USE_FENCE4', 0x10240050, 'L'),
    UBloxCfg('GEOFENCE-FENCE4_LAT', 0x40240051, 'I4'),
    UBloxCfg('GEOFENCE-FENCE4_LON', 0x40240052, 'I4'),
    UBloxCfg('GEOFENCE-FENCE4_RAD', 0x40240053, 'U4'),
    UBloxCfg('HW-ANT_CFG_VOLTCTRL', 0x10a3002e, 'L'),
    UBloxCfg('HW-ANT_CFG_SHORTDET', 0x10a3002f, 'L'),
    UBloxCfg('HW-ANT_CFG_SHORTDET_POL', 0x10a30030, 'L'),
    UBloxCfg('HW-ANT_CFG_OPENDET', 0x10a30031, 'L'),
    UBloxCfg('HW-ANT_CFG_OPENDET_POL', 0x10a30032, 'L'),
    UBloxCfg('HW-ANT_CFG_PWRDOWN', 0x10a30033, 'L'),
    UBloxCfg('HW-ANT_CFG_PWRDOWN_POL', 0x10a30034, 'L'),
    UBloxCfg('HW-ANT_CFG_RECOVER', 0x10a30035, 'L'),
    UBloxCfg('HW-ANT_SUP_SWITCH_PIN', 0x20a30036, 'U1'),
    UBloxCfg('HW-ANT_SUP_SHORT_PIN', 0x20a30037, 'U1'),
    UBloxCfg('HW-ANT_SUP_OPEN_PIN', 0x20a30038, 'U1'),
    UBloxCfg('HW-ANT_ON_SHORT_US', 0x30a3003c, 'U2'),
    UBloxCfg('HW-ANT_SUP_ENGINE', 0x20a30054, 'E1'),
    UBloxCfg('HW-ANT_SUP_SHORT_THR', 0x20a30055, 'U1'),
    UBloxCfg('HW-ANT_SUP_OPEN_THR', 0x20a30056, 'U1'),
    UBloxCfg('HW-RF_LNA_MODE', 0x20a30057, 'E1'),
    UBloxCfg('I2C-ADDRESS', 0x20510001, 'U1'),
    UBloxCfg('I2C-EXTENDEDTIMEOUT', 0x10510002, 'L'),
    UBloxCfg('I2C-ENABLED', 0x10510003, 'L'),
    UBloxCfg('I2CINPROT-UBX', 0x10710001, 'L'),
    UBloxCfg('I2CINPROT-NMEA', 0x10710002, 'L'),
    UBloxCfg('I2CINPROT-RTCM3X', 0x10710004, 'L'),
    UBloxCfg('I2COUTPROT-UBX', 0x10720001, 'L'),
    UBloxCfg('I2COUTPROT-NMEA', 0x10720002, 'L'),
    UBloxCfg('I2COUTPROT-RTCM3X', 0x10720004, 'L'),
    UBloxCfg('INFMSG-UBX_I2C', 0x20920001, 'X1'),
    UBloxCfg('INFMSG-UBX_UART1', 0x20920002, 'X1'),
    UBloxCfg('INFMSG-UBX_UART2', 0x20920003, 'X1'),
    UBloxCfg('INFMSG-UBX_USB', 0x20920004, 'X1'),
    UBloxCfg('INFMSG-UBX_SPI', 0x20920005, 'X1'),
    UBloxCfg('INFMSG-NMEA_I2C', 0x20920006, 'X1'),
    UBloxCfg('INFMSG-NMEA_UART1', 0x20920007, 'X1'),
    UBloxCfg('INFMSG-NMEA_UART2', 0x20920008, 'X1'),
    UBloxCfg('INFMSG-NMEA_USB', 0x20920009, 'X1'),
    UBloxCfg('INFMSG-NMEA_SPI', 0x2092000a, 'X1'),
    UBloxCfg('ITFM-BBTHRESHOLD', 0x20410001, 'U1'),
    UBloxCfg('ITFM-CWTHRESHOLD', 0x20410002, 'U1'),
    UBloxCfg('ITFM-ENABLE', 0x1041000d, 'L'),
    UBloxCfg('ITFM-ANTSETTING', 0x20410010, 'E1'),
    UBloxCfg('ITFM-ENABLE_AUX', 0x10410013, 'L'),
    UBloxCfg('LOGFILTER-RECORD_ENA', 0x10de0002, 'L'),
    UBloxCfg('LOGFILTER-ONCE_PER_WAKE_UP_ENA', 0x10de0003, 'L'),
    UBloxCfg('LOGFILTER-APPLY_ALL_FILTERS', 0x10de0004, 'L'),
    UBloxCfg('LOGFILTER-MIN_INTERVAL', 0x30de0005, 'U2'),
    UBloxCfg('LOGFILTER-TIME_THRS', 0x30de0006, 'U2'),
    UBloxCfg('LOGFILTER-SPEED_THRS', 0x30de0007, 'U2'),
    UBloxCfg('LOGFILTER-POSITION_THRS', 0x40de0008, 'U4'),
    UBloxCfg('MOT-GNSSSPEED_THRS', 0x20250038, 'U1'),
    UBloxCfg('MOT-GNSSDIST_THRS', 0x3025003b, 'U2'),
    UBloxCfg('MSGOUT-NMEA_ID_DTM_I2C', 0x209100a6, 'U1'),
    UBloxCfg('MSGOUT-NMEA_ID_DTM_SPI', 0x209100aa, 'U1'),
    UBloxCfg('MSGOUT-NMEA_ID_DTM_UART1', 0x209100a7, 'U1'),
    UBloxCfg('MSGOUT-NMEA_ID_DTM_UART2', 0x209100a8, 'U1'),
    UBloxCfg('MSGOUT-NMEA_ID_DTM_USB', 0x209100a9, 'U1'),
    UBloxCfg('MSGOUT-NMEA_ID_GBS_I2C', 0x209100dd, 'U1'),
    UBloxCfg('MSGOUT-NMEA_ID_GBS_SPI', 0x209100e1, 'U1'),
    UBloxCfg('MSGOUT-NMEA_ID_GBS_UART1', 0x209100de, 'U1'),
    UBloxCfg('MSGOUT-NMEA_ID_GBS_UART2', 0x209100df, 'U1'),
    UBloxCfg('MSGOUT-NMEA_ID_GBS_USB', 0x209100e0, 'U1'),
    UBloxCfg('MSGOUT-NMEA_ID_GGA_I2C', 0x209100ba, 'U1'),
    UBloxCfg('MSGOUT-NMEA_ID_GGA_SPI', 0x209100be, 'U1'),
    UBloxCfg('MSGOUT-NMEA_ID_GGA_UART1', 0x209100bb, 'U1'),
    UBloxCfg('MSGOUT-NMEA_ID_GGA_UART2', 0x209100bc, 'U1'),
    UBloxCfg('MSGOUT-NMEA_ID_GGA_USB', 0x209100bd, 'U1'),
    UBloxCfg('MSGOUT-NMEA_ID_GLL_I2C', 0x209100c9, 'U1'),
    UBloxCfg('MSGOUT-NMEA_ID_GLL_SPI', 0x209100cd, 'U1'),
    UBloxCfg('MSGOUT-NMEA_ID_GLL_UART1', 0x209100ca, 'U1'),
    UBloxCfg('MSGOUT-NMEA_ID_GLL_UART2', 0x209100cb, 'U1'),
    UBloxCfg('MSGOUT-NMEA_ID_GLL_USB', 0x209100cc, 'U1'),
    UBloxCfg('MSGOUT-NMEA_ID_GNS_I2C', 0x209100b5, 'U1'),
    UBloxCfg('MSGOUT-NMEA_ID_GNS_SPI', 0x209100b9, 'U1'),
    UBloxCfg('MSGOUT-NMEA_ID_GNS_UART1', 0x209100b6, 'U1'),
    UBloxCfg('MSGOUT-NMEA_ID_GNS_UART2', 0x209100b7, 'U1'),
    UBloxCfg('MSGOUT-NMEA_ID_GNS_USB', 0x209100b8, 'U1'),
    UBloxCfg('MSGOUT-NMEA_ID_GRS_I2C', 0x209100ce, 'U1'),
    UBloxCfg('MSGOUT-NMEA_ID_GRS_SPI', 0x209100d2, 'U1'),
    UBloxCfg('MSGOUT-NMEA_ID_GRS_UART1', 0x209100cf, 'U1'),
    UBloxCfg('MSGOUT-NMEA_ID_GRS_UART2', 0x209100d0, 'U1'),
    UBloxCfg('MSGOUT-NMEA_ID_GRS_USB', 0x209100d1, 'U1'),
    UBloxCfg('MSGOUT-NMEA_ID_GSA_I2C', 0x209100bf, 'U1'),
    UBloxCfg('MSGOUT-NMEA_ID_GSA_SPI', 0x209100c3, 'U1'),
    UBloxCfg('MSGOUT-NMEA_ID_GSA_UART1', 0x209100c0, 'U1'),
    UBloxCfg('MSGOUT-NMEA_ID_GSA_UART2', 0x209100c1, 'U1'),
    UBloxCfg('MSGOUT-NMEA_ID_GSA_USB', 0x209100c2, 'U1'),
    UBloxCfg('MSGOUT-NMEA_ID_GST_I2C', 0x209100d3, 'U1'),
    UBloxCfg('MSGOUT-NMEA_ID_GST_SPI', 0x209100d7, 'U1'),
    UBloxCfg('MSGOUT-NMEA_ID_GST_UART1', 0x209100d4, 'U1'),
    UBloxCfg('MSGOUT-NMEA_ID_GST_UART2', 0x209100d5, 'U1'),
    UBloxCfg('MSGOUT-NMEA_ID_GST_USB', 0x209100d6, 'U1'),
    UBloxCfg('MSGOUT-NMEA_ID_GSV_I2C', 0x209100c4, 'U1'),
    UBloxCfg('MSGOUT-NMEA_ID_GSV_SPI', 0x209100c8, 'U1'),
    UBloxCfg('MSGOUT-NMEA_ID_GSV_UART1', 0x209100c5, 'U1'),
    UBloxCfg('MSGOUT-NMEA_ID_GSV_UART2', 0x209100c6, 'U1'),
    UBloxCfg('MSGOUT-NMEA_ID_GSV_USB', 0x209100c7, 'U1'),
    UBloxCfg('MSGOUT-NMEA_ID_RLM_I2C', 0x20910400, 'U1'),
    UBloxCfg('MSGOUT-NMEA_ID_RLM_SPI', 0x20910404, 'U1'),
    UBloxCfg('MSGOUT-NMEA_ID_RLM_UART1', 0x20910401, 'U1'),
    UBloxCfg('MSGOUT-NMEA_ID_RLM_UART2', 0x20910402, 'U1'),
    UBloxCfg('MSGOUT-NMEA_ID_RLM_USB', 0x20910403, 'U1'),
    UBloxCfg('MSGOUT-NMEA_ID_RMC_I2C', 0x209100ab, 'U1'),
    UBloxCfg('MSGOUT-NMEA_ID_RMC_SPI', 0x209100af, 'U1'),
    UBloxCfg('MSGOUT-NMEA_ID_RMC_UART1', 0x209100ac, 'U1'),
    UBloxCfg('MSGOUT-NMEA_ID_RMC_UART2', 0x209100ad, 'U1'),
    UBloxCfg('MSGOUT-NMEA_ID_RMC_USB', 0x209100ae, 'U1'),
    UBloxCfg('MSGOUT-NMEA_ID_UTC_I2C', 0x209106cf, 'U1'),
    UBloxCfg('MSGOUT-NMEA_ID_UTC_SPI', 0x209106d3, 'U1'),
    UBloxCfg('MSGOUT-NMEA_ID_UTC_UART1', 0x209106d0, 'U1'),
    UBloxCfg('MSGOUT-NMEA_ID_UTC_UART2', 0x209106d1, 'U1'),
    UBloxCfg('MSGOUT-NMEA_ID_UTC_USB', 0x209106d2, 'U1'),
    UBloxCfg('MSGOUT-NMEA_ID_VLW_I2C', 0x209100e7, 'U1'),
    UBloxCfg('MSGOUT-NMEA_ID_VLW_SPI', 0x209100eb, 'U1'),
    UBloxCfg('MSGOUT-NMEA_ID_VLW_UART1', 0x209100e8, 'U1'),
    UBloxCfg('MSGOUT-NMEA_ID_VTG_I2C', 0x209100b0, 'U1'),
    UBloxCfg('MSGOUT-NMEA_ID_VTG_SPI', 0x209100b4, 'U1'),
    UBloxCfg('MSGOUT-NMEA_ID_VTG_UART1', 0x209100b1, 'U1'),
    UBloxCfg('MSGOUT-NMEA_ID_VTG_UART2', 0x209100b2, 'U1'),
    UBloxCfg('MSGOUT-NMEA_ID_VTG_USB', 0x209100b3, 'U1'),
    UBloxCfg('MSGOUT-NMEA_ID_ZDA_I2C', 0x209100d8, 'U1'),
    UBloxCfg('MSGOUT-NMEA_ID_ZDA_SPI', 0x209100dc, 'U1'),
    UBloxCfg('MSGOUT-NMEA_ID_ZDA_UART1', 0x209100d9, 'U1'),
    UBloxCfg('MSGOUT-NMEA_ID_ZDA_UART2', 0x209100da, 'U1'),
    UBloxCfg('MSGOUT-NMEA_ID_ZDA_USB', 0x209100db, 'U1'),
    UBloxCfg('MSGOUT-NMEA_NAV2_ID_GGA_I2C', 0x20910661, 'U1'),
    UBloxCfg('MSGOUT-NMEA_NAV2_ID_GGA_SPI', 0x20910665, 'U1'),
    UBloxCfg('MSGOUT-NMEA_NAV2_ID_GGA_UART1', 0x20910662, 'U1'),
    UBloxCfg('MSGOUT-NMEA_NAV2_ID_GGA_UART2', 0x20910663, 'U1'),
    UBloxCfg('MSGOUT-NMEA_NAV2_ID_GGA_USB', 0x20910664, 'U1'),
    UBloxCfg('MSGOUT-NMEA_NAV2_ID_GLL_I2C', 0x20910670, 'U1'),
    UBloxCfg('MSGOUT-NMEA_NAV2_ID_GLL_SPI', 0x20910674, 'U1'),
    UBloxCfg('MSGOUT-NMEA_NAV2_ID_GLL_UART1', 0x20910671, 'U1'),
    UBloxCfg('MSGOUT-NMEA_NAV2_ID_GLL_UART2', 0x20910672, 'U1'),
    UBloxCfg('MSGOUT-NMEA_NAV2_ID_GLL_USB', 0x20910673, 'U1'),
    UBloxCfg('MSGOUT-NMEA_NAV2_ID_GNS_I2C', 0x2091065c, 'U1'),
    UBloxCfg('MSGOUT-NMEA_NAV2_ID_GNS_SPI', 0x20910660, 'U1'),
    UBloxCfg('MSGOUT-NMEA_NAV2_ID_GNS_UART1', 0x2091065d, 'U1'),
    UBloxCfg('MSGOUT-NMEA_NAV2_ID_GNS_UART2', 0x2091065e, 'U1'),
    UBloxCfg('MSGOUT-NMEA_NAV2_ID_GNS_USB', 0x2091065f, 'U1'),
    UBloxCfg('MSGOUT-NMEA_NAV2_ID_GSA_I2C', 0x20910666, 'U1'),
    UBloxCfg('MSGOUT-NMEA_NAV2_ID_GSA_SPI', 0x2091066a, 'U1'),
    UBloxCfg('MSGOUT-NMEA_NAV2_ID_GSA_UART1', 0x20910667, 'U1'),
    UBloxCfg('MSGOUT-NMEA_NAV2_ID_GSA_UART2', 0x20910668, 'U1'),
    UBloxCfg('MSGOUT-NMEA_NAV2_ID_GSA_USB', 0x20910669, 'U1'),
    UBloxCfg('MSGOUT-NMEA_NAV2_ID_RMC_I2C', 0x20910652, 'U1'),
    UBloxCfg('MSGOUT-NMEA_NAV2_ID_RMC_SPI', 0x20910656, 'U1'),
    UBloxCfg('MSGOUT-NMEA_NAV2_ID_RMC_UART1', 0x20910653, 'U1'),
    UBloxCfg('MSGOUT-NMEA_NAV2_ID_RMC_UART2', 0x20910654, 'U1'),
    UBloxCfg('MSGOUT-NMEA_NAV2_ID_RMC_USB', 0x20910655, 'U1'),
    UBloxCfg('MSGOUT-NMEA_NAV2_ID_VTG_I2C', 0x20910657, 'U1'),
    UBloxCfg('MSGOUT-NMEA_NAV2_ID_VTG_SPI', 0x2091065b, 'U1'),
    UBloxCfg('MSGOUT-NMEA_NAV2_ID_VTG_UART1', 0x20910658, 'U1'),
    UBloxCfg('MSGOUT-NMEA_NAV2_ID_VTG_UART2', 0x20910659, 'U1'),
    UBloxCfg('MSGOUT-NMEA_NAV2_ID_VTG_USB', 0x2091065a, 'U1'),
    UBloxCfg('MSGOUT-NMEA_NAV2_ID_ZDA_I2C', 0x2091067f, 'U1'),
    UBloxCfg('MSGOUT-NMEA_NAV2_ID_ZDA_SPI', 0x20910683, 'U1'),
    UBloxCfg('MSGOUT-NMEA_NAV2_ID_ZDA_UART1', 0x20910680, 'U1'),
    UBloxCfg('MSGOUT-NMEA_NAV2_ID_ZDA_UART2', 0x20910681, 'U1'),
    UBloxCfg('MSGOUT-NMEA_NAV2_ID_ZDA_USB', 0x20910682, 'U1'),
    UBloxCfg('MSGOUT-PUBX_ID_POLYP_I2C', 0x209100ec, 'U1'),
    UBloxCfg('MSGOUT-PUBX_ID_POLYP_SPI', 0x209100f0, 'U1'),
    UBloxCfg('MSGOUT-PUBX_ID_POLYP_UART1', 0x209100ed, 'U1'),
    UBloxCfg('MSGOUT-PUBX_ID_POLYP_UART2', 0x209100ee, 'U1'),
    UBloxCfg('MSGOUT-PUBX_ID_POLYP_USB', 0x209100ef, 'U1'),
    UBloxCfg('MSGOUT-PUBX_ID_POLYS_I2C', 0x209100f1, 'U1'),
    UBloxCfg('MSGOUT-PUBX_ID_POLYS_SPI', 0x209100f5, 'U1'),
    UBloxCfg('MSGOUT-PUBX_ID_POLYS_UART1', 0x209100f2, 'U1'),
    UBloxCfg('MSGOUT-PUBX_ID_POLYS_UART2', 0x209100f3, 'U1'),
    UBloxCfg('MSGOUT-PUBX_ID_POLYS_USB', 0x209100f4, 'U1'),
    UBloxCfg('MSGOUT-PUBX_ID_POLYT_I2C', 0x209100f6, 'U1'),
    UBloxCfg('MSGOUT-PUBX_ID_POLYT_SPI', 0x209100fa, 'U1'),
    UBloxCfg('MSGOUT-PUBX_ID_POLYT_UART1', 0x209100f7, 'U1'),
    UBloxCfg('MSGOUT-PUBX_ID_POLYT_UART2', 0x209100f8, 'U1'),
    UBloxCfg('MSGOUT-PUBX_ID_POLYT_USB', 0x209100f9, 'U1'),
    UBloxCfg('MSGOUT-RTCM_3X_TYPE1005_I2C', 0x209102bd, 'U1'),
    UBloxCfg('MSGOUT-RTCM_3X_TYPE1005_SPI', 0x209102c1, 'U1'),
    UBloxCfg('MSGOUT-RTCM_3X_TYPE1005_UART1', 0x209102be, 'U1'),
    UBloxCfg('MSGOUT-RTCM_3X_TYPE1005_UART2', 0x209102bf, 'U1'),
    UBloxCfg('MSGOUT-RTCM_3X_TYPE1005_USB', 0x209102c0, 'U1'),
    UBloxCfg('MSGOUT-RTCM_3X_TYPE1074_I2C', 0x2091035e, 'U1'),
    UBloxCfg('MSGOUT-RTCM_3X_TYPE1074_SPI', 0x20910362, 'U1'),
    UBloxCfg('MSGOUT-RTCM_3X_TYPE1074_UART1', 0x2091035f, 'U1'),
    UBloxCfg('MSGOUT-RTCM_3X_TYPE1074_UART2', 0x20910360, 'U1'),
    UBloxCfg('MSGOUT-RTCM_3X_TYPE1074_USB', 0x20910361, 'U1'),
    UBloxCfg('MSGOUT-RTCM_3X_TYPE1077_I2C', 0x209102cc, 'U1'),
    UBloxCfg('MSGOUT-RTCM_3X_TYPE1077_SPI', 0x209102d0, 'U1'),
    UBloxCfg('MSGOUT-RTCM_3X_TYPE1077_UART1', 0x209102cd, 'U1'),
    UBloxCfg('MSGOUT-RTCM_3X_TYPE1077_UART2', 0x209102ce, 'U1'),
    UBloxCfg('MSGOUT-RTCM_3X_TYPE1077_USB', 0x209102cf, 'U1'),
    UBloxCfg('MSGOUT-RTCM_3X_TYPE1094_I2C', 0x20910368, 'U1'),
    UBloxCfg('MSGOUT-RTCM_3X_TYPE1094_SPI', 0x2091036c, 'U1'),
    UBloxCfg('MSGOUT-RTCM_3X_TYPE1094_UART1', 0x20910369, 'U1'),
    UBloxCfg('MSGOUT-RTCM_3X_TYPE1094_UART2', 0x2091036a, 'U1'),
    UBloxCfg('MSGOUT-RTCM_3X_TYPE1094_USB', 0x2091036b, 'U1'),
    UBloxCfg('MSGOUT-RTCM_3X_TYPE1097_I2C', 0x20910318, 'U1'),
    UBloxCfg('MSGOUT-RTCM_3X_TYPE1097_SPI', 0x2091031c, 'U1'),
    UBloxCfg('MSGOUT-RTCM_3X_TYPE1097_UART1', 0x20910319, 'U1'),
    UBloxCfg('MSGOUT-RTCM_3X_TYPE1097_UART2', 0x2091031a, 'U1'),
    UBloxCfg('MSGOUT-RTCM_3X_TYPE1097_USB', 0x2091031b, 'U1'),
    UBloxCfg('MSGOUT-RTCM_3X_TYPE1124_I2C', 0x2091036d, 'U1'),
    UBloxCfg('MSGOUT-RTCM_3X_TYPE1124_SPI', 0x20910371, 'U1'),
    UBloxCfg('MSGOUT-RTCM_3X_TYPE1124_UART1', 0x2091036e, 'U1'),
    UBloxCfg('MSGOUT-RTCM_3X_TYPE1124_UART2', 0x2091036f, 'U1'),
    UBloxCfg('MSGOUT-RTCM_3X_TYPE1124_USB', 0x20910370, 'U1'),
    UBloxCfg('MSGOUT-RTCM_3X_TYPE1127_I2C', 0x209102d6, 'U1'),
    UBloxCfg('MSGOUT-RTCM_3X_TYPE1127_SPI', 0x209102da, 'U1'),
    UBloxCfg('MSGOUT-RTCM_3X_TYPE1127_UART1', 0x209102d7, 'U1'),
    UBloxCfg('MSGOUT-RTCM_3X_TYPE1127_UART2', 0x209102d8, 'U1'),
    UBloxCfg('MSGOUT-RTCM_3X_TYPE1127_USB', 0x209102d9, 'U1'),
    UBloxCfg('MSGOUT-RTCM_3X_TYPE4072_0_I2C', 0x209102fe, 'U1'),
    UBloxCfg('MSGOUT-RTCM_3X_TYPE4072_0_SPI', 0x20910302, 'U1'),
    UBloxCfg('MSGOUT-RTCM_3X_TYPE4072_0_UART1', 0x209102ff, 'U1'),
    UBloxCfg('MSGOUT-RTCM_3X_TYPE4072_0_UART2', 0x20910300, 'U1'),
    UBloxCfg('MSGOUT-RTCM_3X_TYPE4072_0_USB', 0x20910301, 'U1'),
    UBloxCfg('MSGOUT-RTCM_3X_TYPE4072_1_I2C', 0x20910381, 'U1'),
    UBloxCfg('MSGOUT-RTCM_3X_TYPE4072_1_SPI', 0x20910385, 'U1'),
    UBloxCfg('MSGOUT-RTCM_3X_TYPE4072_1_UART1', 0x20910382, 'U1'),
    UBloxCfg('MSGOUT-RTCM_3X_TYPE4072_1_UART2', 0x20910383, 'U1'),
    UBloxCfg('MSGOUT-RTCM_3X_TYPE4072_1_USB', 0x20910384, 'U1'),
    UBloxCfg('MSGOUT-UBX_LOG_INFO_I2C', 0x20910259, 'U1'),
    UBloxCfg('MSGOUT-UBX_LOG_INFO_SPI', 0x2091025d, 'U1'),
    UBloxCfg('MSGOUT-UBX_LOG_INFO_UART1', 0x2091025a, 'U1'),
    UBloxCfg('MSGOUT-UBX_MON_COMMS_I2C', 0x2091034f, 'U1'),
    UBloxCfg('MSGOUT-UBX_MON_COMMS_SPI', 0x20910353, 'U1'),
    UBloxCfg('MSGOUT-UBX_MON_COMMS_UART1', 0x20910350, 'U1'),
    UBloxCfg('MSGOUT-UBX_MON_COMMS_UART2', 0x20910351, 'U1'),
    UBloxCfg('MSGOUT-UBX_MON_COMMS_USB', 0x20910352, 'U1'),
    UBloxCfg('MSGOUT-UBX_MON_HW2_I2C', 0x209101b9, 'U1'),
    UBloxCfg('MSGOUT-UBX_MON_HW2_SPI', 0x209101bd, 'U1'),
    UBloxCfg('MSGOUT-UBX_MON_HW2_UART1', 0x209101ba, 'U1'),
    UBloxCfg('MSGOUT-UBX_MON_HW2_UART2', 0x209101bb, 'U1'),
    UBloxCfg('MSGOUT-UBX_MON_HW2_USB', 0x209101bc, 'U1'),
    UBloxCfg('MSGOUT-UBX_MON_HW3_I2C', 0x20910354, 'U1'),
    UBloxCfg('MSGOUT-UBX_MON_HW3_SPI', 0x20910358, 'U1'),
    UBloxCfg('MSGOUT-UBX_MON_HW3_UART1', 0x20910355, 'U1'),
    UBloxCfg('MSGOUT-UBX_MON_HW3_UART2', 0x20910356, 'U1'),
    UBloxCfg('MSGOUT-UBX_MON_HW3_USB', 0x20910357, 'U1'),
    UBloxCfg('MSGOUT-UBX_MON_HW_I2C', 0x209101b4, 'U1'),
    UBloxCfg('MSGOUT-UBX_MON_HW_SPI', 0x209101b8, 'U1'),
    UBloxCfg('MSGOUT-UBX_MON_HW_UART1', 0x209101b5, 'U1'),
    UBloxCfg('MSGOUT-UBX_MON_HW_UART2', 0x209101b6, 'U1'),
    UBloxCfg('MSGOUT-UBX_MON_HW_USB', 0x209101b7, 'U1'),
    UBloxCfg('MSGOUT-UBX_MON_IO_I2C', 0x209101a5, 'U1'),
    UBloxCfg('MSGOUT-UBX_MON_IO_SPI', 0x209101a9, 'U1'),
    UBloxCfg('MSGOUT-UBX_MON_IO_UART1', 0x209101a6, 'U1'),
    UBloxCfg('MSGOUT-UBX_MON_IO_UART2', 0x209101a7, 'U1'),
    UBloxCfg('MSGOUT-UBX_MON_IO_USB', 0x209101a8, 'U1'),
    UBloxCfg('MSGOUT-UBX_MON_MSGPP_I2C', 0x20910196, 'U1'),
    UBloxCfg('MSGOUT-UBX_MON_MSGPP_SPI', 0x2091019a, 'U1'),
    UBloxCfg('MSGOUT-UBX_MON_MSGPP_UART1', 0x20910197, 'U1'),
    UBloxCfg('MSGOUT-UBX_MON_MSGPP_UART2', 0x20910198, 'U1'),
    UBloxCfg('MSGOUT-UBX_MON_MSGPP_USB', 0x20910199, 'U1'),
    UBloxCfg('MSGOUT-UBX_MON_RF_I2C', 0x20910359, 'U1'),
    UBloxCfg('MSGOUT-UBX_MON_RF_SPI', 0x2091035d, 'U1'),
    UBloxCfg('MSGOUT-UBX_MON_RF_UART1', 0x2091035a, 'U1'),
    UBloxCfg('MSGOUT-UBX_MON_RF_UART2', 0x2091035b, 'U1'),
    UBloxCfg('MSGOUT-UBX_MON_RF_USB', 0x2091035c, 'U1'),
    UBloxCfg('MSGOUT-UBX_MON_RXBUF_I2C', 0x209101a0, 'U1'),
    UBloxCfg('MSGOUT-UBX_MON_RXBUF_SPI', 0x209101a4, 'U1'),
    UBloxCfg('MSGOUT-UBX_MON_RXBUF_UART1', 0x209101a1, 'U1'),
    UBloxCfg('MSGOUT-UBX_MON_RXBUF_UART2', 0x209101a2, 'U1'),
    UBloxCfg('MSGOUT-UBX_MON_RXBUF_USB', 0x209101a3, 'U1'),
    UBloxCfg('MSGOUT-UBX_MON_RXR_I2C', 0x20910187, 'U1'),
    UBloxCfg('MSGOUT-UBX_MON_RXR_SPI', 0x2091018b, 'U1'),
    UBloxCfg('MSGOUT-UBX_MON_RXR_UART1', 0x20910188, 'U1'),
    UBloxCfg('MSGOUT-UBX_MON_RXR_UART2', 0x20910189, 'U1'),
    UBloxCfg('MSGOUT-UBX_MON_RXR_USB', 0x2091018a, 'U1'),
    UBloxCfg('MSGOUT-UBX_MON_SPAN_I2C', 0x2091038b, 'U1'),
    UBloxCfg('MSGOUT-UBX_MON_SPAN_SPI', 0x2091038f, 'U1'),
    UBloxCfg('MSGOUT-UBX_MON_SPAN_UART1', 0x2091038c, 'U1'),
    UBloxCfg('MSGOUT-UBX_MON_SPAN_UART2', 0x2091038d, 'U1'),
    UBloxCfg('MSGOUT-UBX_MON_SPAN_USB', 0x2091038e, 'U1'),
    UBloxCfg('MSGOUT-UBX_MON_SYS_I2C', 0x2091069d, 'U1'),
    UBloxCfg('MSGOUT-UBX_MON_SYS_SPI', 0x209106a1, 'U1'),
    UBloxCfg('MSGOUT-UBX_MON_SYS_UART1', 0x2091069e, 'U1'),
    UBloxCfg('MSGOUT-UBX_MON_SYS_UART2', 0x2091069f, 'U1'),
    UBloxCfg('MSGOUT-UBX_MON_SYS_USB', 0x209106a0, 'U1'),
    UBloxCfg('MSGOUT-UBX_MON_TXBUF_I2C', 0x2091019b, 'U1'),
    UBloxCfg('MSGOUT-UBX_MON_TXBUF_SPI', 0x2091019f, 'U1'),
    UBloxCfg('MSGOUT-UBX_MON_TXBUF_UART1', 0x2091019c, 'U1'),
    UBloxCfg('MSGOUT-UBX_MON_TXBUF_UART2', 0x2091019d, 'U1'),
    UBloxCfg('MSGOUT-UBX_MON_TXBUF_USB', 0x2091019e, 'U1'),
    UBloxCfg('MSGOUT-UBX_NAV2_CLOCK_I2C', 0x20910430, 'U1'),
    UBloxCfg('MSGOUT-UBX_NAV2_CLOCK_SPI', 0x20910434, 'U1'),
    UBloxCfg('MSGOUT-UBX_NAV2_CLOCK_UART1', 0x20910431, 'U1'),
    UBloxCfg('MSGOUT-UBX_NAV2_CLOCK_UART2', 0x20910432, 'U1'),
    UBloxCfg('MSGOUT-UBX_NAV2_CLOCK_USB', 0x20910433, 'U1'),
    UBloxCfg('MSGOUT-UBX_NAV2_COV_I2C', 0x20910435, 'U1'),
    UBloxCfg('MSGOUT-UBX_NAV2_COV_SPI', 0x20910439, 'U1'),
    UBloxCfg('MSGOUT-UBX_NAV2_COV_UART1', 0x20910436, 'U1'),
    UBloxCfg('MSGOUT-UBX_NAV2_COV_UART2', 0x20910437, 'U1'),
    UBloxCfg('MSGOUT-UBX_NAV2_COV_USB', 0x20910438, 'U1'),
    UBloxCfg('MSGOUT-UBX_NAV2_DOP_I2C', 0x20910465, 'U1'),
    UBloxCfg('MSGOUT-UBX_NAV2_DOP_SPI', 0x20910469, 'U1'),
    UBloxCfg('MSGOUT-UBX_NAV2_DOP_UART1', 0x20910466, 'U1'),
    UBloxCfg('MSGOUT-UBX_NAV2_DOP_UART2', 0x20910467, 'U1'),
    UBloxCfg('MSGOUT-UBX_NAV2_DOP_USB', 0x20910468, 'U1'),
    UBloxCfg('MSGOUT-UBX_NAV2_EOE_I2C', 0x20910565, 'U1'),
    UBloxCfg('MSGOUT-UBX_NAV2_EOE_SPI', 0x20910569, 'U1'),
    UBloxCfg('MSGOUT-UBX_NAV2_EOE_UART1', 0x20910566, 'U1'),
    UBloxCfg('MSGOUT-UBX_NAV2_EOE_UART2', 0x20910567, 'U1'),
    UBloxCfg('MSGOUT-UBX_NAV2_EOE_USB', 0x20910568, 'U1'),
    UBloxCfg('MSGOUT-UBX_NAV2_POSECEF_I2C', 0x20910480, 'U1'),
    UBloxCfg('MSGOUT-UBX_NAV2_POSECEF_SPI', 0x20910484, 'U1'),
    UBloxCfg('MSGOUT-UBX_NAV2_POSECEF_UART1', 0x20910481, 'U1'),
    UBloxCfg('MSGOUT-UBX_NAV2_POSECEF_UART2', 0x20910482, 'U1'),
    UBloxCfg('MSGOUT-UBX_NAV2_POSECEF_USB', 0x20910483, 'U1'),
    UBloxCfg('MSGOUT-UBX_NAV2_POSLLH_I2C', 0x20910485, 'U1'),
    UBloxCfg('MSGOUT-UBX_NAV2_POSLLH_SPI', 0x20910489, 'U1'),
    UBloxCfg('MSGOUT-UBX_NAV2_POSLLH_UART1', 0x20910486, 'U1'),
    UBloxCfg('MSGOUT-UBX_NAV2_POSLLH_UART2', 0x20910487, 'U1'),
    UBloxCfg('MSGOUT-UBX_NAV2_POSLLH_USB', 0x20910488, 'U1'),
    UBloxCfg('MSGOUT-UBX_NAV2_PVT_I2C', 0x20910490, 'U1'),
    UBloxCfg('MSGOUT-UBX_NAV2_PVT_SPI', 0x20910494, 'U1'),
    UBloxCfg('MSGOUT-UBX_NAV2_PVT_UART1', 0x20910491, 'U1'),
    UBloxCfg('MSGOUT-UBX_NAV2_PVT_UART2', 0x20910492, 'U1'),
    UBloxCfg('MSGOUT-UBX_NAV2_PVT_USB', 0x20910493, 'U1'),
    UBloxCfg('MSGOUT-UBX_NAV2_SAT_I2C', 0x20910495, 'U1'),
    UBloxCfg('MSGOUT-UBX_NAV2_SAT_SPI', 0x20910499, 'U1'),
    UBloxCfg('MSGOUT-UBX_NAV2_SAT_UART1', 0x20910496, 'U1'),
    UBloxCfg('MSGOUT-UBX_NAV2_SAT_UART2', 0x20910497, 'U1'),
    UBloxCfg('MSGOUT-UBX_NAV2_SAT_USB', 0x20910498, 'U1'),
    UBloxCfg('MSGOUT-UBX_NAV2_SBAS_I2C', 0x20910500, 'U1'),
    UBloxCfg('MSGOUT-UBX_NAV2_SBAS_SPI', 0x20910504, 'U1'),
    UBloxCfg('MSGOUT-UBX_NAV2_SBAS_UART1', 0x20910501, 'U1'),
    UBloxCfg('MSGOUT-UBX_NAV2_SBAS_UART2', 0x20910502, 'U1'),
    UBloxCfg('MSGOUT-UBX_NAV2_SBAS_USB', 0x20910503, 'U1'),
    UBloxCfg('MSGOUT-UBX_NAV2_SIG_I2C', 0x20910505, 'U1'),
    UBloxCfg('MSGOUT-UBX_NAV2_SIG_SPI', 0x20910509, 'U1'),
    UBloxCfg('MSGOUT-UBX_NAV2_SIG_UART1', 0x20910506, 'U1'),
    UBloxCfg('MSGOUT-UBX_NAV2_SIG_UART2', 0x20910507, 'U1'),
    UBloxCfg('MSGOUT-UBX_NAV2_SIG_USB', 0x20910508, 'U1'),
    UBloxCfg('MSGOUT-UBX_NAV2_STATUS_I2C', 0x20910515, 'U1'),
    UBloxCfg('MSGOUT-UBX_NAV2_STATUS_SPI', 0x20910519, 'U1'),
    UBloxCfg('MSGOUT-UBX_NAV2_STATUS_UART1', 0x20910516, 'U1'),
    UBloxCfg('MSGOUT-UBX_NAV2_STATUS_UART2', 0x20910517, 'U1'),
    UBloxCfg('MSGOUT-UBX_NAV2_STATUS_USB', 0x20910518, 'U1'),
    UBloxCfg('MSGOUT-UBX_NAV2_TIMEBDS_I2C', 0x20910525, 'U1'),
    UBloxCfg('MSGOUT-UBX_NAV2_TIMEBDS_SPI', 0x20910529, 'U1'),
    UBloxCfg('MSGOUT-UBX_NAV2_TIMEBDS_UART1', 0x20910526, 'U1'),
    UBloxCfg('MSGOUT-UBX_NAV2_TIMEBDS_UART2', 0x20910527, 'U1'),
    UBloxCfg('MSGOUT-UBX_NAV2_TIMEBDS_USB', 0x20910528, 'U1'),
    UBloxCfg('MSGOUT-UBX_NAV2_TIMEGAL_I2C', 0x20910530, 'U1'),
    UBloxCfg('MSGOUT-UBX_NAV2_TIMEGAL_SPI', 0x20910534, 'U1'),
    UBloxCfg('MSGOUT-UBX_NAV2_TIMEGAL_UART1', 0x20910531, 'U1'),
    UBloxCfg('MSGOUT-UBX_NAV2_TIMEGAL_UART2', 0x20910532, 'U1'),
    UBloxCfg('MSGOUT-UBX_NAV2_TIMEGAL_USB', 0x20910533, 'U1'),
    UBloxCfg('MSGOUT-UBX_NAV2_TIMEGPS_I2C', 0x20910540, 'U1'),
    UBloxCfg('MSGOUT-UBX_NAV2_TIMEGPS_SPI', 0x20910544, 'U1'),
    UBloxCfg('MSGOUT-UBX_NAV2_TIMEGPS_UART1', 0x20910541, 'U1'),
    UBloxCfg('MSGOUT-UBX_NAV2_TIMEGPS_UART2', 0x20910542, 'U1'),
    UBloxCfg('MSGOUT-UBX_NAV2_TIMEGPS_USB', 0x20910543, 'U1'),
    UBloxCfg('MSGOUT-UBX_NAV2_TIMELS_I2C', 0x20910545, 'U1'),
    UBloxCfg('MSGOUT-UBX_NAV2_TIMELS_SPI', 0x20910549, 'U1'),
    UBloxCfg('MSGOUT-UBX_NAV2_TIMELS_UART1', 0x20910546, 'U1'),
    UBloxCfg('MSGOUT-UBX_NAV2_TIMELS_UART2', 0x20910547, 'U1'),
    UBloxCfg('MSGOUT-UBX_NAV2_TIMELS_USB', 0x20910548, 'U1'),
    UBloxCfg('MSGOUT-UBX_NAV2_TIMENAVIC_I2C', 0x209106a7, 'U1'),
    UBloxCfg('MSGOUT-UBX_NAV2_TIMENAVIC_SPI', 0x209106ab, 'U1'),
    UBloxCfg('MSGOUT-UBX_NAV2_TIMENAVIC_UART1', 0x209106a8, 'U1'),
    UBloxCfg('MSGOUT-UBX_NAV2_TIMENAVIC_UART2', 0x209106a9, 'U1'),
    UBloxCfg('MSGOUT-UBX_NAV2_TIMENAVIC_USB', 0x209106aa, 'U1'),
    UBloxCfg('MSGOUT-UBX_NAV2_TIMEQZSS_I2C', 0x20910575, 'U1'),
    UBloxCfg('MSGOUT-UBX_NAV2_TIMEQZSS_SPI', 0x20910579, 'U1'),
    UBloxCfg('MSGOUT-UBX_NAV2_TIMEQZSS_UART1', 0x20910576, 'U1'),
    UBloxCfg('MSGOUT-UBX_NAV2_TIMEQZSS_UART2', 0x20910577, 'U1'),
    UBloxCfg('MSGOUT-UBX_NAV2_TIMEQZSS_USB', 0x20910578, 'U1'),
    UBloxCfg('MSGOUT-UBX_NAV2_TIMEUTC_I2C', 0x20910550, 'U1'),
    UBloxCfg('MSGOUT-UBX_NAV2_TIMEUTC_SPI', 0x20910554, 'U1'),
    UBloxCfg('MSGOUT-UBX_NAV2_TIMEUTC_UART1', 0x20910551, 'U1'),
    UBloxCfg('MSGOUT-UBX_NAV2_TIMEUTC_UART2', 0x20910552, 'U1'),
    UBloxCfg('MSGOUT-UBX_NAV2_TIMEUTC_USB', 0x20910553, 'U1'),
    UBloxCfg('MSGOUT-UBX_NAV2_VELECEF_I2C', 0x20910555, 'U1'),
    UBloxCfg('MSGOUT-UBX_NAV2_VELECEF_SPI', 0x20910559, 'U1'),
    UBloxCfg('MSGOUT-UBX_NAV2_VELECEF_UART1', 0x20910556, 'U1'),
    UBloxCfg('MSGOUT-UBX_NAV2_VELECEF_UART2', 0x20910557, 'U1'),
    UBloxCfg('MSGOUT-UBX_NAV2_VELECEF_USB', 0x20910558, 'U1'),
    UBloxCfg('MSGOUT-UBX_NAV2_VELNED_I2C', 0x20910560, 'U1'),
    UBloxCfg('MSGOUT-UBX_NAV2_VELNED_SPI', 0x20910564, 'U1'),
    UBloxCfg('MSGOUT-UBX_NAV2_VELNED_UART1', 0x20910561, 'U1'),
    UBloxCfg('MSGOUT-UBX_NAV2_VELNED_UART2', 0x20910562, 'U1'),
    UBloxCfg('MSGOUT-UBX_NAV2_VELNED_USB', 0x20910563, 'U1'),
    UBloxCfg('MSGOUT-UBX_NAV_AOPSTATUS_I2C', 0x20910079, 'U1'),
    UBloxCfg('MSGOUT-UBX_NAV_AOPSTATUS_SPI', 0x2091007d, 'U1'),
    UBloxCfg('MSGOUT-UBX_NAV_AOPSTATUS_UART1', 0x2091007a, 'U1'),
    UBloxCfg('MSGOUT-UBX_NAV_CLOCK_I2C', 0x20910065, 'U1'),
    UBloxCfg('MSGOUT-UBX_NAV_CLOCK_SPI', 0x20910069, 'U1'),
    UBloxCfg('MSGOUT-UBX_NAV_CLOCK_UART1', 0x20910066, 'U1'),
    UBloxCfg('MSGOUT-UBX_NAV_CLOCK_UART2', 0x20910067, 'U1'),
    UBloxCfg('MSGOUT-UBX_NAV_CLOCK_USB', 0x20910068, 'U1'),
    UBloxCfg('MSGOUT-UBX_NAV_COV_I2C', 0x20910083, 'U1'),
    UBloxCfg('MSGOUT-UBX_NAV_COV_SPI', 0x20910087, 'U1'),
    UBloxCfg('MSGOUT-UBX_NAV_COV_UART1', 0x20910084, 'U1'),
    UBloxCfg('MSGOUT-UBX_NAV_COV_UART2', 0x20910085, 'U1'),
    UBloxCfg('MSGOUT-UBX_NAV_COV_USB', 0x20910086, 'U1'),
    UBloxCfg('MSGOUT-UBX_NAV_DOP_I2C', 0x20910038, 'U1'),
    UBloxCfg('MSGOUT-UBX_NAV_DOP_SPI', 0x2091003c, 'U1'),
    UBloxCfg('MSGOUT-UBX_NAV_DOP_UART1', 0x20910039, 'U1'),
    UBloxCfg('MSGOUT-UBX_NAV_DOP_UART2', 0x2091003a, 'U1'),
    UBloxCfg('MSGOUT-UBX_NAV_DOP_USB', 0x2091003b, 'U1'),
    UBloxCfg('MSGOUT-UBX_NAV_EOE_I2C', 0x2091015f, 'U1'),
    UBloxCfg('MSGOUT-UBX_NAV_EOE_SPI', 0x20910163, 'U1'),
    UBloxCfg('MSGOUT-UBX_NAV_EOE_UART1', 0x20910160, 'U1'),
    UBloxCfg('MSGOUT-UBX_NAV_EOE_UART2', 0x20910161, 'U1'),
    UBloxCfg('MSGOUT-UBX_NAV_EOE_USB', 0x20910162, 'U1'),
    UBloxCfg('MSGOUT-UBX_NAV_GEOFENCE_I2C', 0x209100a1, 'U1'),
    UBloxCfg('MSGOUT-UBX_NAV_GEOFENCE_SPI', 0x209100a5, 'U1'),
    UBloxCfg('MSGOUT-UBX_NAV_GEOFENCE_UART1', 0x209100a2, 'U1'),
    UBloxCfg('MSGOUT-UBX_NAV_NMI_I2C', 0x20910590, 'U1'),
    UBloxCfg('MSGOUT-UBX_NAV_NMI_SPI', 0x20910594, 'U1'),
    UBloxCfg('MSGOUT-UBX_NAV_NMI_UART1', 0x20910591, 'U1'),
    UBloxCfg('MSGOUT-UBX_NAV_NMI_UART2', 0x20910592, 'U1'),
    UBloxCfg('MSGOUT-UBX_NAV_NMI_USB', 0x20910593, 'U1'),
    UBloxCfg('MSGOUT-UBX_NAV_ODO_I2C', 0x2091007e, 'U1'),
    UBloxCfg('MSGOUT-UBX_NAV_ODO_SPI', 0x20910082, 'U1'),
    UBloxCfg('MSGOUT-UBX_NAV_ODO_UART1', 0x2091007f, 'U1'),
    UBloxCfg('MSGOUT-UBX_NAV_ORB_I2C', 0x20910010, 'U1'),
    UBloxCfg('MSGOUT-UBX_NAV_ORB_SPI', 0x20910014, 'U1'),
    UBloxCfg('MSGOUT-UBX_NAV_ORB_UART1', 0x20910011, 'U1'),
    UBloxCfg('MSGOUT-UBX_NAV_ORB_UART2', 0x20910012, 'U1'),
    UBloxCfg('MSGOUT-UBX_NAV_ORB_USB', 0x20910013, 'U1'),
    UBloxCfg('MSGOUT-UBX_NAV_PL_I2C', 0x20910415, 'U1'),
    UBloxCfg('MSGOUT-UBX_NAV_PL_SPI', 0x20910419, 'U1'),
    UBloxCfg('MSGOUT-UBX_NAV_PL_UART1', 0x20910416, 'U1'),
    UBloxCfg('MSGOUT-UBX_NAV_POSECEF_I2C', 0x20910024, 'U1'),
    UBloxCfg('MSGOUT-UBX_NAV_POSECEF_SPI', 0x20910028, 'U1'),
    UBloxCfg('MSGOUT-UBX_NAV_POSECEF_UART1', 0x20910025, 'U1'),
    UBloxCfg('MSGOUT-UBX_NAV_POSECEF_UART2', 0x20910026, 'U1'),
    UBloxCfg('MSGOUT-UBX_NAV_POSECEF_USB', 0x20910027, 'U1'),
    UBloxCfg('MSGOUT-UBX_NAV_POSLLH_I2C', 0x20910029, 'U1'),
    UBloxCfg('MSGOUT-UBX_NAV_POSLLH_SPI', 0x2091002d, 'U1'),
    UBloxCfg('MSGOUT-UBX_NAV_POSLLH_UART1', 0x2091002a, 'U1'),
    UBloxCfg('MSGOUT-UBX_NAV_POSLLH_UART2', 0x2091002b, 'U1'),
    UBloxCfg('MSGOUT-UBX_NAV_POSLLH_USB', 0x2091002c, 'U1'),
    UBloxCfg('MSGOUT-UBX_NAV_PVT_I2C', 0x20910006, 'U1'),
    UBloxCfg('MSGOUT-UBX_NAV_PVT_SPI', 0x2091000a, 'U1'),
    UBloxCfg('MSGOUT-UBX_NAV_PVT_UART1', 0x20910007, 'U1'),
    UBloxCfg('MSGOUT-UBX_NAV_PVT_UART2', 0x20910008, 'U1'),
    UBloxCfg('MSGOUT-UBX_NAV_PVT_USB', 0x20910009, 'U1'),
    UBloxCfg('MSGOUT-UBX_NAV_SAT_I2C', 0x20910015, 'U1'),
    UBloxCfg('MSGOUT-UBX_NAV_SAT_SPI', 0x20910019, 'U1'),
    UBloxCfg('MSGOUT-UBX_NAV_SAT_UART1', 0x20910016, 'U1'),
    UBloxCfg('MSGOUT-UBX_NAV_SAT_UART2', 0x20910017, 'U1'),
    UBloxCfg('MSGOUT-UBX_NAV_SAT_USB', 0x20910018, 'U1'),
    UBloxCfg('MSGOUT-UBX_NAV_SBAS_I2C', 0x2091006a, 'U1'),
    UBloxCfg('MSGOUT-UBX_NAV_SBAS_SPI', 0x2091006e, 'U1'),
    UBloxCfg('MSGOUT-UBX_NAV_SBAS_UART1', 0x2091006b, 'U1'),
    UBloxCfg('MSGOUT-UBX_NAV_SBAS_UART2', 0x2091006c, 'U1'),
    UBloxCfg('MSGOUT-UBX_NAV_SBAS_USB', 0x2091006d, 'U1'),
    UBloxCfg('MSGOUT-UBX_NAV_SIG_I2C', 0x20910345, 'U1'),
    UBloxCfg('MSGOUT-UBX_NAV_SIG_SPI', 0x20910349, 'U1'),
    UBloxCfg('MSGOUT-UBX_NAV_SIG_UART1', 0x20910346, 'U1'),
    UBloxCfg('MSGOUT-UBX_NAV_SIG_UART2', 0x20910347, 'U1'),
    UBloxCfg('MSGOUT-UBX_NAV_SIG_USB', 0x20910348, 'U1'),
    UBloxCfg('MSGOUT-UBX_NAV_SLAS_I2C', 0x20910336, 'U1'),
    UBloxCfg('MSGOUT-UBX_NAV_SLAS_SPI', 0x2091033a, 'U1'),
    UBloxCfg('MSGOUT-UBX_NAV_SLAS_UART1', 0x20910337, 'U1'),
    UBloxCfg('MSGOUT-UBX_NAV_STATUS_I2C', 0x2091001a, 'U1'),
    UBloxCfg('MSGOUT-UBX_NAV_STATUS_SPI', 0x2091001e, 'U1'),
    UBloxCfg('MSGOUT-UBX_NAV_STATUS_UART1', 0x2091001b, 'U1'),
    UBloxCfg('MSGOUT-UBX_NAV_STATUS_UART2', 0x2091001c, 'U1'),
    UBloxCfg('MSGOUT-UBX_NAV_STATUS_USB', 0x2091001d, 'U1'),
    UBloxCfg('MSGOUT-UBX_NAV_TIMEBDS_I2C', 0x20910051, 'U1'),
    UBloxCfg('MSGOUT-UBX_NAV_TIMEBDS_SPI', 0x20910055, 'U1'),
    UBloxCfg('MSGOUT-UBX_NAV_TIMEBDS_UART1', 0x20910052, 'U1'),
    UBloxCfg('MSGOUT-UBX_NAV_TIMEBDS_UART2', 0x20910053, 'U1'),
    UBloxCfg('MSGOUT-UBX_NAV_TIMEBDS_USB', 0x20910054, 'U1'),
    UBloxCfg('MSGOUT-UBX_NAV_TIMEGAL_I2C', 0x20910056, 'U1'),
    UBloxCfg('MSGOUT-UBX_NAV_TIMEGAL_SPI', 0x2091005a, 'U1'),
    UBloxCfg('MSGOUT-UBX_NAV_TIMEGAL_UART1', 0x20910057, 'U1'),
    UBloxCfg('MSGOUT-UBX_NAV_TIMEGAL_UART2', 0x20910058, 'U1'),
    UBloxCfg('MSGOUT-UBX_NAV_TIMEGAL_USB', 0x20910059, 'U1'),
    UBloxCfg('MSGOUT-UBX_NAV_TIMEGLO_I2C', 0x2091004c, 'U1'),
    UBloxCfg('MSGOUT-UBX_NAV_TIMEGLO_SPI', 0x20910050, 'U1'),
    UBloxCfg('MSGOUT-UBX_NAV_TIMEGLO_UART1', 0x2091004d, 'U1'),
    UBloxCfg('MSGOUT-UBX_NAV_TIMEGPS_I2C', 0x20910047, 'U1'),
    UBloxCfg('MSGOUT-UBX_NAV_TIMEGPS_SPI', 0x2091004b, 'U1'),
    UBloxCfg('MSGOUT-UBX_NAV_TIMEGPS_UART1', 0x20910048, 'U1'),
    UBloxCfg('MSGOUT-UBX_NAV_TIMEGPS_UART2', 0x20910049, 'U1'),
    UBloxCfg('MSGOUT-UBX_NAV_TIMEGPS_USB', 0x2091004a, 'U1'),
    UBloxCfg('MSGOUT-UBX_NAV_TIMELS_I2C', 0x20910060, 'U1'),
    UBloxCfg('MSGOUT-UBX_NAV_TIMELS_SPI', 0x20910064, 'U1'),
    UBloxCfg('MSGOUT-UBX_NAV_TIMELS_UART1', 0x20910061, 'U1'),
    UBloxCfg('MSGOUT-UBX_NAV_TIMELS_UART2', 0x20910062, 'U1'),
    UBloxCfg('MSGOUT-UBX_NAV_TIMELS_USB', 0x20910063, 'U1'),
    UBloxCfg('MSGOUT-UBX_NAV_TIMENAVIC_I2C', 0x209106a2, 'U1'),
    UBloxCfg('MSGOUT-UBX_NAV_TIMENAVIC_SPI', 0x209106a6, 'U1'),
    UBloxCfg('MSGOUT-UBX_NAV_TIMENAVIC_UART1', 0x209106a3, 'U1'),
    UBloxCfg('MSGOUT-UBX_NAV_TIMENAVIC_UART2', 0x209106a4, 'U1'),
    UBloxCfg('MSGOUT-UBX_NAV_TIMENAVIC_USB', 0x209106a5, 'U1'),
    UBloxCfg('MSGOUT-UBX_NAV_TIMEQZSS_I2C', 0x20910386, 'U1'),
    UBloxCfg('MSGOUT-UBX_NAV_TIMEQZSS_SPI', 0x2091038a, 'U1'),
    UBloxCfg('MSGOUT-UBX_NAV_TIMEQZSS_UART1', 0x20910387, 'U1'),
    UBloxCfg('MSGOUT-UBX_NAV_TIMEQZSS_UART2', 0x20910388, 'U1'),
    UBloxCfg('MSGOUT-UBX_NAV_TIMEQZSS_USB', 0x20910389, 'U1'),
    UBloxCfg('MSGOUT-UBX_NAV_TIMETRUSTED_I2C', 0x209103a8, 'U1'),
    UBloxCfg('MSGOUT-UBX_NAV_TIMETRUSTED_SPI', 0x209103ac, 'U1'),
    UBloxCfg('MSGOUT-UBX_NAV_TIMETRUSTED_UART1', 0x209103a9, 'U1'),
    UBloxCfg('MSGOUT-UBX_NAV_TIMETRUSTED_UART2', 0x209103aa, 'U1'),
    UBloxCfg('MSGOUT-UBX_NAV_TIMETRUSTED_USB', 0x209103ab, 'U1'),
    UBloxCfg('MSGOUT-UBX_NAV_TIMEUTC_I2C', 0x2091005b, 'U1'),
    UBloxCfg('MSGOUT-UBX_NAV_TIMEUTC_SPI', 0x2091005f, 'U1'),
    UBloxCfg('MSGOUT-UBX_NAV_TIMEUTC_UART1', 0x2091005c, 'U1'),
    UBloxCfg('MSGOUT-UBX_NAV_TIMEUTC_UART2', 0x2091005d, 'U1'),
    UBloxCfg('MSGOUT-UBX_NAV_TIMEUTC_USB', 0x2091005e, 'U1'),
    UBloxCfg('MSGOUT-UBX_NAV_VELECEF_I2C', 0x2091003d, 'U1'),
    UBloxCfg('MSGOUT-UBX_NAV_VELECEF_SPI', 0x20910041, 'U1'),
    UBloxCfg('MSGOUT-UBX_NAV_VELECEF_UART1', 0x2091003e, 'U1'),
    UBloxCfg('MSGOUT-UBX_NAV_VELECEF_UART2', 0x2091003f, 'U1'),
    UBloxCfg('MSGOUT-UBX_NAV_VELECEF_USB', 0x20910040, 'U1'),
    UBloxCfg('MSGOUT-UBX_NAV_VELNED_I2C', 0x20910042, 'U1'),
    UBloxCfg('MSGOUT-UBX_NAV_VELNED_SPI', 0x20910046, 'U1'),
    UBloxCfg('MSGOUT-UBX_NAV_VELNED_UART1', 0x20910043, 'U1'),
    UBloxCfg('MSGOUT-UBX_NAV_VELNED_UART2', 0x20910044, 'U1'),
    UBloxCfg('MSGOUT-UBX_NAV_VELNED_USB', 0x20910045, 'U1'),
    UBloxCfg('MSGOUT-UBX_RXM_COR_I2C', 0x209106b6, 'U1'),
    UBloxCfg('MSGOUT-UBX_RXM_COR_SPI', 0x209106ba, 'U1'),
    UBloxCfg('MSGOUT-UBX_RXM_COR_UART1', 0x209106b7, 'U1'),
    UBloxCfg('MSGOUT-UBX_RXM_COR_UART2', 0x209106b8, 'U1'),
    UBloxCfg('MSGOUT-UBX_RXM_COR_USB', 0x209106b9, 'U1'),
    UBloxCfg('MSGOUT-UBX_RXM_MEAS20_I2C', 0x20910643, 'U1'),
    UBloxCfg('MSGOUT-UBX_RXM_MEAS20_SPI', 0x20910647, 'U1'),
    UBloxCfg('MSGOUT-UBX_RXM_MEAS20_UART1', 0x20910644, 'U1'),
    UBloxCfg('MSGOUT-UBX_RXM_MEAS50_I2C', 0x20910648, 'U1'),
    UBloxCfg('MSGOUT-UBX_RXM_MEAS50_SPI', 0x2091064c, 'U1'),
    UBloxCfg('MSGOUT-UBX_RXM_MEAS50_UART1', 0x20910649, 'U1'),
    UBloxCfg('MSGOUT-UBX_RXM_MEASC12_I2C', 0x2091063e, 'U1'),
    UBloxCfg('MSGOUT-UBX_RXM_MEASC12_SPI', 0x20910642, 'U1'),
    UBloxCfg('MSGOUT-UBX_RXM_MEASC12_UART1', 0x2091063f, 'U1'),
    UBloxCfg('MSGOUT-UBX_RXM_MEASD12_I2C', 0x20910639, 'U1'),
    UBloxCfg('MSGOUT-UBX_RXM_MEASD12_SPI', 0x2091063d, 'U1'),
    UBloxCfg('MSGOUT-UBX_RXM_MEASD12_UART1', 0x2091063a, 'U1'),
    UBloxCfg('MSGOUT-UBX_RXM_MEASX_I2C', 0x20910204, 'U1'),
    UBloxCfg('MSGOUT-UBX_RXM_MEASX_SPI', 0x20910208, 'U1'),
    UBloxCfg('MSGOUT-UBX_RXM_MEASX_UART1', 0x20910205, 'U1'),
    UBloxCfg('MSGOUT-UBX_RXM_MEASX_UART2', 0x20910206, 'U1'),
    UBloxCfg('MSGOUT-UBX_RXM_MEASX_USB', 0x20910207, 'U1'),
    UBloxCfg('MSGOUT-UBX_RXM_RAWX_I2C', 0x209102a4, 'U1'),
    UBloxCfg('MSGOUT-UBX_RXM_RAWX_SPI', 0x209102a8, 'U1'),
    UBloxCfg('MSGOUT-UBX_RXM_RAWX_UART1', 0x209102a5, 'U1'),
    UBloxCfg('MSGOUT-UBX_RXM_RAWX_UART2', 0x209102a6, 'U1'),
    UBloxCfg('MSGOUT-UBX_RXM_RAWX_USB', 0x209102a7, 'U1'),
    UBloxCfg('MSGOUT-UBX_RXM_RLM_I2C', 0x2091025e, 'U1'),
    UBloxCfg('MSGOUT-UBX_RXM_RLM_SPI', 0x20910262, 'U1'),
    UBloxCfg('MSGOUT-UBX_RXM_RLM_UART1', 0x2091025f, 'U1'),
    UBloxCfg('MSGOUT-UBX_RXM_RLM_UART2', 0x20910260, 'U1'),
    UBloxCfg('MSGOUT-UBX_RXM_RLM_USB', 0x20910261, 'U1'),
    UBloxCfg('MSGOUT-UBX_RXM_RTCM_I2C', 0x20910268, 'U1'),
    UBloxCfg('MSGOUT-UBX_RXM_RTCM_SPI', 0x2091026c, 'U1'),
    UBloxCfg('MSGOUT-UBX_RXM_RTCM_UART1', 0x20910269, 'U1'),
    UBloxCfg('MSGOUT-UBX_RXM_RTCM_UART2', 0x2091026a, 'U1'),
    UBloxCfg('MSGOUT-UBX_RXM_RTCM_USB', 0x2091026b, 'U1'),
    UBloxCfg('MSGOUT-UBX_RXM_SFRBX_I2C', 0x20910231, 'U1'),
    UBloxCfg('MSGOUT-UBX_RXM_SFRBX_SPI', 0x20910235, 'U1'),
    UBloxCfg('MSGOUT-UBX_RXM_SFRBX_UART1', 0x20910232, 'U1'),
    UBloxCfg('MSGOUT-UBX_RXM_SFRBX_UART2', 0x20910233, 'U1'),
    UBloxCfg('MSGOUT-UBX_RXM_SFRBX_USB', 0x20910234, 'U1'),
    UBloxCfg('MSGOUT-UBX_RXM_TM_I2C', 0x20910610, 'U1'),
    UBloxCfg('MSGOUT-UBX_RXM_TM_SPI', 0x20910614, 'U1'),
    UBloxCfg('MSGOUT-UBX_RXM_TM_UART1', 0x20910611, 'U1'),
    UBloxCfg('MSGOUT-UBX_RXM_TM_UART2', 0x20910612, 'U1'),
    UBloxCfg('MSGOUT-UBX_RXM_TM_USB', 0x20910613, 'U1'),
    UBloxCfg('MSGOUT-UBX_SEC_OSNMA_I2C', 0x209106ca, 'U1'),
    UBloxCfg('MSGOUT-UBX_SEC_OSNMA_SPI', 0x209106ce, 'U1'),
    UBloxCfg('MSGOUT-UBX_SEC_OSNMA_UART1', 0x209106cb, 'U1'),
    UBloxCfg('MSGOUT-UBX_SEC_OSNMA_UART2', 0x209106cc, 'U1'),
    UBloxCfg('MSGOUT-UBX_SEC_OSNMA_USB', 0x209106cd, 'U1'),
    UBloxCfg('MSGOUT-UBX_SEC_SIGLOG_I2C', 0x20910689, 'U1'),
    UBloxCfg('MSGOUT-UBX_SEC_SIGLOG_SPI', 0x2091068d, 'U1'),
    UBloxCfg('MSGOUT-UBX_SEC_SIGLOG_UART1', 0x2091068a, 'U1'),
    UBloxCfg('MSGOUT-UBX_SEC_SIGLOG_UART2', 0x2091068b, 'U1'),
    UBloxCfg('MSGOUT-UBX_SEC_SIGLOG_USB', 0x2091068c, 'U1'),
    UBloxCfg('MSGOUT-UBX_SEC_SIG_I2C', 0x20910634, 'U1'),
    UBloxCfg('MSGOUT-UBX_SEC_SIG_SPI', 0x20910638, 'U1'),
    UBloxCfg('MSGOUT-UBX_SEC_SIG_UART1', 0x20910635, 'U1'),
    UBloxCfg('MSGOUT-UBX_SEC_SIG_UART2', 0x20910636, 'U1'),
    UBloxCfg('MSGOUT-UBX_SEC_SIG_USB', 0x20910637, 'U1'),
    UBloxCfg('MSGOUT-UBX_TIM_SVIN_I2C', 0x20910097, 'U1'),
    UBloxCfg('MSGOUT-UBX_TIM_SVIN_SPI', 0x2091009b, 'U1'),
    UBloxCfg('MSGOUT-UBX_TIM_SVIN_UART1', 0x20910098, 'U1'),
    UBloxCfg('MSGOUT-UBX_TIM_SVIN_UART2', 0x20910099, 'U1'),
    UBloxCfg('MSGOUT-UBX_TIM_SVIN_USB', 0x2091009a, 'U1'),
    UBloxCfg('MSGOUT-UBX_TIM_TM2_I2C', 0x20910178, 'U1'),
    UBloxCfg('MSGOUT-UBX_TIM_TM2_SPI', 0x2091017c, 'U1'),
    UBloxCfg('MSGOUT-UBX_TIM_TM2_UART1', 0x20910179, 'U1'),
    UBloxCfg('MSGOUT-UBX_TIM_TM2_UART2', 0x2091017a, 'U1'),
    UBloxCfg('MSGOUT-UBX_TIM_TM2_USB', 0x2091017b, 'U1'),
    UBloxCfg('MSGOUT-UBX_TIM_TP_I2C', 0x2091017d, 'U1'),
    UBloxCfg('MSGOUT-UBX_TIM_TP_SPI', 0x20910181, 'U1'),
    UBloxCfg('MSGOUT-UBX_TIM_TP_UART1', 0x2091017e, 'U1'),
    UBloxCfg('MSGOUT-UBX_TIM_TP_UART2', 0x2091017f, 'U1'),
    UBloxCfg('MSGOUT-UBX_TIM_TP_USB', 0x20910180, 'U1'),
    UBloxCfg('MSGOUT-UBX_TIM_VRFY_I2C', 0x20910092, 'U1'),
    UBloxCfg('MSGOUT-UBX_TIM_VRFY_SPI', 0x20910096, 'U1'),
    UBloxCfg('MSGOUT-UBX_TIM_VRFY_UART1', 0x20910093, 'U1'),
    UBloxCfg('MSGOUT-UBX_TIM_VRFY_UART2', 0x20910094, 'U1'),
    UBloxCfg('MSGOUT-UBX_TIM_VRFY_USB', 0x20910095, 'U1'),
    UBloxCfg('NAV2-OUT_ENABLED', 0x10170001, 'L'),
    UBloxCfg('NAV2-SBAS_USE_INTEGRITY', 0x10170002, 'L'),
    UBloxCfg('NAV2-NAVSPG_ONLY_AUTHDATA', 0x10170003, 'L'),
    UBloxCfg('NAVMASK-SV_MASK_GPS', 0x50180013, 'X8'),
    UBloxCfg('NAVMASK-SV_MASK_GAL', 0x50180014, 'X8'),
    UBloxCfg('NAVMASK-SV_MASK_BDS', 0x50180016, 'X8'),
    UBloxCfg('NAVMASK-SV_MASK_QZSS', 0x50180017, 'X8'),
    UBloxCfg('NAVMASK-SV_MASK_NAVIC', 0x50180018, 'X8'),
    UBloxCfg('NAVMASK-EL_MASK_000_020', 0x50180001, 'X8'),
    UBloxCfg('NAVMASK-EL_MASK_020_040', 0x50180002, 'X8'),
    UBloxCfg('NAVMASK-EL_MASK_040_060', 0x50180003, 'X8'),
    UBloxCfg('NAVMASK-EL_MASK_060_080', 0x50180004, 'X8'),
    UBloxCfg('NAVMASK-EL_MASK_080_100', 0x50180005, 'X8'),
    UBloxCfg('NAVMASK-EL_MASK_100_120', 0x50180006, 'X8'),
    UBloxCfg('NAVMASK-EL_MASK_120_140', 0x50180007, 'X8'),
    UBloxCfg('NAVMASK-EL_MASK_140_160', 0x50180008, 'X8'),
    UBloxCfg('NAVMASK-EL_MASK_160_180', 0x50180009, 'X8'),
    UBloxCfg('NAVMASK-EL_MASK_180_200', 0x5018000a, 'X8'),
    UBloxCfg('NAVMASK-EL_MASK_200_220', 0x5018000b, 'X8'),
    UBloxCfg('NAVMASK-EL_MASK_220_240', 0x5018000c, 'X8'),
    UBloxCfg('NAVMASK-EL_MASK_240_260', 0x5018000d, 'X8'),
    UBloxCfg('NAVMASK-EL_MASK_260_280', 0x5018000e, 'X8'),
    UBloxCfg('NAVMASK-EL_MASK_280_300', 0x5018000f, 'X8'),
    UBloxCfg('NAVMASK-EL_MASK_300_320', 0x50180010, 'X8'),
    UBloxCfg('NAVMASK-EL_MASK_320_340', 0x50180011, 'X8'),
    UBloxCfg('NAVMASK-EL_MASK_340_360', 0x50180012, 'X8'),
    UBloxCfg('NAVSPG-FIXMODE', 0x20110011, 'E1'),
    UBloxCfg('NAVSPG-INIFIX3D', 0x10110013, 'L'),
    UBloxCfg('NAVSPG-WKNROLLOVER', 0x30110017, 'U2'),
    UBloxCfg('NAVSPG-USE_PPP', 0x10110019, 'L'),
    UBloxCfg('NAVSPG-UTCSTANDARD', 0x2011001c, 'E1'),
    UBloxCfg('NAVSPG-DYNMODEL', 0x20110021, 'E1'),
    UBloxCfg('NAVSPG-ACKAIDING', 0x10110025, 'L'),
    UBloxCfg('NAVSPG-USE_USRDAT', 0x10110061, 'L'),
    UBloxCfg('NAVSPG-USRDAT_MAJA', 0x50110062, 'R8'),
    UBloxCfg('NAVSPG-USRDAT_FLAT', 0x50110063, 'R8'),
    UBloxCfg('NAVSPG-USRDAT_DX', 0x40110064, 'R4'),
    UBloxCfg('NAVSPG-USRDAT_DY', 0x40110065, 'R4'),
    UBloxCfg('NAVSPG-USRDAT_DZ', 0x40110066, 'R4'),
    UBloxCfg('NAVSPG-USRDAT_ROTX', 0x40110067, 'R4'),
    UBloxCfg('NAVSPG-USRDAT_ROTY', 0x40110068, 'R4'),
    UBloxCfg('NAVSPG-USRDAT_ROTZ', 0x40110069, 'R4'),
    UBloxCfg('NAVSPG-USRDAT_SCALE', 0x4011006a, 'R4'),
    UBloxCfg('NAVSPG-INFIL_MINSVS', 0x201100a1, 'U1'),
    UBloxCfg('NAVSPG-INFIL_MAXSVS', 0x201100a2, 'U1'),
    UBloxCfg('NAVSPG-INFIL_MINCNO', 0x201100a3, 'U1'),
    UBloxCfg('NAVSPG-INFIL_MINELEV', 0x201100a4, 'I1'),
    UBloxCfg('NAVSPG-INFIL_NCNOTHRS', 0x201100aa, 'U1'),
    UBloxCfg('NAVSPG-INFIL_CNOTHRS', 0x201100ab, 'U1'),
    UBloxCfg('NAVSPG-OUTFIL_PDOP', 0x301100b1, 'U2'),
    UBloxCfg('NAVSPG-OUTFIL_TDOP', 0x301100b2, 'U2'),
    UBloxCfg('NAVSPG-OUTFIL_PACC', 0x301100b3, 'U2'),
    UBloxCfg('NAVSPG-OUTFIL_TACC', 0x301100b4, 'U2'),
    UBloxCfg('NAVSPG-OUTFIL_FACC', 0x301100b5, 'U2'),
    UBloxCfg('NAVSPG-CONSTR_ALT', 0x401100c1, 'I4'),
    UBloxCfg('NAVSPG-CONSTR_ALTVAR', 0x401100c2, 'U4'),
    UBloxCfg('NAVSPG-CONSTR_DGNSSTO', 0x201100c4, 'U1'),
    UBloxCfg('NAVSPG-CONSTR_DGNSSTO_SCALE', 0x201100c5, 'U1'),
    UBloxCfg('NAVSPG-ONLY_AUTHDATA', 0x101100dd, 'L'),
    UBloxCfg('NAVSPG-MAX_TIMETRUSTED_ACC', 0x301100de, 'U2'),
    UBloxCfg('NAVSPG-SIGATTCOMP', 0x201100d6, 'E1'),
    UBloxCfg('NAVSPG-PL_ENA', 0x101100d7, 'L'),
    UBloxCfg('NMEA-PROTVER', 0x20930001, 'E1'),
    UBloxCfg('NMEA-MAXSVS', 0x20930002, 'E1'),
    UBloxCfg('NMEA-COMPAT', 0x10930003, 'L'),
    UBloxCfg('NMEA-CONSIDER', 0x10930004, 'L'),
    UBloxCfg('NMEA-LIMIT82', 0x10930005, 'L'),
    UBloxCfg('NMEA-HIGHPREC', 0x10930006, 'L'),
    UBloxCfg('NMEA-SVNUMBERING', 0x20930007, 'E1'),
    UBloxCfg('NMEA-FILT_GPS', 0x10930011, 'L'),
    UBloxCfg('NMEA-FILT_SBAS', 0x10930012, 'L'),
    UBloxCfg('NMEA-FILT_GAL', 0x10930013, 'L'),
    UBloxCfg('NMEA-FILT_QZSS', 0x10930015, 'L'),
    UBloxCfg('NMEA-FILT_GLO', 0x10930016, 'L'),
    UBloxCfg('NMEA-FILT_BDS', 0x10930017, 'L'),
    UBloxCfg('NMEA-FILT_NAVIC', 0x10930018, 'L'),
    UBloxCfg('NMEA-OUT_INVFIX', 0x10930021, 'L'),
    UBloxCfg('NMEA-OUT_MSKFIX', 0x10930022, 'L'),
    UBloxCfg('NMEA-OUT_INVTIME', 0x10930023, 'L'),
    UBloxCfg('NMEA-OUT_INVDATE', 0x10930024, 'L'),
    UBloxCfg('NMEA-OUT_ONLYGPS', 0x10930025, 'L'),
    UBloxCfg('NMEA-OUT_FROZENCOG', 0x10930026, 'L'),
    UBloxCfg('NMEA-MAINTALKERID', 0x20930031, 'E1'),
    UBloxCfg('NMEA-GSVTALKERID', 0x20930032, 'E1'),
    UBloxCfg('NMEA-BDSTALKERID', 0x30930033, 'U2'),
    UBloxCfg('ODO-USE_ODO', 0x10220001, 'L'),
    UBloxCfg('ODO-USE_COG', 0x10220002, 'L'),
    UBloxCfg('ODO-OUTLPVEL', 0x10220003, 'L'),
    UBloxCfg('ODO-OUTLPCOG', 0x10220004, 'L'),
    UBloxCfg('ODO-PROFILE', 0x20220005, 'E1'),
    UBloxCfg('ODO-COGMAXSPEED', 0x20220021, 'U1'),
    UBloxCfg('ODO-COGMAXPOSACC', 0x20220022, 'U1'),
    UBloxCfg('ODO-VELLPGAIN', 0x20220031, 'U1'),
    UBloxCfg('ODO-COGLPGAIN', 0x20220032, 'U1'),
    UBloxCfg('PM-OPERATEMODE', 0x20d00001, 'E1'),
    UBloxCfg('PM-POSUPDATEPERIOD', 0x40d00002, 'U4'),
    UBloxCfg('PM-ACQPERIOD', 0x40d00003, 'U4'),
    UBloxCfg('PM-GRIDOFFSET', 0x40d00004, 'U4'),
    UBloxCfg('PM-ONTIME', 0x30d00005, 'U2'),
    UBloxCfg('PM-MINACQTIME', 0x20d00006, 'U1'),
    UBloxCfg('PM-MAXACQTIME', 0x20d00007, 'U1'),
    UBloxCfg('PM-DONOTENTEROFF', 0x10d00008, 'L'),
    UBloxCfg('PM-WAITTIMEFIX', 0x10d00009, 'L'),
    UBloxCfg('PM-UPDATEEPH', 0x10d0000a, 'L'),
    UBloxCfg('PM-EXTINTWAKE', 0x10d0000c, 'L'),
    UBloxCfg('PM-EXTINTBACKUP', 0x10d0000d, 'L'),
    UBloxCfg('PM-EXTINTINACTIVE', 0x10d0000e, 'L'),
    UBloxCfg('PM-EXTINTINACTIVITY', 0x40d0000f, 'U4'),
    UBloxCfg('PM-LIMITPEAKCURR', 0x10d00010, 'L'),
    UBloxCfg('QZSS-USE_SLAS_DGNSS', 0x10370005, 'L'),
    UBloxCfg('QZSS-USE_SLAS_TESTMODE', 0x10370006, 'L'),
    UBloxCfg('QZSS-USE_SLAS_RAIM_UNCORR', 0x10370007, 'L'),
    UBloxCfg('QZSS-SLAS_MAX_BASELINE', 0x30370008, 'U2'),
    UBloxCfg('RATE-MEAS', 0x30210001, 'U2'),
    UBloxCfg('RATE-NAV', 0x30210002, 'U2'),
    UBloxCfg('RATE-TIMEREF', 0x20210003, 'E1'),
    UBloxCfg('RINV-DUMP', 0x10c70001, 'L'),
    UBloxCfg('RINV-BINARY', 0x10c70002, 'L'),
    UBloxCfg('RINV-DATA_SIZE', 0x20c70003, 'U1'),
    UBloxCfg('RINV-CHUNK0', 0x50c70004, 'X8'),
    UBloxCfg('RINV-CHUNK1', 0x50c70005, 'X8'),
    UBloxCfg('RINV-CHUNK2', 0x50c70006, 'X8'),
    UBloxCfg('RINV-CHUNK3', 0x50c70007, 'X8'),
    UBloxCfg('RTCM-DF003_OUT', 0x30090001, 'U2'),
    UBloxCfg('RTCM-DF003_IN', 0x30090008, 'U2'),
    UBloxCfg('RTCM-DF003_IN_FILTER', 0x20090009, 'E1'),
    UBloxCfg('SBAS-USE_TESTMODE', 0x10360002, 'L'),
    UBloxCfg('SBAS-USE_RANGING', 0x10360003, 'L'),
    UBloxCfg('SBAS-USE_DIFFCORR', 0x10360004, 'L'),
    UBloxCfg('SBAS-USE_INTEGRITY', 0x10360005, 'L'),
    UBloxCfg('SBAS-ACCEPT_NOT_IN_PRNMASK', 0x30360008, 'X2'),
    UBloxCfg('SBAS-USE_IONOONLY', 0x10360007, 'L'),
    UBloxCfg('SBAS-PRNSCANMASK', 0x50360006, 'X8'),
    UBloxCfg('SEC-CFG_LOCK', 0x10f60009, 'L'),
    UBloxCfg('SEC-CFG_LOCK_UNLOCKGRP1', 0x30f6000a, 'U2'),
    UBloxCfg('SEC-CFG_LOCK_UNLOCKGRP2', 0x30f6000b, 'U2'),
    UBloxCfg('SEC-SPOOFDET_SIM_SIG_DIS', 0x10f6005d, 'L'),
    UBloxCfg('SEC-JAMDET_SENSITIVITY_HI', 0x10f60051, 'L'),
    UBloxCfg('SIGNAL-GPS_ENA', 0x1031001f, 'L'),
    UBloxCfg('SIGNAL-GPS_L1CA_ENA', 0x10310001, 'L'),
    UBloxCfg('SIGNAL-GPS_L2C_ENA', 0x10310003, 'L'),
    UBloxCfg('SIGNAL-GPS_L5_ENA', 0x10310004, 'L'),
    UBloxCfg('SIGNAL-SBAS_ENA', 0x10310020, 'L'),
    UBloxCfg('SIGNAL-SBAS_L1CA_ENA', 0x10310005, 'L'),
    UBloxCfg('SIGNAL-GAL_ENA', 0x10310021, 'L'),
    UBloxCfg('SIGNAL-GAL_E1_ENA', 0x10310007, 'L'),
    UBloxCfg('SIGNAL-GAL_E5A_ENA', 0x10310009, 'L'),
    UBloxCfg('SIGNAL-GAL_E5B_ENA', 0x1031000a, 'L'),
    UBloxCfg('SIGNAL-BDS_ENA', 0x10310022, 'L'),
    UBloxCfg('SIGNAL-BDS_B1_ENA', 0x1031000d, 'L'),
    UBloxCfg('SIGNAL-BDS_B1C_ENA', 0x1031000f, 'L'),
    UBloxCfg('SIGNAL-BDS_B2_ENA', 0x1031000e, 'L'),
    UBloxCfg('SIGNAL-BDS_B2A_ENA', 0x10310028, 'L'),
    UBloxCfg('SIGNAL-QZSS_ENA', 0x10310024, 'L'),
    UBloxCfg('SIGNAL-QZSS_L1CA_ENA', 0x10310012, 'L'),
    UBloxCfg('SIGNAL-QZSS_L1S_ENA', 0x10310014, 'L'),
    UBloxCfg('SIGNAL-QZSS_L2C_ENA', 0x10310015, 'L'),
    UBloxCfg('SIGNAL-QZSS_L5_ENA', 0x10310017, 'L'),
    UBloxCfg('SIGNAL-NAVIC_ENA', 0x10310026, 'L'),
    UBloxCfg('SIGNAL-NAVIC_L5_ENA', 0x1031001d, 'L'),
    UBloxCfg('FORCE-L5_HEALTHY', 0x10320001, 'L'),
    UBloxCfg('SPI-MAXFF', 0x20640001, 'U1'),
    UBloxCfg('SPI-CPOLARITY', 0x10640002, 'L'),
    UBloxCfg('SPI-CPHASE', 0x10640003, 'L'),
    UBloxCfg('SPI-EXTENDEDTIMEOUT', 0x10640005, 'L'),
    UBloxCfg('SPI-ENABLED', 0x10640006, 'L'),
    UBloxCfg('SPIINPROT-UBX', 0x10790001, 'L'),
    UBloxCfg('SPIINPROT-NMEA', 0x10790002, 'L'),
    UBloxCfg('SPIINPROT-RTCM3X', 0x10790004, 'L'),
    UBloxCfg('SPIOUTPROT-UBX', 0x107a0001, 'L'),
    UBloxCfg('SPIOUTPROT-NMEA', 0x107a0002, 'L'),
    UBloxCfg('SPIOUTPROT-RTCM3X', 0x107a0004, 'L'),
    UBloxCfg('TMODE-MODE', 0x20030001, 'E1'),
    UBloxCfg('TMODE-POS_TYPE', 0x20030002, 'E1'),
    UBloxCfg('TMODE-ECEF_X', 0x40030003, 'I4'),
    UBloxCfg('TMODE-ECEF_Y', 0x40030004, 'I4'),
    UBloxCfg('TMODE-ECEF_Z', 0x40030005, 'I4'),
    UBloxCfg('TMODE-ECEF_X_HP', 0x20030006, 'I1'),
    UBloxCfg('TMODE-ECEF_Y_HP', 0x20030007, 'I1'),
    UBloxCfg('TMODE-ECEF_Z_HP', 0x20030008, 'I1'),
    UBloxCfg('TMODE-LAT', 0x40030009, 'I4'),
    UBloxCfg('TMODE-ECEF_Z_HPCFG-TMODE-LAT', 0x20030008, 'I1'),
    UBloxCfg('TMODE-LATCFG-TMODE-LON', 0x40030009, 'I4'),
    UBloxCfg('TMODE-LON', 0x4003000a, 'I4'),
    UBloxCfg('TMODE-HEIGHT', 0x4003000b, 'I4'),
    UBloxCfg('TMODE-LAT_HP', 0x2003000c, 'I1'),
    UBloxCfg('TMODE-LON_HP', 0x2003000d, 'I1'),
    UBloxCfg('TMODE-HEIGHT_HP', 0x2003000e, 'I1'),
    UBloxCfg('TMODE-FIXED_POS_ACC', 0x4003000f, 'U4'),
    UBloxCfg('TMODE-SVIN_MIN_DUR', 0x40030010, 'U4'),
    UBloxCfg('TMODE-SVIN_ACC_LIMIT', 0x40030011, 'U4'),
    UBloxCfg('TP-PULSE_DEF', 0x20050023, 'E1'),
    UBloxCfg('TP-PULSE_LENGTH_DEF', 0x20050030, 'E1'),
    UBloxCfg('TP-ANT_CABLEDELAY', 0x30050001, 'I2'),
    UBloxCfg('TP-PERIOD_TP1', 0x40050002, 'U4'),
    UBloxCfg('TP-PERIOD_LOCK_TP1', 0x40050003, 'U4'),
    UBloxCfg('TP-FREQ_TP1', 0x40050024, 'U4'),
    UBloxCfg('TP-FREQ_LOCK_TP1', 0x40050025, 'U4'),
    UBloxCfg('TP-LEN_TP1', 0x40050004, 'U4'),
    UBloxCfg('TP-LEN_LOCK_TP1', 0x40050005, 'U4'),
    UBloxCfg('TP-DUTY_TP1', 0x5005002a, 'R8'),
    UBloxCfg('TP-DUTY_LOCK_TP1', 0x5005002b, 'R8'),
    UBloxCfg('TP-USER_DELAY_TP1', 0x40050006, 'I4'),
    UBloxCfg('TP-TP1_ENA', 0x10050007, 'L'),
    UBloxCfg('TP-SYNC_GNSS_TP1', 0x10050008, 'L'),
    UBloxCfg('TP-USE_LOCKED_TP1', 0x10050009, 'L'),
    UBloxCfg('TP-ALIGN_TO_TOW_TP1', 0x1005000a, 'L'),
    UBloxCfg('TP-POL_TP1', 0x1005000b, 'L'),
    UBloxCfg('TP-TIMEGRID_TP1', 0x2005000c, 'E1'),
    UBloxCfg('TP-PERIOD_TP2', 0x4005000d, 'U4'),
    UBloxCfg('TP-PERIOD_LOCK_TP2', 0x4005000e, 'U4'),
    UBloxCfg('TP-FREQ_TP2', 0x40050026, 'U4'),
    UBloxCfg('TP-FREQ_LOCK_TP2', 0x40050027, 'U4'),
    UBloxCfg('TP-LEN_TP2', 0x4005000f, 'U4'),
    UBloxCfg('TP-LEN_LOCK_TP2', 0x40050010, 'U4'),
    UBloxCfg('TP-DUTY_TP2', 0x5005002c, 'R8'),
    UBloxCfg('TP-DUTY_LOCK_TP2', 0x5005002d, 'R8'),
    UBloxCfg('TP-USER_DELAY_TP2', 0x40050011, 'I4'),
    UBloxCfg('TP-TP2_ENA', 0x10050012, 'L'),
    UBloxCfg('TP-SYNC_GNSS_TP2', 0x10050013, 'L'),
    UBloxCfg('TP-USE_LOCKED_TP2', 0x10050014, 'L'),
    UBloxCfg('TP-ALIGN_TO_TOW_TP2', 0x10050015, 'L'),
    UBloxCfg('TP-POL_TP2', 0x10050016, 'L'),
    UBloxCfg('TP-TIMEGRID_TP2', 0x20050017, 'E1'),
    UBloxCfg('TP-DRSTR_TP1', 0x20050035, 'E1'),
    UBloxCfg('TP-DRSTR_TP2', 0x20050036, 'E1'),
    UBloxCfg('TP-MSG_ALWAYS', 0x10050037, 'L'),
    UBloxCfg('TXREADY-ENABLED', 0x10a20001, 'L'),
    UBloxCfg('TXREADY-POLARITY', 0x10a20002, 'L'),
    UBloxCfg('TXREADY-PIN', 0x20a20003, 'U1'),
    UBloxCfg('TXREADY-THRESHOLD', 0x30a20004, 'U2'),
    UBloxCfg('TXREADY-INTERFACE', 0x20a20005, 'E1'),
    UBloxCfg('UART1-BAUDRATE', 0x40520001, 'U4'),
    UBloxCfg('UART1-STOPBITS', 0x20520002, 'E1'),
    UBloxCfg('UART1-DATABITS', 0x20520003, 'E1'),
    UBloxCfg('UART1-PARITY', 0x20520004, 'E1'),
    UBloxCfg('UART1-ENABLED', 0x10520005, 'L'),
    UBloxCfg('UART1INPROT-UBX', 0x10730001, 'L'),
    UBloxCfg('UART1INPROT-NMEA', 0x10730002, 'L'),
    UBloxCfg('UART1INPROT-RTCM3X', 0x10730004, 'L'),
    UBloxCfg('UART1OUTPROT-UBX', 0x10740001, 'L'),
    UBloxCfg('UART1OUTPROT-NMEA', 0x10740002, 'L'),
    UBloxCfg('UART1OUTPROT-RTCM3X', 0x10740004, 'L'),
    UBloxCfg('UART2-BAUDRATE', 0x40530001, 'U4'),
    UBloxCfg('UART2-STOPBITS', 0x20530002, 'E1'),
    UBloxCfg('UART2-DATABITS', 0x20530003, 'E1'),
    UBloxCfg('UART2-PARITY', 0x20530004, 'E1'),
    UBloxCfg('UART2-ENABLED', 0x10530005, 'L'),
    UBloxCfg('UART2INPROT-UBX', 0x10750001, 'L'),
    UBloxCfg('UART2INPROT-NMEA', 0x10750002, 'L'),
    UBloxCfg('UART2INPROT-RTCM3X', 0x10750004, 'L'),
    UBloxCfg('UART2OUTPROT-UBX', 0x10760001, 'L'),
    UBloxCfg('UART2OUTPROT-NMEA', 0x10760002, 'L'),
    UBloxCfg('UART2OUTPROT-RTCM3X', 0x10760004, 'L'),
    UBloxCfg('USB-ENABLED', 0x10650001, 'L'),
    UBloxCfg('USB-SELFPOW', 0x10650002, 'L'),
    UBloxCfg('USB-VENDOR_ID', 0x3065000a, 'U2'),
    UBloxCfg('USB-PRODUCT_ID', 0x3065000b, 'U2'),
    UBloxCfg('USB-POWER', 0x3065000c, 'U2'),
    UBloxCfg('USB-VENDOR_STR0', 0x5065000d, 'X8'),
    UBloxCfg('USB-VENDOR_STR1', 0x5065000e, 'X8'),
    UBloxCfg('USB-VENDOR_STR2', 0x5065000f, 'X8'),
    UBloxCfg('USB-VENDOR_STR3', 0x50650010, 'X8'),
    UBloxCfg('USB-PRODUCT_STR0', 0x50650011, 'X8'),
    UBloxCfg('USB-PRODUCT_STR1', 0x50650012, 'X8'),
    UBloxCfg('USB-PRODUCT_STR2', 0x50650013, 'X8'),
    UBloxCfg('USB-PRODUCT_STR3', 0x50650014, 'X8'),
    UBloxCfg('USB-SERIAL_NO_STR0', 0x50650015, 'X8'),
    UBloxCfg('USB-SERIAL_NO_STR1', 0x50650016, 'X8'),
    UBloxCfg('USB-SERIAL_NO_STR2', 0x50650017, 'X8'),
    UBloxCfg('USB-SERIAL_NO_STR3', 0x50650018, 'X8'),
    UBloxCfg('USBINPROT-UBX', 0x10770001, 'L'),
    UBloxCfg('USBINPROT-NMEA', 0x10770002, 'L'),
    UBloxCfg('USBINPROT-RTCM3X', 0x10770004, 'L'),
    UBloxCfg('USBOUTPROT-UBX', 0x10780001, 'L'),
    UBloxCfg('USBOUTPROT-NMEA', 0x10780002, 'L'),
    UBloxCfg('USBOUTPROT-RTCM3X', 0x10780004, 'L'),
])

ublox_msg.add_msg_list([
    UBloxMsg('ACK-ACK', 0x0105),
    UBloxMsg('ACK-NAK', 0x0005),
    UBloxMsg('CFG-CFG', 0x0906),
    UBloxMsg('CFG-MSG', 0x0106),
    UBloxMsg('CFG-OTP', 0x4106),
    UBloxMsg('CFG-PRT', 0x0006),
    UBloxMsg('CFG-RST', 0x0406),
    UBloxMsg('CFG-VALDEL', 0x8c06),
    UBloxMsg('CFG-VALGET', 0x8b06),
    UBloxMsg('CFG-VALSET', 0x8a06),
    UBloxMsg('INF-DEBUG', 0x0404),
    UBloxMsg('INF-ERROR', 0x0004),
    UBloxMsg('INF-NOTICE', 0x0204),
    UBloxMsg('INF-TEST', 0x0304),
    UBloxMsg('INF-WARNING', 0x0104),
    UBloxMsg('LOG-CREATE', 0x0721),
    UBloxMsg('LOG-ERASE', 0x0321),
    UBloxMsg('LOG-FINDTIME', 0x0e21),
    UBloxMsg('LOG-INFO', 0x0821),
    UBloxMsg('LOG-RETRIEVE', 0x0921),
    UBloxMsg('LOG-RETRIEVEPOS', 0x0b21),
    UBloxMsg('LOG-RETRIEVEPOSEXTRA', 0x0f21),
    UBloxMsg('LOG-RETRIEVESTRING', 0x0d21),
    UBloxMsg('LOG-STRING', 0x0421),
    UBloxMsg('MGA-ACK', 0x6013),
    UBloxMsg('MGA-ANO', 0x2013),
    UBloxMsg('MGA-BDS', 0x0313),
    UBloxMsg('MGA-DBD', 0x8013),
    UBloxMsg('MGA-FLASH', 0x2113),
    UBloxMsg('MGA-GAL', 0x0213),
    UBloxMsg('MGA-GLO', 0x0613),
    UBloxMsg('MGA-GPS', 0x0013),
    UBloxMsg('MGA-INI', 0x4013),
    UBloxMsg('MGA-QZSS', 0x0513),
    UBloxMsg('MON-COMMS', 0x360a),
    UBloxMsg('MON-GNSS', 0x280a),
    UBloxMsg('MON-HW', 0x090a),
    UBloxMsg('MON-HW2', 0x0b0a),
    UBloxMsg('MON-HW3', 0x370a),
    UBloxMsg('MON-IO', 0x020a),
    UBloxMsg('MON-MSGPP', 0x060a),
    UBloxMsg('MON-PATCH', 0x270a),
    UBloxMsg('MON-POST', 0x3b0a),
    UBloxMsg('MON-RCVRSTAT', 0x400a),
    UBloxMsg('MON-RF', 0x380a),
    UBloxMsg('MON-RXBUF', 0x070a),
    UBloxMsg('MON-RXR', 0x210a),
    UBloxMsg('MON-SPAN', 0x310a),
    UBloxMsg('MON-SYS', 0x390a),
    UBloxMsg('MON-TXBUF', 0x080a),
    UBloxMsg('MON-VER', 0x040a),
    UBloxMsg('NAV-AOPSTATUS', 0x6001),
    UBloxMsg('NAV-CLOCK', 0x2201),
    UBloxMsg('NAV-COV', 0x3601),
    UBloxMsg('NAV-DOP', 0x0401),
    UBloxMsg('NAV-EOE', 0x6101),
    UBloxMsg('NAV-GEOFENCE', 0x3901),
    UBloxMsg('NAV-NMI', 0x2801),
    UBloxMsg('NAV-ODO', 0x0901),
    UBloxMsg('NAV-ORB', 0x3401),
    UBloxMsg('NAV-PL', 0x6201),
    UBloxMsg('NAV-POSECEF', 0x0101),
    UBloxMsg('NAV-POSLLH', 0x0201),
    UBloxMsg('NAV-PVT', 0x0701),
    UBloxMsg('NAV-RESETODO', 0x1001),
    UBloxMsg('NAV-SAT', 0x3501),
    UBloxMsg('NAV-SBAS', 0x3201),
    UBloxMsg('NAV-SIG', 0x4301),
    UBloxMsg('NAV-SLAS', 0x4201),
    UBloxMsg('NAV-STATUS', 0x0301),
    UBloxMsg('NAV-TIMEBDS', 0x2401),
    UBloxMsg('NAV-TIMEGAL', 0x2501),
    UBloxMsg('NAV-TIMEGLO', 0x2301),
    UBloxMsg('NAV-TIMEGPS', 0x2001),
    UBloxMsg('NAV-TIMELS', 0x2601),
    UBloxMsg('NAV-TIMENAVIC', 0x6301),
    UBloxMsg('NAV-TIMEQZSS', 0x2701),
    UBloxMsg('NAV-TIMETRUSTED', 0x6401),
    UBloxMsg('NAV-TIMEUTC', 0x2101),
    UBloxMsg('NAV-VELECEF', 0x1101),
    UBloxMsg('NAV-VELNED', 0x1201),
    UBloxMsg('NAV2-CLOCK', 0x2229),
    UBloxMsg('NAV2-COV', 0x3629),
    UBloxMsg('NAV2-DOP', 0x0429),
    UBloxMsg('NAV2-EOE', 0x6129),
    UBloxMsg('NAV2-POSECEF', 0x0129),
    UBloxMsg('NAV2-POSLLH', 0x0229),
    UBloxMsg('NAV2-PVT', 0x0729),
    UBloxMsg('NAV2-SAT', 0x3529),
    UBloxMsg('NAV2-SBAS', 0x3229),
    UBloxMsg('NAV2-SIG', 0x4329),
    UBloxMsg('NAV2-STATUS', 0x0329),
    UBloxMsg('NAV2-TIMEBDS', 0x2429),
    UBloxMsg('NAV2-TIMEGAL', 0x2529),
    UBloxMsg('NAV2-TIMEGPS', 0x2029),
    UBloxMsg('NAV2-TIMELS', 0x2629),
    UBloxMsg('NAV2-TIMENAVIC', 0x6329),
    UBloxMsg('NAV2-TIMEQZSS', 0x2729),
    UBloxMsg('NAV2-TIMEUTC', 0x2129),
    UBloxMsg('NAV2-VELECEF', 0x1129),
    UBloxMsg('NAV2-VELNED', 0x1229),
    UBloxMsg('RXM-COR', 0x3402),
    UBloxMsg('RXM-MEAS20', 0x8402),
    UBloxMsg('RXM-MEAS50', 0x8602),
    UBloxMsg('RXM-MEASC12', 0x8202),
    UBloxMsg('RXM-MEASD12', 0x8002),
    UBloxMsg('RXM-MEASX', 0x1402),
    UBloxMsg('RXM-PMREQ', 0x4102),
    UBloxMsg('RXM-RAWX', 0x1502),
    UBloxMsg('RXM-RLM', 0x5902),
    UBloxMsg('RXM-RTCM', 0x3202),
    UBloxMsg('RXM-SFRBX', 0x1302),
    UBloxMsg('RXM-TM', 0x7402),
    UBloxMsg('SEC-OSNMA', 0x0a27),
    UBloxMsg('SEC-SIG', 0x0927),
    UBloxMsg('SEC-SIGLOG', 0x1027),
    UBloxMsg('SEC-UNIQID', 0x0327),
    UBloxMsg('TIM-SVIN', 0x040d),
    UBloxMsg('TIM-TM2', 0x030d),
    UBloxMsg('TIM-TP', 0x010d),
    UBloxMsg('TIM-VRFY', 0x060d),
    UBloxMsg('UPD-SOS', 0x1409),
    UBloxMsg('ACK-ACK', 0x0105),
    UBloxMsg('ACK-NAK', 0x0005),
    UBloxMsg('CFG-CFG', 0x0906),
    UBloxMsg('CFG-MSG', 0x0106),
    UBloxMsg('CFG-OTP', 0x4106),
    UBloxMsg('CFG-PRT', 0x0006),
    UBloxMsg('CFG-RST', 0x0406),
    UBloxMsg('CFG-VALDEL', 0x8c06),
    UBloxMsg('CFG-VALGET', 0x8b06),
    UBloxMsg('CFG-VALSET', 0x8a06),
    UBloxMsg('INF-DEBUG', 0x0404),
    UBloxMsg('INF-ERROR', 0x0004),
    UBloxMsg('INF-NOTICE', 0x0204),
    UBloxMsg('INF-TEST', 0x0304),
    UBloxMsg('INF-WARNING', 0x0104),
    UBloxMsg('LOG-CREATE', 0x0721),
    UBloxMsg('LOG-ERASE', 0x0321),
    UBloxMsg('LOG-FINDTIME', 0x0e21),
    UBloxMsg('LOG-INFO', 0x0821),
    UBloxMsg('LOG-RETRIEVE', 0x0921),
    UBloxMsg('LOG-RETRIEVEPOS', 0x0b21),
    UBloxMsg('LOG-RETRIEVEPOSEXTRA', 0x0f21),
    UBloxMsg('LOG-RETRIEVESTRING', 0x0d21),
    UBloxMsg('LOG-STRING', 0x0421),
    UBloxMsg('MGA-ACK', 0x6013),
    UBloxMsg('MGA-ANO', 0x2013),
    UBloxMsg('MGA-BDS', 0x0313),
    UBloxMsg('MGA-DBD', 0x8013),
    UBloxMsg('MGA-FLASH', 0x2113),
    UBloxMsg('MGA-GAL', 0x0213),
    UBloxMsg('MGA-GLO', 0x0613),
    UBloxMsg('MGA-GPS', 0x0013),
    UBloxMsg('MGA-INI', 0x4013),
    UBloxMsg('MGA-QZSS', 0x0513),
    UBloxMsg('MON-COMMS', 0x360a),
    UBloxMsg('MON-GNSS', 0x280a),
    UBloxMsg('MON-HW', 0x090a),
    UBloxMsg('MON-HW2', 0x0b0a),
    UBloxMsg('MON-HW3', 0x370a),
    UBloxMsg('MON-IO', 0x020a),
    UBloxMsg('MON-MSGPP', 0x060a),
    UBloxMsg('MON-PATCH', 0x270a),
    UBloxMsg('MON-POST', 0x3b0a),
    UBloxMsg('MON-RCVRSTAT', 0x400a),
    UBloxMsg('MON-RF', 0x380a),
    UBloxMsg('MON-RXBUF', 0x070a),
    UBloxMsg('MON-RXR', 0x210a),
    UBloxMsg('MON-SPAN', 0x310a),
    UBloxMsg('MON-SYS', 0x390a),
    UBloxMsg('MON-TXBUF', 0x080a),
    UBloxMsg('MON-VER', 0x040a),
    UBloxMsg('NAV-AOPSTATUS', 0x6001),
    UBloxMsg('NAV-CLOCK', 0x2201),
    UBloxMsg('NAV-COV', 0x3601),
    UBloxMsg('NAV-DOP', 0x0401),
    UBloxMsg('NAV-EOE', 0x6101),
    UBloxMsg('NAV-GEOFENCE', 0x3901),
    UBloxMsg('NAV-NMI', 0x2801),
    UBloxMsg('NAV-ODO', 0x0901),
    UBloxMsg('NAV-ORB', 0x3401),
    UBloxMsg('NAV-PL', 0x6201),
    UBloxMsg('NAV-POSECEF', 0x0101),
    UBloxMsg('NAV-POSLLH', 0x0201),
    UBloxMsg('NAV-PVT', 0x0701),
    UBloxMsg('NAV-RESETODO', 0x1001),
    UBloxMsg('NAV-SAT', 0x3501),
    UBloxMsg('NAV-SBAS', 0x3201),
    UBloxMsg('NAV-SIG', 0x4301),
    UBloxMsg('NAV-SLAS', 0x4201),
    UBloxMsg('NAV-STATUS', 0x0301),
    UBloxMsg('NAV-TIMEBDS', 0x2401),
    UBloxMsg('NAV-TIMEGAL', 0x2501),
    UBloxMsg('NAV-TIMEGLO', 0x2301),
    UBloxMsg('NAV-TIMEGPS', 0x2001),
    UBloxMsg('NAV-TIMELS', 0x2601),
    UBloxMsg('NAV-TIMENAVIC', 0x6301),
    UBloxMsg('NAV-TIMEQZSS', 0x2701),
    UBloxMsg('NAV-TIMETRUSTED', 0x6401),
    UBloxMsg('NAV-TIMEUTC', 0x2101),
    UBloxMsg('NAV-VELECEF', 0x1101),
    UBloxMsg('NAV-VELNED', 0x1201),
    UBloxMsg('NAV2-CLOCK', 0x2229),
    UBloxMsg('NAV2-COV', 0x3629),
    UBloxMsg('NAV2-DOP', 0x0429),
    UBloxMsg('NAV2-EOE', 0x6129),
    UBloxMsg('NAV2-POSECEF', 0x0129),
    UBloxMsg('NAV2-POSLLH', 0x0229),
    UBloxMsg('NAV2-PVT', 0x0729),
    UBloxMsg('NAV2-SAT', 0x3529),
    UBloxMsg('NAV2-SBAS', 0x3229),
    UBloxMsg('NAV2-SIG', 0x4329),
    UBloxMsg('NAV2-STATUS', 0x0329),
    UBloxMsg('NAV2-TIMEBDS', 0x2429),
    UBloxMsg('NAV2-TIMEGAL', 0x2529),
    UBloxMsg('NAV2-TIMEGPS', 0x2029),
    UBloxMsg('NAV2-TIMELS', 0x2629),
    UBloxMsg('NAV2-TIMENAVIC', 0x6329),
    UBloxMsg('NAV2-TIMEQZSS', 0x2729),
    UBloxMsg('NAV2-TIMEUTC', 0x2129),
    UBloxMsg('NAV2-VELECEF', 0x1129),
    UBloxMsg('NAV2-VELNED', 0x1229),
    UBloxMsg('RXM-COR', 0x3402),
    UBloxMsg('RXM-MEAS20', 0x8402),
    UBloxMsg('RXM-MEAS50', 0x8602),
    UBloxMsg('RXM-MEASC12', 0x8202),
    UBloxMsg('RXM-MEASD12', 0x8002),
    UBloxMsg('RXM-MEASX', 0x1402),
    UBloxMsg('RXM-PMREQ', 0x4102),
    UBloxMsg('RXM-RAWX', 0x1502),
    UBloxMsg('RXM-RLM', 0x5902),
    UBloxMsg('RXM-RTCM', 0x3202),
    UBloxMsg('RXM-SFRBX', 0x1302),
    UBloxMsg('RXM-TM', 0x7402),
    UBloxMsg('SEC-OSNMA', 0x0a27),
    UBloxMsg('SEC-SIG', 0x0927),
    UBloxMsg('SEC-SIGLOG', 0x1027),
    UBloxMsg('SEC-UNIQID', 0x0327),
    UBloxMsg('TIM-SVIN', 0x040d),
    UBloxMsg('TIM-TM2', 0x030d),
    UBloxMsg('TIM-TP', 0x010d),
    UBloxMsg('TIM-VRFY', 0x060d),
    UBloxMsg('UPD-SOS', 0x1409),
])
