rcls/gpsfreak/py/freak/plan_pll2.py

from __future__ import annotations

from .plan_dpll import DPLLPlan
from .plan_constants import *
from .plan_tools import Target, factor_splitting, fail, freq_to_str, \
    is_multiple_of, output_divider

import dataclasses

from dataclasses import dataclass
from fractions import Fraction
from math import ceil, floor, gcd
from typing import Tuple

__all__ = 'PLLPlan', 'fail', 'pll2_plan', 'pll2_plan_low'

@dataclass
class PLLPlan:
    # DPLL plan we assume.
    dpll: DPLLPlan
    # The actual frequency of PLL2, in MHz
    pll2: Fraction = Fraction(0)
    # The target frequency of PLL2, in MHz.
    pll2_target: Fraction = Fraction(0)
    # Feedback divider value for PLL2.
    multiplier: Fraction = Fraction(0)
    # Post & output dividers by channel.  A post-divider of zero means that
    # the source is PLL1, otherwise PLL2 is used.
    dividers: list[Tuple[int, int, int]] \
        = dataclasses.field(default_factory = lambda: [])

    def freq(self, i: int) -> Fraction:
        if i >= len(self.dividers):
            return Fraction(0)
        pre, s1, s2 = self.dividers[i]
        if pre <= 1:
            return self.dpll.baw / (s1 * s2)
        else:
            return self.pll2 / (pre * s1 * s2)

    def neven(self) -> int:
        count = 0
        for _, s1, s2 in self.dividers:
            if s2 == 1 and s1 & 1 == 0 or s2 & 1 == 0:
                count += 1
        return count

    def __lt__(self, b: PLLPlan | None) -> bool:
        '''Less is better.  I.e., return True if self is better than b.'''
        if b is None:
            return True
        # Prefer no error!
        a_error = abs(self.error_ratio())
        b_error = abs(b.error_ratio())
        if (a_error == 0) != (b_error == 0):
            return a_error == 0
        # Prefer to be in the officially supported range.
        if self.is_official() != b.is_official():
            return self.is_official()

        # Prefer smaller errors.
        if a_error != b_error:
            return a_error < b_error

        # Prefer even final output dividers. This gives exactly 50/50 duty
        # cycle.
        a_even = self.neven()
        b_even = b.neven()
        if a_even != b_even:
            return a_even > b_even

        # Prefer power-of-two (fixed) denomoninator.
        a_fixed = self.fixed_denom()
        b_fixed = b.fixed_denom()
        if a_fixed != b_fixed:
            return a_fixed
        # Prefer VCO2 near the middle of its range.
        a_df = abs(self.pll2 - PLL2_MID)
        b_df = abs(b   .pll2 - PLL2_MID)
        if a_df != b_df:
            return a_df < b_df

        if self.pll2 != b.pll2:
            return self.pll2 < b.pll2

        return self.dpll < b.dpll

    def validate(self) -> None:
        self.dpll.validate()
        assert self.multiplier.denominator <= 1 << 24
        assert self.pll2 == self.multiplier * self.dpll.baw / FPD_DIVIDE

    def error_ratio(self) -> float:
        return float(self.pll2 / self.pll2_target - 1)
    def error(self) -> Fraction:
        return self.pll2 - self.pll2_target

    def is_official(self) -> bool:
        return OFFICIAL_PLL2_LOW <= self.pll2 <= OFFICIAL_PLL2_HIGH

    def fixed_denom(self) -> bool:
        return (1 << 24) % self.multiplier.denominator == 0

def postdiv_mask(div: int) -> int:
    assert 2 <= div <= 7
    return 0x0101010101010101 << div | 0xfe << 8 * div

def pll2_plan_low1(target: Target, dpll: DPLLPlan,
                   freq: Fraction, post_div: int, stage1_div: int,
                   mult_den: int, stage2_div: int) -> PLLPlan | None:
    '''Try and create a PLL2 plan for a single output using the given data.
    We multiply stage2_div to get the VCO frequency in the supported range.'''
    pll2_pfd = dpll.pll2_pfd()
    ratio = freq / pll2_pfd

    output_divide = post_div * stage1_div * stage2_div
    total_divide = mult_den * output_divide
    assert total_divide % ratio.denominator == 0

    # Now attempt to multiply stage2_div by something to get us
    # into the VCO range.
    max_extra = min((1<<24) // stage2_div, PLL2_HIGH / freq // output_divide)
    min_extra = ceil(PLL2_LOW / freq / output_divide)
    if min_extra > max_extra:
        return None                     # Impossible.

    extra = floor(PLL2_MID / freq / output_divide)
    extra = max(extra, min_extra)

    # Attempt to make the stage2 divide even...
    if stage2_div % 2 != 0 and extra % 2 != 0:
        if extra < max_extra:
            extra = extra + 1
        elif extra > min_extra:
            extra = extra - 1

    stage2_div *= extra
    vco_freq = freq * output_divide
    multiplier = vco_freq / pll2_pfd
    dividers = [(0, 0, 0)] * BIG_DIVIDE
    dividers.append((post_div, stage1_div, stage2_div))

    assert PLL2_LOW <= vco_freq <= PLL2_HIGH
    assert multiplier.denominator <= 1<<24

    return PLLPlan(
        dpll = dpll,
        pll2 = vco_freq,
        pll2_target = vco_freq,
        multiplier = multiplier,
        dividers = dividers)

def _make_pd_stage1() -> dict[int, Tuple[int, int]]:
    result: dict[int, Tuple[int, int]] = dict()
    for post_div in range(2, 7+1):
        for stage1_div in range(6, 256+1):
            result[post_div * stage1_div] = post_div, stage1_div
    return result

POST_DIV_STAGE1 = _make_pd_stage1()

def pll2_plan_low_exact(target: Target, dpll: DPLLPlan, freq: Fraction,
                        fast: bool, factors: list[int]) -> PLLPlan | None:
    '''Search for a PLL2 plan generating the given frequency.

    ratio is the overall PDF-to-output multiplier.  factors should contain all
    the prime factors of ratio.denominator.  fast enables a heuristic that
    almost always succeeds and that slashes the run-time.'''

    # We definitely can't cope with any prime factors > 1<<24.
    if factors[-1] >= 1<<24:
        return None

    # We need to partition the denominator of the ratio over:
    # * The PLL2 multiplier denominator. (1 ..= 1<<24).
    # * The post divider (2 ..= 7)
    # * stage1 divider (6 ..= 256)
    # * stage2 divider (1 ..= 1<<24)
    # Scan over post dividers and the stage1 output divider.
    best = None
    ratio = freq / dpll.pll2_pfd()
    for ps1_div, (post_div, stage1_div) in POST_DIV_STAGE1.items():
        ps1_freq = freq * ps1_div
        # What we are left with needs to be factored into the PLL2 multiplier,
        # and the stage2 divider.  Do a brute force search of the denominator of
        # that.
        bigden = ratio.denominator // gcd(ratio.denominator, ps1_div)
        s2_max = min(1 << 24, PLL2_HIGH // ps1_freq)
        if bigden > s2_max << 24:
            continue            # Not acheivable.

        s2_min = ceil(PLL2_LOW / ps1_freq)
        # s2_min doesn't give a lower bound on the search, because we apply an
        # extra multiplier to bring the stage2_div into range.  However, we can
        # reject non-feasible values.
        if s2_min > s2_max:
            continue            # Not acheivable.

        # As a heuristic, limiting the denominator usually works and makes the
        # search much faster.  Or maybe we just shouldn't use python.
        fast_den_max = min(1 << 24, bigden // s2_min)
        if fast:
            den_max = fast_den_max
        else:
            den_max = 1 << 24
            # Exclude the fast==True range.
            s2_max = min(s2_max, bigden // fast_den_max)

        for stage2_div, mult_den in \
                factor_splitting(bigden, factors, s2_max, den_max):
            plan = pll2_plan_low1(target, dpll, freq,
                                  post_div, stage1_div,
                                  mult_den, stage2_div)
            if plan is not None and plan < best:
                best = plan
    return best

def pll2_plan_low(target: Target, dpll: DPLLPlan,
                  freq: Fraction) -> PLLPlan:
    '''Plan for the special case where we only have the BIG_DIVIDE output, and
    the stage2 divider is definitely needed.

    Avoid a complete brute force search over the PLL frequency range.  If
    possible, achieve the exact frequency based on factorising the frequency
    ratio.  If that fails, then multiply the frequency by arbitrary factors to
    get into a sensible range, and then use the normal PLL2 planning.'''
    assert freq < PLL2_LOW / (7 * 256)
    assert freq == target.freqs[BIG_DIVIDE]

    ratio = freq / dpll.pll2_pfd()

    # The biggest divider we can achieve is 7 * 256 * (1 << 24), and then the
    # biggest denominator on the PLL is (1<<24).  Don't waste time with
    # denominators that are bigger than all that.
    if ratio.denominator <= 7 << 56:
        # Factorize the denominator.
        from .numbers import factorize
        factors = factorize(ratio.denominator)

        # We only get called for frequencies well below PLL2_PFD = BAW_FREQ/18!
        # So the denominator should not be 1.
        assert len(factors) != 0

        plan = pll2_plan_low_exact(target, dpll, freq, True, factors)
        if plan is not None:
            return plan

        plan = pll2_plan_low_exact(target, dpll, freq, False, factors)
        if plan is not None:
            return plan

    # Ok, just fall back to a brute force search for something.  It'll only try
    # a limited part of the search space, but thats OK, we've given up on exact
    # matches.
    return pll2_plan(target, dpll,
                     [Fraction(0)] * BIG_DIVIDE + [freq], freq)

def pll2_plan1(target: Target, dpll: DPLLPlan, freqs: list[Fraction],
               pll2_freq: Fraction) -> PLLPlan | None:
    '''Try and create a plan using a particular PLL2 frequency.  Note that
    the frequency list might not include all the frequencies in the target.'''
    assert PLL2_LOW <= pll2_freq <= PLL2_HIGH
    # Bit mask of what post-divider pairs are usable.
    postdivs = (1 << 64) - 1
    # Bit mask of what post-divider pairs are usable.  Ditto, but with the
    # constraint that the final output is even.
    postdive = (1 << 64) - 1
    for i, f in enumerate(freqs):
        if not f:                       # Not needed.
            continue
        assert is_multiple_of(pll2_freq, f)
        ratio = pll2_freq // f
        if ratio <= 1:
            postdivs = 0
            break                       # Impossible.

        # Now break the ratio into a post-divider and output divider.  Attempt
        # to track which gives an even final stage divider, for 50% duty cycle.
        postdivs1 = 0
        postdive1 = 0
        for postdiv in range(2, 8):
            if ratio % postdiv != 0:
                continue
            od = output_divider(i, ratio // postdiv)
            if od is None:
                continue
            s1, s2 = od
            postdivs1 |= postdiv_mask(postdiv)
            if s1 % 2 == 0 and s2 == 1 or s2 % 2 == 0:
                postdive1 |= postdiv_mask(postdiv)
        postdivs &= postdivs1
        postdive &= postdive1
        if postdivs == 0:
            break                       # Doesn't work

    # Compute the multipliers.
    mult_exact = pll2_freq / dpll.pll2_pfd()
    mult_actual = mult_exact.limit_denominator(1 << 24)
    # Compute the post-dividers.  Use the highest possible pair.
    if postdivs == 0:
        return None                     # Doesn't work
    if postdive != 0:
        postdiv_bit = postdive.bit_length() - 1
    else:
        postdiv_bit = postdivs.bit_length() - 1
    p1 = postdiv_bit >> 3 & 7
    p2 = postdiv_bit & 7
    dividers = [(0, 0, 0)] * len(freqs)
    for i, f in enumerate(freqs):
        if not f:
            continue
        ratio = round(pll2_freq / f)
        assert isinstance(ratio, int)
        od = None
        if ratio % p1 == 0:
            od = output_divider(i, ratio // p1)
        if od is not None:
            dividers[i] = p1, od[0], od[1]
        else:
            assert ratio % p2 == 0
            od = output_divider(i, ratio // p2)
            assert od is not None
            dividers[i] = p2, od[0], od[1]

    return PLLPlan(
        dpll = dpll,
        pll2 = dpll.pll2_pfd() * mult_actual,
        pll2_target = pll2_freq,
        multiplier = mult_actual,
        dividers = dividers)

def pll2_plan(target: Target, dpll: DPLLPlan,
              freqs: list[Fraction], pll2_lcm: Fraction) -> PLLPlan:
    '''Create a frequency plan using PLL2 for a list of frequencies.

    This does a brute force search, and to get sane run times, we need there to
    be a limited number of multiples of pll2_lcm in the VCO range.  Use
    pll2_plan_low instead for the case where pll2_lcm is low.'''
    # Firstly, if frequency is too high, then we can't do it.  Good luck
    # actually getting 3125MHz through the output drivers!
    maxf = max(freqs)
    if maxf > PLL2_HIGH / 4:
        fail('Max frequency too high: {freq_to_str(maxf)}')

    # Check that some multiple of the LCM is in range.
    if ceil(PLL2_LOW / pll2_lcm) > PLL2_HIGH // pll2_lcm:
        fail(f'PLL2 needs to be a multiple of {freq_to_str(pll2_lcm)} '
             'which is not in range')

    # Range to try for multipliers.  Clamp the range to be not-too-big, for the
    # case where we've been given a small pll2_lcm.
    start = ceil(PLL2_LOW / pll2_lcm)
    end = PLL2_HIGH // pll2_lcm
    mid = PLL2_MID // pll2_lcm
    start = max(start, mid - MAX_HALF_RANGE)
    end = min(end, mid + MAX_HALF_RANGE)

    best = None
    for mult in range(start, end + 1):
        pll2_freq = mult * pll2_lcm
        assert PLL2_LOW <= pll2_freq <= PLL2_HIGH
        plan = pll2_plan1(target, dpll, freqs, pll2_freq)
        if plan is not None and plan < best:
            best = plan

    if best is None:
        fail(f'PLL2 planning failed, LCM = {freq_to_str(pll2_lcm)}')
        assert False # @!#$@!#$ pyrefly.
    return best

def test_round():
    f = Fraction('46.60376888888889')
    target = Target(freqs = [f])
    plan = pll2_plan(target, DPLLPlan(), [f], f)
    from .lmk05318b_plan import report_plan
    report_plan(target, plan, True)
    assert plan.multiplier.denominator <= 1 << 24
