rcls/gpsfreak/src/command_usb.rs

use crate::freak_usb::{CheprWriter as _, bd_main};
use crate::freak_usb::{MAIN_RX_BUF, MAIN_TX_BUF, chep_main};
use stm_common::link_assert;
use stm_common::usb;

use usb::EndpointPair;
use usb::hardware::{CheprReader, CheprWriter, chep_bd_len, copy_by_dest32};

#[derive_const(Default)]
pub struct CommandUSB;

macro_rules!dbgln {($($tt:tt)*) => {if false {crate::dbgln!($($tt)*)}};}

pub fn init() {
    // We use the PENDSV exception to dispatch some work at lower priority.
    let scb = unsafe {&*cortex_m::peripheral::SCB::PTR};
    let pendsv_prio = &scb.shpr[10];
    // Cortex-M crate has two different ideas of what the SHPR is, make sure we
    // are built with the correct one.
    link_assert!(pendsv_prio as *const _ as usize == 0xe000ed22);
    unsafe {pendsv_prio.write(crate::cpu::interrupt::PRIO_APP)};
}

impl EndpointPair for CommandUSB {
    fn rx_handler(&mut self) {
        let chep = chep_main().read();
        if !chep.VTRX().bit() {
            dbgln!("main: Spurious RX interrupt, CHEP {:#6x}", chep.bits());
            return;
        }
        dbgln!("main: RX interrupt, CHEP {:#6x}", chep.bits());

        // We notify the application by triggering PendSV.  The application
        // can notify completion, either by transmitting a message or by
        // by calling the completion function.
        let scb = unsafe {&*cortex_m::peripheral::SCB::PTR};
        unsafe {scb.icsr.write(1 << 28)};

        chep_main().write(|w| w.main().VTRX().clear_bit());
    }

    /// We have finished processing a message by sending a response. Rearm the RX.
    /// TODO: maybe we should also re-arm on a timeout, in case the user doesn't
    /// read the response?
    fn tx_handler(&mut self) {
        let chep = chep_main().read();
        if !chep.VTTX().bit() {
            dbgln!("main: Spurious TX interrupt, CHEP {:#6x}", chep.bits());
            return;
        }
        chep_main().write(|w| w.main().rx_valid(&chep).VTTX().clear_bit());
        dbgln!("main: TX done CHEP {:#06x} was {:#06x}",
                    chep_main().read().bits(), chep.bits());
    }

    fn initialize() {
        bd_main().rx_set::<64>(MAIN_RX_BUF);

        // Main.  FIXME - this can happen underneath processing a message, leaving
        // us in inconsistent state.  We should recover!
        let main = chep_main().read();
        chep_main().write(|w| w.main().init(&main).rx_valid(&main).tx_nak(&main));
    }
}

/// PendSV ISR for handling device commands at appropriate priority.
fn command_handler() {
    dbgln!("Command handler entry");

    // Get a point to the message.  TODO - copy!
    let message = unsafe {&*(MAIN_RX_BUF as *const crate::command::MessageBuf)};
    crate::command::command_handler(
        &message, chep_bd_len(bd_main().rx.read()), main_tx_response);
}

// Called at lower priority and can get interrupted!
fn main_tx_response(message: &[u8]) {
let chep = chep_main().read();
    if message.len() == 0 {
        dbgln!("main_tx_response, no data, rearm");
        chep_main().write(|w| w.main().rx_valid(&chep));
        return;
    }
    // For now we don't support long messages.
    let len = message.len().min(64);
    unsafe {copy_by_dest32(message.as_ptr(), MAIN_TX_BUF, message.len())};

    bd_main().tx_set(MAIN_TX_BUF, len);

    let chep = chep_main().read();
    chep_main().write(|w| w.main().tx_valid(&chep));

    dbgln!("main tx {len} bytes, {}CHEP now {:#06x} was {:#06x}",
                if chep.tx_active() {"INCORRECT STATE "} else {""},
                chep_main().read().bits(),
                chep.bits());
}

impl crate::cpu::Config {
    pub const fn command_usb(&mut self) -> &mut Self {
        self.vectors.pendsv = command_handler;
        self
    }
}

#[test]
fn check_isr() {
    assert!(crate::VECTORS.pendsv == command_handler);
}
