rcls/gpsfreak/py/lmk05318b_scrape.py

#!/usr/bin/python3

# To generate the input to this script, pdftotext on the TI PDF of the LMK05318b
# registers.

from freak import lmk05318b, tics
from freak.lmk05318b import Address, Field, Register

import argparse
import pickle
import re
import sys

from typing import Any

argp = argparse.ArgumentParser(description='LMK05318b scraper')
argp.add_argument('INPUT', help='Text file from pdftotext run')
argp.add_argument('--tics', '-t', help='TICS Pro .tcs file')
argp.add_argument('--output', '-o', help='Output pickle file')
argp.add_argument('--list', '-l', help='Output list file')

args = argp.parse_args()

'''RE to match start of a section'''
SECTION_RE = re.compile(r'\d+\.\d+')

'''RE to match the start of a register description section'''
REGSECT_RE = re.compile(r'\d+\.\d+ R(\d+) +\(Offset = (0x[0-9a-fA-F]+)\)')

#HEADER_RE = re.compile(r'\s*Bit\s+Field\s+Type\s+Reset\s+Description\s+$')

'''RE to match the (first line of a) field description.'''
FIELD_RE = re.compile(
    r'\s+(\d+)(:\d+)?\s+([\w:]+)\s+([/\w]+)\s+(0x[0-9a-fA-F]+)\s.*')

'''RE to match a continuation line of a field description, where the field name
is split over multiple lines.'''
CONT_RE = re.compile(r'\s{12,28}([\w:]+)\b')

addresses: dict[int, Address] = {}
address: Address | None = None
# Field currently being processed.
field: Field | None = None

for L in open(args.INPUT):
    if field is not None:
        # Check for a continuation line.
        c = CONT_RE.match(L)
        if c:
            field.name += c.group(1).upper()
            # Recalculate the bit ranges.
            field.__post_init__()
        field = None

    if SECTION_RE.match(L):
        address = None

    if L.startswith('SNAU254C') or L.startswith('Submit Doc') \
       or L.startswith('\f') or L.strip() == '':
        continue

    rs = REGSECT_RE.match(L)
    if rs:
        rnum_dec = int(rs.group(1))
        rnum_hex = int(rs.group(2), 16)
        assert rnum_dec == rnum_hex
        address = Address(rnum_dec, [])
        assert not rnum_dec in addresses
        addresses[rnum_dec] = address

    f = FIELD_RE.match(L)
    if not f:
        continue

    assert address is not None

    s_byte_hi, s_byte_lo, name, access, s_reset = f.groups()
    byte_hi = int(s_byte_hi)
    if s_byte_lo is None:
        byte_lo = byte_hi
    else:
        byte_lo = int(s_byte_lo.removeprefix(':'))
    assert byte_lo <= byte_hi

    reset = int(s_reset, 0)
    field = Field(name.upper(), byte_hi, byte_lo,
                  access, reset, address.address)
    address.fields.append(field)

# Validate what we read from the .txt file.
for address in addresses.values():
    address.validate()

def extra_field(field: Field) -> None:
    if field.address in addresses:
        address = addresses[field.address]
        address.fields.append(field)
    else:
        address = Address(field.address, [field])
        addresses[field.address] = address

    # Now redo the reserved fields...
    unseen = [True] * 8
    reset = 0
    new_fields: list[Field] = []
    for f in address.fields:
        reset |= f.reset << f.byte_lo
        if f.name != 'RESERVED':
            new_fields.append(f)
            for i in range(f.byte_lo, f.byte_hi + 1):
                unseen[i] = False

    base: int|None = None
    for i, u in enumerate(unseen):
        if not u:
            continue
        if base is None:
            base = i
        if i == 7 or not unseen[i+1]:
            rst = reset >> base & (1 << i - base + 1) - 1
            new_fields.append(Field(
                'RESERVED', i, base, 'R', rst, address.address))
            base = None
    new_fields.sort(key = lambda f: -f.byte_lo)
    address.fields = new_fields
    address.validate()

# Not all are documented..
#
# The DPLL_PL_{LOCK|UNLK}_THRESH: Not sure how many bits these actually are!
# The mapping from value to time appears to depend on the loop B/W and appears
# to be exponential.
# (They appear to be six bits.)

# From the datasheet...
extra_field(Field('DPLL_FDEV_REG_UPDATE', 0, 0, 'R/W', 0, 0x160))

# FDEV_EN is 0x15a bit 0.  TICS/Pro also uses bit 1.
# INC/DEC by pins: R346 = 1
# INC/DEC by registers: R346 = 3
# INC/DEC by DPLL numerator (absolute): R346 = 2
# I'm not sure what the extra bit acheives?
extra_field(Field('DPLL_FDEV_EXTRA', 1, 1, 'R/W', 0, 0x15a))

# Various undocumented fields are set in the TICS file.  Some are observed to
# change with the configuration, and influence outputs.
if args.tics:
    tf = tics.read_tcs_file(args.tics)
    for a, m in enumerate(tf.mask):
        if m != 0 and not a in addresses:
            val = tf.data[a]
            addresses[a] = \
                Address(a, [Field(f'UNKNOWN{a}', 7, 0, 'R/W', val, a)])

for address in addresses.values():
    address.validate()

address_list = list(addresses.values())
address_list.sort(key = lambda a: a.address)

registers = lmk05318b.build_registers(address_list)

def print_list_file(out: Any, registers: dict[str, Register]) -> None:
    regs = list(registers.values())
    regs.sort(key = lambda r: (r.base_address, -r.shift))
    for r in regs:
        print(f'{r.name:20}: {r.access:3} {r.base_address:3}', file=out, end='')
        if r.shift != 0 or r.width < 8:
            print(f'.{r.shift}', file=out, end='')
        print(f':{r.width}', file=out, end='')
        if r.byte_span != 1:
            print(f' ({r.byte_span})', file=out, end='')
        if r.reset != 0:
            if r.width <= 4:
                print(f' = {r.reset}', file=out, end='')
            else:
                w = (r.width + 3) // 4 + 2
                print(f' = {r.reset:#0{w}x}', file=out, end='')
        print(file=out)

if args.list is not None:
    print_list_file(open(args.list, 'w'), registers)
else:
    print_list_file(sys.stdout, registers)

if args.output is not None:
    pickle.dump(address_list, open(args.output, 'wb'))
