rcls/gpsfreak/py/freak/ublox_msg.py

#!/usr/bin/python3

from __future__ import annotations

import difflib
import io
from freak import serhelper
import struct

from collections.abc import ByteString
from dataclasses import dataclass
from typing import Tuple

MESSAGES_BY_CODE: dict[int, UBloxMsg] = {}
MESSAGES_BY_NAME: dict[str, UBloxMsg] = {}

def checksum(data: ByteString) -> Tuple[int, int]:
    ckA = 0;
    ckB = 0;
    for b in data:
        ckA = (ckA + b) & 255
        ckB = (ckB + ckA) & 255
    #ckA = sum(data)
    #ckB = sum((len(data) - n) * b & 255 for n, b in enumerate(data))
    return ckA, ckB

def ublox_frame(data: bytes) -> bytes:
    ckA, ckB = checksum(data)
    return bytes((0xb5, 0x62)) + data + bytes((ckA, ckB))

def test_ublox_frame_simple() -> None:
    raw = bytes((0x06, 0x8A, 0x09, 0x00, 0x00, 0x01, 0x00, 0x00,
                 0x09, 0x00, 0x05, 0x10, 0x01))
    framed = ublox_frame(raw)
    assert len(framed) == len(raw) + 4
    assert framed[0] == ord('µ')
    assert framed[1] == ord('b')
    assert framed[2: -2] == raw
    assert framed[-2] == 0xb9
    assert framed[-1] == 0x8e


@dataclass
class UBloxMsg:
    name: str
    code: int
    def frame_payload(self, b: ByteString) -> bytes:
        return ublox_frame(struct.pack('<HH', self.code, len(b)) + b)
    @staticmethod
    def get(key: int|str|UBloxMsg) -> UBloxMsg:
        if type(key) == UBloxMsg:
            return key
        if type(key) == int:
            return MESSAGES_BY_CODE[key]
        assert type(key) == str
        # Normalisation:
        # Upper case.
        # Remove 'UBLOX-' prefix.
        # '-' not '_'
        key = key.upper().removeprefix('UBX-')
        key = key.replace('_', '-', 1)
        try:
            return MESSAGES_BY_NAME[key]
        except KeyError:
            print('Did you mean?',
                  difflib.get_close_matches(key, MESSAGES_BY_NAME))
            raise
    def __repr__(self) -> str:
        return f'UBloxMsg({self.name!r}, {self.code:#06x})'

def add_msg_list(l: list[UBloxMsg]) -> None:
    for msg in l:
        MESSAGES_BY_NAME[msg.name] = msg
        MESSAGES_BY_CODE[msg.code] = msg

MAX_LENGTH = 1024

class UBloxReader:
    source: io.IOBase
    current: bytearray
    def __init__(self, source: io.IOBase):
        self.source = source
        self.current = bytearray()

    def read_more(self) -> None:
        data = self.source.read(1024)
        if data == '':
            raise EOFError()
        self.current += data

    def get_msg(self, expect: int|None = None) -> Tuple[int, bytes]:
        more = False
        while True:
            if more:
                self.read_more()
            more = True
            mu = self.current.find(b'\xb5')
            if mu < 0:
                self.current = bytearray()
                continue

            del self.current[:mu]
            if len(self.current) < 8:   # Minimum packet length.
                continue
            if self.current[1] != 0x62:
                del self.current[:1]
                continue

            length, = struct.unpack('<H', self.current[4:6])
            if length > MAX_LENGTH:
                del self.current[:2]
                continue
            msg_len = length + 8
            if len(self.current) < msg_len:
                continue
            # Ok, it looks like we have a message.
            message = bytes(self.current[:msg_len])
            del self.current[:msg_len]
            more = False
            ckA, ckB = checksum(message[2:-2])
            if message[-2] != ckA or message[-1] != ckB:
                continue

            code = struct.unpack('<H', message[2:4])[0]
            if code == expect or \
               code in (0x0105, 0x0005):
                return code, message[6:-2]

    def command(self, msg: UBloxMsg|int|str, payload: bytes = b'') -> None:
        msg = UBloxMsg.get(msg)
        serhelper.flushread(self.source)
        serhelper.writeall(self.source, msg.frame_payload(payload))
        self.source.flush()
        self.get_ack(msg.code)

    def get_ack(self, rq_code: int) -> None:
        code, payload = self.get_msg(expect = 0x0105)
        # Check we have the correct ACK.
        assert code == 0x0105, f'{code:#x}'
        assert len(payload) == 2
        assert struct.unpack('<H', payload)[0] == rq_code

    def transact(self, msg: UBloxMsg|int|str,
                 payload: bytes = b'', ack: bool = False) -> bytes:
        serhelper.flushread(self.source)
        msg = UBloxMsg.get(msg)
        serhelper.writeall(self.source, msg.frame_payload(payload))
        self.source.flush()
        code, payload = self.get_msg(expect = msg.code)
        assert code == msg.code, f'{code:#x}'
        if ack:
            self.get_ack(msg.code)

        return payload

import freak.ublox_lists # pyright: ignore[reportUnusedImport]
