rcls/gpsfreak/(commit log)

2025-08-07 Getting there with the schematic
    [clocking.kicad_sch, gpsref.kicad_sch, main.kicad_sch, output.kicad_sch, power.kicad_sch]
2025-08-08 Schematic is basically feature complete
    [clocking.kicad_sch, gps.kicad_sch, gpsref.kicad_sch, main.kicad_sch, output.kicad_sch, power.kicad_sch]
2025-08-09 Sorting out the part placement....
    [clocking.kicad_sch, cpu.kicad_sch, gps.kicad_sch, gpsref.kicad_pcb, gpsref.kicad_sch, output.kicad_sch, power.kicad_sch]
2025-08-09 First round of component distribution
    [clocking.kicad_sch, cpu.kicad_sch, gps.kicad_sch, gpsref.kicad_pcb, output.kicad_sch]
2025-08-10 Placement looks sane.
    [clocking.kicad_sch, cpu.kicad_sch, gps.kicad_sch, gpsref.kicad_pcb, output.kicad_sch, power.kicad_sch]
2025-08-11 Routing well underway
    [clocking.kicad_sch, cpu.kicad_sch, gps.kicad_sch, gpsref.kicad_pcb, output.kicad_sch, power.kicad_sch]
2025-08-11 Supercap is back
    [clocking.kicad_sch, cpu.kicad_sch, gps.kicad_sch, gpsref.kicad_pcb, output.kicad_sch]
2025-08-12 Down to the dregs and clean-ups.
    [clocking.kicad_sch, cpu.kicad_sch, gps.kicad_sch, gpsref.kicad_pcb, output.kicad_sch, power.kicad_sch]
2025-08-12 Add a U.Fl connector for fun.
    [clocking.kicad_sch, cpu.kicad_sch, gps.kicad_sch, gpsref.kicad_pcb, output.kicad_sch, power.kicad_sch]
2025-08-12 DRC clean-up. Only silk-screen noise left.
    [clocking.kicad_sch, cpu.kicad_sch, gps.kicad_sch, gpsref.kicad_pcb, output.kicad_sch, power.kicad_sch]
2025-08-12 Redo the secondary reference termination.
    [clocking.kicad_sch, gpsref.kicad_pcb]
2025-08-12 Squeeze in a connector to break out GPS.
    [clocking.kicad_sch, cpu.kicad_sch, gps.kicad_sch, gpsref.kicad_pcb, output.kicad_sch, power.kicad_sch]
2025-08-12 Tweak positioning.
    [gpsref.kicad_pcb]
2025-08-13 Silkscreen passes DRC. Also we renumbered everything.
    [clocking.kicad_sch, cpu.kicad_sch, gps.kicad_sch, gpsref.kicad_pcb, output.kicad_sch, power.kicad_sch]
2025-08-13 Sorting out part number assignments.
    [clocking.kicad_sch, cpu.kicad_sch, gps.kicad_sch, gpsref.kicad_pcb, output.kicad_sch, power.kicad_sch]
2025-08-13 Final fixes. Ordered.
    [gps.kicad_sch, power.kicad_sch]
2025-08-13 Various end and breakout boards
    [breakout-mon.kicad_pcb, breakout-mon.kicad_sch, breakout.kicad_pcb, breakout.kicad_sch, end-out.kicad_pcb, end-out.kicad_sch]
2025-08-14 Break-out and end boards as ordered
    [end-in.kicad_pcb, end-in.kicad_sch]
2025-08-26 Change the programming connector.
    Change the SMA footprint to match narrow ones.
    [cpu.kicad_sch, gps.kicad_sch, gpsref.kicad_pcb, output.kicad_sch]
2025-08-26 Tidy up pinout.
    [cpu.kicad_sch, gpsref.kicad_pcb]
2025-08-26 Ready for respin.
    [cpu.kicad_sch, gps.kicad_sch, gpsref.kicad_pcb]
2025-09-15 Tweaks. In device mode, CHEP doesn't store USB address.
    [usb.rs]
2025-09-19 Bring up the PLL.
    Lots of rearrangements.
    A really hacky GPS serial relay to debug.
2025-09-22 Getting there with the data transfer.
    setup with data out still has a problem.
    [gps_uart.rs, usb.rs]
2025-09-25 Remove the HW double buffering support, it's useless.
    We just flip the buffer descriptors instead, which is easier and
    just as fast.
    [gps_uart.rs, usb.rs]
2025-09-26 Fix-up I2C NACK handling.
    [i2c.rs]
2025-10-02 compiler_fence doesn't work how I expected. Use a combination of volatile reads and dummy asm instead.
    [command.rs, cpu.rs, freak.py, usb.rs]
2025-10-04 Support write-read I2C transactions.
2025-10-04 Reduce the Nack payload to just the error code.
    [command.rs]
2025-10-06 Turn a couple of scripts into real programs
2025-10-12 Tighten up python typing.
    [crc32.py, crc32.rs, freak.py, lmk05318b.py, lmk05318b_plan.py, lmk05318b_scrape.py, message.py, serhelper.py]
2025-10-12 First cut of config provisioning code.
2025-10-12 First cut of provisioning working
2025-10-13 UBlox provisioning appears to work. Fingers crossed.
2025-10-13 Compute device frequencies.
    Various updates.
2025-10-14 More updates to the python.
    Dance around the errata a bit more.
    [freak.py, lmk05318b_util.py, message_util.py, ublox_cfg.py, ublox_defs.py, ublox_msg.py, ublox_util.py, usb.rs]
2025-10-15 Bug fix and overclock.
    [lmk05318b_plan.py, lmk05318b_util.py]
2025-10-16 Hook in LEDs. Just triggered off commands for now
2025-10-17 Blue LED blinks on all USB activity.
2025-10-17 Handle status flags when setting a frequency plan:
    Control the PLL2 LOL masking. Force a status update after uploading the new
    plan.
    Add a status command to print all the LOL flags.
    Various other tidy-ups.
2025-10-18 Red v. green status LED.
2025-10-21 Switch clock status line to status0.
2025-10-21 Schematic updates for revision mostly done.
    [clocking.kicad_sch, cpu.kicad_sch, gps.kicad_sch, gpsref.kicad_pcb, output.kicad_sch, power.kicad_sch]
2025-10-23 Use impedance matching baluns.
    [clocking.kicad_sch, cpu.kicad_sch, gps.kicad_sch, gpsref.kicad_pcb, output.kicad_sch, power.kicad_sch]
2025-10-23 Put the two long differential lines on the front.
    [gpsref.kicad_pcb]
2025-10-23 Routing basically done.
    [clocking.kicad_sch, cpu.kicad_sch, gpsref.kicad_pcb, output.kicad_sch]
2025-10-23 DRC clean-up.
    [clocking.kicad_sch, cpu.kicad_sch, gpsref.kicad_pcb, output.kicad_sch, power.kicad_sch]
2025-10-23 Skedd connector is back.
    Route I2C to GPS and hook in the alert line.
    [clocking.kicad_sch, cpu.kicad_sch, gps.kicad_sch, gpsref.kicad_pcb]
2025-10-24 Route extint.
    [cpu.kicad_sch, gps.kicad_sch, gpsref.kicad_pcb, output.kicad_sch, power.kicad_sch]
2025-10-24 Nix a DRC error.
    [clocking.kicad_sch, gpsref.kicad_pcb, output.kicad_sch]
2025-10-24 Add bias resistors to comparators.
    [cpu.kicad_sch, end-in.kicad_pcb, end-out.kicad_pcb, gpsref.kicad_pcb, output.kicad_sch]
2025-10-24 Fatten up power traces.
    [gpsref.kicad_pcb]
2025-10-25 Simplify CMOS output structure.
    [cpu.kicad_sch, gpsref.kicad_pcb, output.kicad_sch]
2025-10-25 Remove zombie fields.
    [clocking.kicad_sch, cpu.kicad_sch, output.kicad_sch]
2025-10-28 Manufacturing updates.
    [clocking.kicad_sch, cpu.kicad_sch, gpsref.kicad_pcb, output.kicad_sch]
2025-10-29 LED refactor.
2025-10-30 First cut of DPLL planning
2025-11-01 Minor updates and fixes.
    [command.rs, config.py, lmk05318b.py, lmk05318b_plan.py, lmk05318b_scrape.py, lmk05318b_util.py, plan_dpll.py, plan_pll2.py]
2025-11-01 Rename schematic
    [clocking.kicad_sch, cpu.kicad_sch, gps.kicad_sch, gpsfreak.kicad_pcb, gpsfreak.kicad_sch, output.kicad_sch, power.kicad_sch]
2025-11-01 Various dangling footprints
2025-11-01 Remove some debug prints.
2025-11-03 Update LED handling for board variants.
2025-11-03 Print plans from the python structures instead of the config blob.
    Implement a function to reverse engineer the config blob.
2025-11-04 Minor updates.
    [clocking.kicad_sch]
2025-11-11 Make sure the status LED code doesn't spin at start-up.
    [freak.rs, lmk05318b.rs, usb.rs]
2025-11-12 SUpport for get/set name and command line selection of device.
    Also, touch up selection of even dividers.
2025-11-14 Add command for initial configuration of device.
2025-11-14 Enlarge the exposed pad under the LMK chip to 11×7 mm.
    Also change the DNP flags to avoid the balun by default.
    [gps.kicad_sch, gpsfreak.kicad_pcb, output.kicad_sch]
2025-11-15 Make all the LED resistors 0603 & adjust values.
    Move the LED inwards so it doesn't overhang.
    [cpu.kicad_sch, gpsfreak.kicad_pcb]
2025-11-15 Use a plated hole for the LED panel opening
    [end-in.kicad_pcb, end-in.kicad_sch]
2025-11-15 Remove the strap resistor on the GPS timepulse U.Fl connector.
    [gps.kicad_sch, gpsfreak.kicad_pcb]
2025-11-16 Copper fill on both sides of end-out also.
    [end-out.kicad_pcb]
2025-11-16 Tiny layout tweaks.
    [gpsfreak.kicad_pcb]
2025-11-16 Take the USB serial number from the assigned device name.
2025-11-16 Add some more TICS files. Change the default BW to 0.3Hz.
2025-11-18 Fix a unittest that regressed.
    [plan_dpll.py]
2025-11-18 Minor tidy ups and fix a stupid bug.
    [clocking.kicad_sch, gpsfreak.kicad_pcb, power.kicad_sch]
2025-11-20 A couple more command options.
2025-11-21 Update README. Minor updates and bug fixes.
    [config.py, freak.py, freak_util.py, lmk05318b.py, ublox_cfg.py, ublox_util.py]
2025-11-24 Avoid DPLL dividers too close to an integer.
    [freak.py, plan_dpll.py]
2025-11-25 Fixup the test for near-integer DPLL dividers.
    [lmk05318b_util.py, plan_dpll.py]
2025-12-03 Minor changes. Sync up I2C a bit.
2025-12-05 Use stm-common I2C.
2025-12-05 Add a couple of images to the README
2025-12-05 Fixup commanding DFU entry.
    [freak.py]
2025-12-05 Start on abstracting out USB driver.
2025-12-06 Track changes to debug.
2025-12-06 Cratize i2c.
2025-12-07 Track I2C changes.
2025-12-07 Share some interrupt setup code. Various rationalisation.
2026-01-24 Add PDFs of schematic and PCB.
2026-03-24 Add LCSC part numbers for a few items.
    Don't 'exclude from BOM' things we want to assemble.
    [clocking.kicad_sch, cpu.kicad_sch, gps.kicad_sch, gpsfreak.kicad_pcb, output.kicad_sch, power.kicad_sch]
2026-03-26 Tweaks to python scripts.
    Add part numbers for the LED and 470nF C0G capacitor.
    [clocking.kicad_sch, cpu.kicad_sch, gps.kicad_sch]
2026-03-26 Update all the PCB footprints to match latest kicad.
    Use our own SC-70, the latest kicad footprint has oversized pads.
    [gpsfreak.kicad_pcb, output.kicad_sch]
2026-03-26 Adjust the footprint of the RGB LED to make it closer to the datasheet.
    [gpsfreak.kicad_pcb]
2026-03-26 Instead, switch to a RGB LED footprint from Paul Elliot.
    [cpu.kicad_sch, gpsfreak.kicad_pcb]
2026-03-26 Split each output onto it's own sheet.
    Makes it easier to mix'n'match output types for board spins.
    [clocking.kicad_sch, gpsfreak.kicad_pcb, gpsfreak.kicad_sch, output-diff-sma.kicad_sch, output-opt-balun.kicad_sch, output-tlv3601.kicad_sch, output.kicad_sch]
2026-03-28 Touch up net names.
    [clocking.kicad_sch, gpsfreak.kicad_pcb, gpsfreak.kicad_sch, output-diff-sma.kicad_sch]
2026-04-12 Update comment.
    [gps.kicad_sch, output-tlv3601.kicad_sch]
2026-04-16 I ran kicad10 so now all the schematics are kicad10.
    [clocking.kicad_sch, cpu.kicad_sch, gps.kicad_sch, gpsfreak.kicad_pcb, gpsfreak.kicad_sch, output-diff-sma.kicad_sch, output-opt-balun.kicad_sch, output-tlv3601.kicad_sch]
2026-04-17 Use the correct wIndex for entering DFU.
    [freak.py]
2026-04-18 Make `freak info` work if the temperature sensor is not populated.
2026-04-27 Fix an off-by-one in the OUT7 divider calculation.
    The DIV1 divider-by-6, register value 5 is not usable, despite what the docs say.
    [plan_tools.py]
2026-05-02 When reporting device frequencies with fixed (1<<24) denominator, report that correctly.
    [command.rs, freak_util.py, lmk05318b_plan.py, plan_tools.py]
2026-06-07 Add commands for I2C access to the GPS unit.
    The hardware works. But should we expose this as a USB end-point instead?
2026-06-07 Make the LED timer bit width a compile time option.
    Avoid an unnecessary cast.
    [led.rs, usb.rs]
2026-06-07 Inconsequential board tidy-ups.
    [gps.kicad_sch, gpsfreak.kicad_pcb]
